christophmuellerorg/VoronUsers/printer_mods/README.md

# Mods

Printer mods for Voron 3D printers
Remember to update this README when uploading new mod!

## Legacy printers

Mods for legacy printers can be found [here](../legacy_printers/printer_mods).
If one of your mods applies to a current generation Voron printer, contact the admins in
Discord to have your mod moved to this folder.

## Table structure

Update the following table with the information about your mod:
- Your name
- A link to your sub-folder
- A short description of your mod
- The printer compatibility. Use `:heavy_check_mark:` for :heavy_check_mark:,`:x:` for :x: and `:grey_question:` for :grey_question:

like so:
`
| Creator | [Mod title](link) | Description | :x: | :x: | :x: |`

---

| Creator | Mod title | Description | V0 | V1.8 | V2.4 |
| --- | --- | --- | --- | --- | --- |
|aeresov|[TL filament sensor bracket](./aeresov/TL_filament_sensor_bracket)|A bracket for TL filament sensor to mount near stock spool holder. |:x:|:grey_question:|:heavy_check_mark:|
||[MeanWell UHP-xxx DIN mount](./aeresov/TL_filament_sensor_bracket)|A bracket for MeanWell UHP series PSU (200, 350 and 500) to mount it across 2 DIN rails.|:x:|:grey_question:|:heavy_check_mark:|
|arkeet|[Dial test indicator mount](./arkeet/dti-mount)|A toolhead mount for a dial test indicator, where the tip is located at the nozzle. |:x:|:heavy_check_mark:|:heavy_check_mark:|
|claytono|[Voron 2.4 Extrusion Jig](./claytono/2.4-extrusion-jig)|A jig help align extrusions to get a properly square frame |:x:|:x:|:heavy_check_mark:|
|Badnoob |[Precision AB Drive](./Badnoob/Precision_AB_Drive)|Changes the gearing for the AB drives to improve both resolution and torque, with a strenthened frame. |:grey_question:|:grey_question:|:heavy_check_mark:|
| |[Rail Alignment](./Badnoob/Rail_Alignment)|Tools and procedure to properly align the rails in 2.4 and Afterburner|:x:|:x:|:heavy_check_mark:|
|BlueBear|[Deck Panel Backpack](./BlueBear/Deck_Panel_Backpack)|A mounting alternative if you don't want to drill your deck panel | :heavy_check_mark: | :x: | :x: |
| d3nny | [Filtered Power Plug with RND_165-00057](./d3nny/mains_plug_panel_for_RND_165-00057) | Filtered Power Plug for RND 165-00057 and CAT6-Plug | :x: | :x: | :heavy_check_mark: |
|Dan88 |[V0 one-part Skirts](./Dan88/V0skirt) |One part Skirts for the V0 |:heavy_check_mark: |:x: |:x: |
|DorjeDorf | [Duet 3 6HC Din Bracket](./DorjeDorf/Duet_3_6HC_Din_Bracket) | V2.4 Duet 3 6HC Din Bracket | :x: | :x: | :heavy_check_mark: |
| |[Duet 3 3HC Din Bracket](./DorjeDorf/Duet_3_3HC_Din_Bracket) |  V2.4 Duet 3 3HC Din Bracket | :x: | :x: | :heavy_check_mark: |
|DrGhetto|[Ghetto Panels](./DrGhetto/GhettoPanels)|Printed panels for the Voron Zero|:heavy_check_mark:|:x:|:x:|
|eddie |[V1.8 12mm Z Mod](./eddie/V1.8_12mm_Z_Mod) |Add V1.8 option for 12mm Z rods |:x: |:heavy_check_mark: |:x: |
|edwardyeeks |[Decontaminator Purge Bucket & Nozzle Scrubber](./edwardyeeks/Decontaminator_Purge_Bucket_&_Nozzle_Scrubber) |Removeable purge bucket with nozzle scrubber |:x: |:heavy_check_mark: |:heavy_check_mark: |
| |[V2.4 Z Drive Motor Tensioner Mod](edwardyeeks/V2.4_z_drive_motor_tensioner_mod) |Braced motor tensioner for z drive |:x: |:x: |:heavy_check_mark: |
| Ellis |[15x15 Drag Chain Ends](./Ellis/15x15_Drag_Chain_End) | 15x15 drag chain end pieces | :grey_question: | :grey_question: |:heavy_check_mark: |
| |[Badge Retractor Mount](./Ellis/Badge_Retractor_Mount) | Extrusion mount for badge retractor to keep bowden tube out of the way. | :grey_question: | :grey_question: |:heavy_check_mark: |
| |[Short Z Joints](./Ellis/Short_Z_Joints) | Shorter Z joints for the v2.4 |:x: |:x: |:heavy_check_mark: |
| FreeformFez | [V1.8 Filtered Power Inlet](./FreeformFez/FilteredPower) | V1.6 Filtered Inlet and Rocker Switch for V1.8 | :x: | :heavy_check_mark: | :x: |
| GSL12 | [Pocketwatch Nema 17](./GSL12/pocketwatch_nema17)| Extruder like Pocketwatch, but with Nema17 instead of Nema14. Maybe for V0 fork with 2020 extrusions, Nema17 and MGN9 or other printers. | :grey_question: | :grey_question: | :grey_question: |
| hartk1213 | [Voron0_deck_panel_with_logo_and_VORON0](./hartk1213/Voron0_deck_panel_with_logo_and_VORON0) | Used @Kruppes blank deck panel to add the logo as well as the name VORON0 | :heavy_check_mark:| :x: | :x: |
| | [Voron0_display_dualcolor](./hartk1213/Voron0_display_dualcolor) | Added a dual color file for the Voron Display Front housing | :heavy_check_mark:| :x: | :x: |
| | [Voron0_C14Inlet](./hartk1213/Voron0_C14Inlet) | Added a new Power inlet that uses a Fused C14 plug and switch that covers the mains contacts  | :heavy_check_mark:| :x: | :x: |
| | [Voron0_Hinged_Top_Hat](./hartk1213/Voron0_Hinged_Top_Hat) | Created a new hinged top hat design for the V0 so it can fold away when you dont want a top hat on  | :heavy_check_mark:| :x: | :x: |
| hernsl | [Bottom Panel Mag Clip](./hernsl/bottom_panel_mag_clip) | v2.4 magnetic clips to retain bottom panel | :x: | :x: | :heavy_check_mark: |
|hijax_pl_ |[Corner panel clip](./hijax_pl/corner_panel_clip) |V2 panel corner frames using 3-way L brackets in the corners |:x: |:x: |:heavy_check_mark: |
| |[Din Rail mount](./hijax_pl/din_rail_mount) |Adapter to attach DIN Rail to 2020 extrusion. |:x: |:x: |:heavy_check_mark: |
| |[Controler Board adapters](./hijax_pl/ender_compatible_controller_mount) |DIN (rotated) and legacy adapters for boards like SKR mini E3. |:grey_question: |:x: |:heavy_check_mark: |
|Iakabos| [c920_Mount](./Iakabos/C920_mount)|Slim mount for logitech c920 webcam|:x:|:heavy_check_mark:|:heavy_check_mark:|
| | [V0 beltchains](./Iakabos/V0_beltchain)|Modified beltchain parts for V0 Z cables|:heavy_check_mark: |:x: |:x: |
|jasonc |[V2.4 Z-Idler Shoulder Bolt Mod](./jasonc/Z_Idler_Shoulder_Bolt) |Modification to the idler carriers to accept a 25mm shoulder bolt. Ideal for Gates idlers. |:x: |:x: |:heavy_check_mark: |
| kirby | [V0 Sherpa Mini Direct Drive Mod](./kirby/v0_sherpa_mini_direct_drive)| A direct drive mod for the V0 using the Annex Sherpa Mini extruder | :heavy_check_mark: | :x: | :x: |
|Kruppes |[V0 Printed Deck with inserts](./Kruppes/Deck_Panel_inserts_logo) |Electronics Deck Panel using brass heat inserts. Optional with accent color Voron Logo. |:heavy_check_mark: |:x: |:x: |
| |[Encosed Bottom](./Kruppes/Closed_Bottom) | Modified printed parts and panel to fully enclose V0. |:heavy_check_mark: |:x: |:x: |
|littleferris |[V0 c14 Skirt Inlet](./littleferris/V0_Skirt_Inlet) |V0 C14 Skirt inlet |:heavy_check_mark: |:x: |:x: |
|madros |[V0 OLED-skirt](./madros/V0_skirt_OLED) |V0 skirt with 0.96" OLED|:heavy_check_mark: |:x: |:x: |
|MarcPot |[UHP PSU Bracket Clip](./MarcPot/UHP_PSU_Bracket_Clip)|DIN rail mount for the Mean Well UHP series PSU. |:grey_question: |:grey_question: |:heavy_check_mark: |
| |[Hour Counter Skirt + Keystone Skirt](./MarcPot/Skirt_Mods)|Skirt mod for a mechanical hour counter and keystone inserts |:x: |:x: |:heavy_check_mark: |
|mjoaris |[10x11 Cable Chain Endcaps](./mjoaris/10x11_Cable_Chain_Endcaps) |Printable Endcaps for 10x11 Cable Chains |:x: |:heavy_check_mark: |:heavy_check_mark: |
| |[Mini12864 LCD Mount](./mjoaris/Mini12864_LCD_Mount_for_V2.4) |Swiveling case for the Fysetc Mini12864 LCD |:x: |:grey_question: |:heavy_check_mark: |
|Mosher|[Door hinges with M3 screws shafts](./mosher/m3_door_hinges) |Simple mod of print in place door hinges, which uses m3 screws as shafts. |:x:|:x:|:heavy_check_mark:|
|natewalck |[V1.8 Jigs](./natewalck/v1.8_Jigs) |Jigs for assembling V1.8 |:x: |:heavy_check_mark: |:x: |
|Nomsplease |[60mm Shaft Jig](./Nomsplease/60mm_Shaft_Jig) |Simple jig for cutting and grinding 60mm Z shafts |:x: |:x: |:heavy_check_mark: |
| |[Duet Wifi Mount](./Nomsplease/V0_Mods/duet_wifi_mount) | Duet wifi mount in pocketwatch location |:heavy_check_mark: |:x: |:x: |
| |[LED Mounts](./Nomsplease/V0_Mods/led_mounts) | Basic LED mounts for 10 and 12mm strips |:heavy_check_mark: |:x: |:x: |
| |[Remixed Panel Mounts](./Nomsplease/V0_Mods/panel_mounts) | Remixed rear bottom panel mounts with stop |:heavy_check_mark: |:x: |:x: |
| |[Pi Cam/ZeroW Mount](./Nomsplease/V0_Mods/pi_zero_camera_mount) | Mount for pi camera and ZeroW |:heavy_check_mark: |:x: |:x: |
| |[Pocket Watch Rear Reolcation Bracket](./Nomsplease/V0_Mods/pocket_watch_rear_relocation) | Pocket watch rear reolcation bracket |:heavy_check_mark: |:x: |:x: |
|randell |[Door Hinges](./randell/Door_Hinges) |Door hinges that use an M3 bolt for a pin and bolts thru the panel |:x: |:x: |:heavy_check_mark: |
||[Microswitch Pod for PCB](./randell/Microswitch_Endstop) |Modified endstop pod for use of endstop switches mounted on a PCB |:x: |:x: |:heavy_check_mark: |
| raymondh | [Large Spool Holders](./raymondh/LargeSpoolHolders) | Larger spool holders for KVP spools | :x: | :heavy_check_mark: | :heavy_check_mark: |
|Rhastlyn |[Wansview 1080p Camera Mount](./Rhastlyn/WansviewCameraMount) |A camera mount that replaces the OEM part to allow the camera to be mounted to a 2020 extrusion | :x: |:grey_question: |:heavy_check_mark: |
| |[60mm Fan Cover](./Rhastlyn/60mmFanCover)|A easy to install cover for spec 60mm fans originally designed for a 2.4 build| :x: |:grey_question: |:heavy_check_mark: |
| Slidr | [PanzerChain 2.4](./Slidr/PanzerChain2.4) | Energychain for V2.4 | :x: | :x: | :heavy_check_mark: |
| Spaghetti-Bolognese |[Simplified Z Drive Motor Mount](Spaghetti-Bolognese/Z_drive_motor_mount) | Z drive motor mount bracket mod to improve pulley to belt alignment | :x: | :x: | :heavy_check_mark: |
| |[LCD Case Mod](Spaghetti-Bolognese/LCD_case_mod) | Improvements to the V2.4 mini12864 LCD case inc E-stop button cover | :x: | :x: | :heavy_check_mark: |
|StvPtrsn |[Skirts for a 320mm Build](./StvPtrsn/320mm_Build) |Skirts for a 320mm build |:x: |:x: |:heavy_check_mark: |
| |[Keystone Jack for Filtered Mains Panel](./StvPtrsn/Keystone_Jack_Filtered_Mains_Panel) |Add a keystone jack to your filtered mains plug panel |:x: |:x: |:heavy_check_mark: |
| |[Side Fan Support, No Tape](./StvPtrsn/Side_Fan_Support_No_Tape) |Mount the 60mm side fans and inserts without tape |:x: |:x: |:heavy_check_mark: |
| tameike | [Din Rail SKR 90 deg](./tameike/DIN_Rail_SKR_1.3_90deg) | SKR V1.3 bracket turned 90 degrees | :x: | :grey_question: | :heavy_check_mark: |
| | [Din Rail 2020 Holder](./tameike/DIN_Rail_2020_holder) | Attaching DIN Rails to 2020 | :x: | :grey_question: | :heavy_check_mark: |
| | [TacoRaven Mounting Frame](./tameike/V0_TR_Mounting_Frame) | TR V0 mount | :heavy_check_mark: | :x: | :x: |
| | [Jetpack V0 base](./tameike/Jetpack_V0)| Attach Jetpack to V0 frame | :heavy_check_mark: |:x: |:x: |
| tayto-chip | [V2.4 Skirt Switch Mod](./tayto-chip/skirt_switch_mod) | Add a ON/OFF Switch to side or front skirts| :x: | :x: | :heavy_check_mark: |
| warriorofwire | [Slenderfan for Afterburner](./warriorofwire/slenderfan) | Lighter, quieter, smaller Afterburner | :x: | :x: | :heavy_check_mark: |
| Weaslus | [Electronics Bay and Enclosure Seperator](./Weaslus/Electronics-Bay-Seperator) | Better enclose chamber and keep heat from electronics | :heavy_check_mark: | :x: | :x: |
| xbst_ | [PCB LED Holder](./xbst_/LED_Holder)| Very simple mount for some (?) PCB LED Bars | :x: |:heavy_check_mark: |:heavy_check_mark: |
| | [DIN Mount Omron Relay](./xbst_/Omron_DIN_Mount)| A simple DIN rail mount for the BOM Relay | :x: | :heavy_check_mark: |:heavy_check_mark: |
| | [DIN Mount Pi 4x Relay Board](./xbst_/Relay_DIN_Mount)| A simple DIN rail mount for the 4 channel relay board for Raspberry Pi | :x: | :heavy_check_mark: |:heavy_check_mark: |
| | [DIN Mount Max31865](./xbst_/Max31865_DIN_Mount)| A simple DIN rail mount for the Adafruit (or SAME SIZE clone) MAX31865 PT100 Board. | :x: | :heavy_check_mark: |:heavy_check_mark: |
| | [Car Hood Style Bed Hinge](./xbst_/Bed_Hinge)| A way of reaching electronics from the top by having a "car hood" style hinge for the heatbed, and rotated electronics mounts. | :x: | :x: |:heavy_check_mark: |
| | [Flat V2.4 Skirts](./xbst_/Flat_Skirts) | Flat V2.4 Skirts so a panel without cutouts can be used | :x: | :x: |:heavy_check_mark: |
| | [V2.4 Fanless Middle Skirt](./xbst_/V2.4_Fanless_Middle_Skirt)| A Fanless alternative middle side skirt | :x: | :x: |:heavy_check_mark: |
| | [Duct Mount](./xbst_/Duct_Mount) | 100mm/4" ducting mount for ventilation. Also supports umbilical cord and has 3 orientations for bowden adapter. | :x: | :x: |:heavy_check_mark: |
| | [HOYMK SSR Mount](./xbst_/HOYMK_SSR_Mount) | Mount for Chinese HOYMK SSR | :heavy_check_mark: | :x: | :x: |
| | [ADXL345 V0 Mount](./xbst_/ADXL345_V0_Mount) | V0 Mount for a ADXL345 module | :heavy_check_mark: |:x: |:x: |
| | [Easy Access Rear Panels](./xbst_/Easy_Access_Rear_Panels_v0) | New rear panels designed to expose the extruder for easy filament swapping | :heavy_check_mark: | :x: |:x: |
| | [Hat LED Mount](./xbst_/Hat_LED_Mount) | Top Hat LED module mount | :heavy_check_mark: |:x: |:x: |
| | [ZipClip V0](./xbst_/ZipClip_v0) | Very simple ziptie mount for v0 1515 extrusions | :heavy_check_mark: |:x: |:x: |
| | [Screwed Front Door Hinge](./xbst_/V0_Screw_Front_Hinge_Mod)| Mod to screw the front door panel (instead of VHB) | :heavy_check_mark: | :x: | :x: |
| | [DuetZero](./xbst_/DuetZero) | Pi Zero mount over a Duet2 for space saving | :heavy_check_mark: |:heavy_check_mark: |:heavy_check_mark: |

---
