christophmuellerorg/VoronUsers/printer_mods/Slidr/PanzerChain2.4/OverviewLarge.JPG

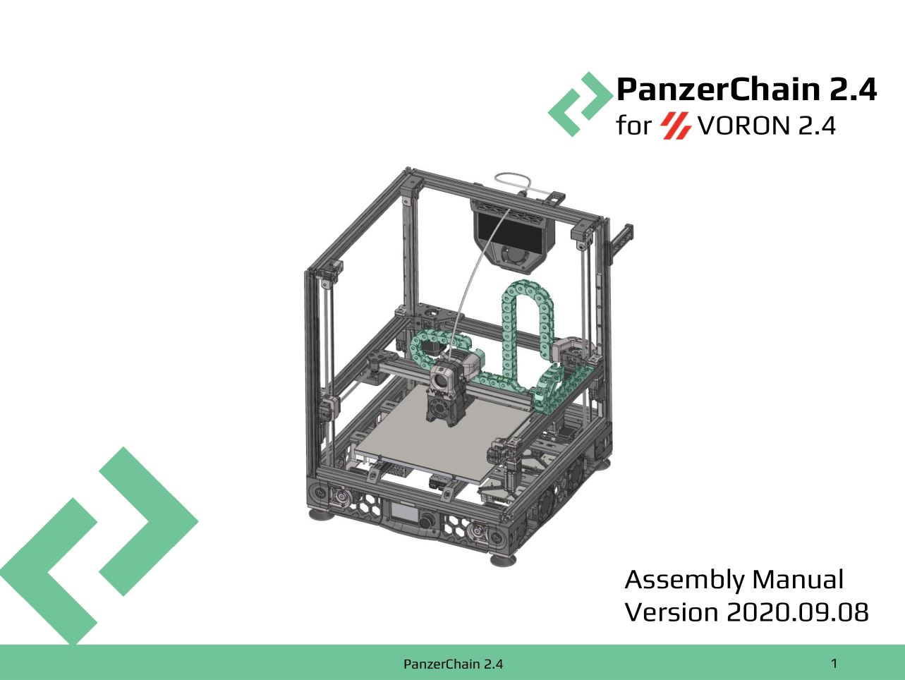
printer_mods/Slidr/PanzerChain2.4/OverviewLarge.JPG
