christophmuellerorg/VoronUsers/printer_mods/Weaslus/Electronics-Bay-Seperator/Seperator.png

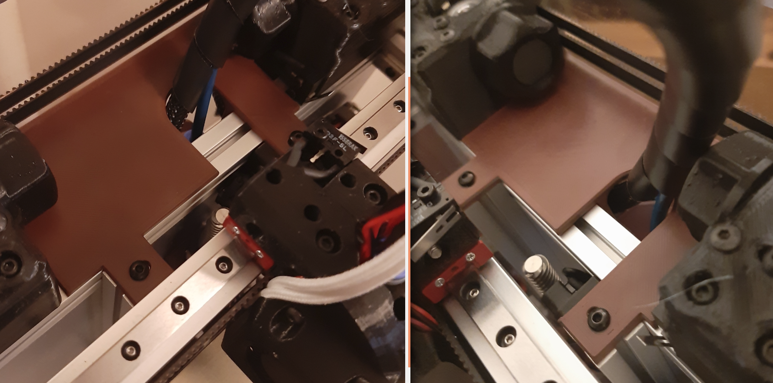
printer_mods/Weaslus/Electronics-Bay-Seperator/Seperator.png
