christophmuellerorg/VoronUsers/slicer_configurations/PrusaSlicer/hartk1213/V0/Bed_Shape/Images/screenshot.png

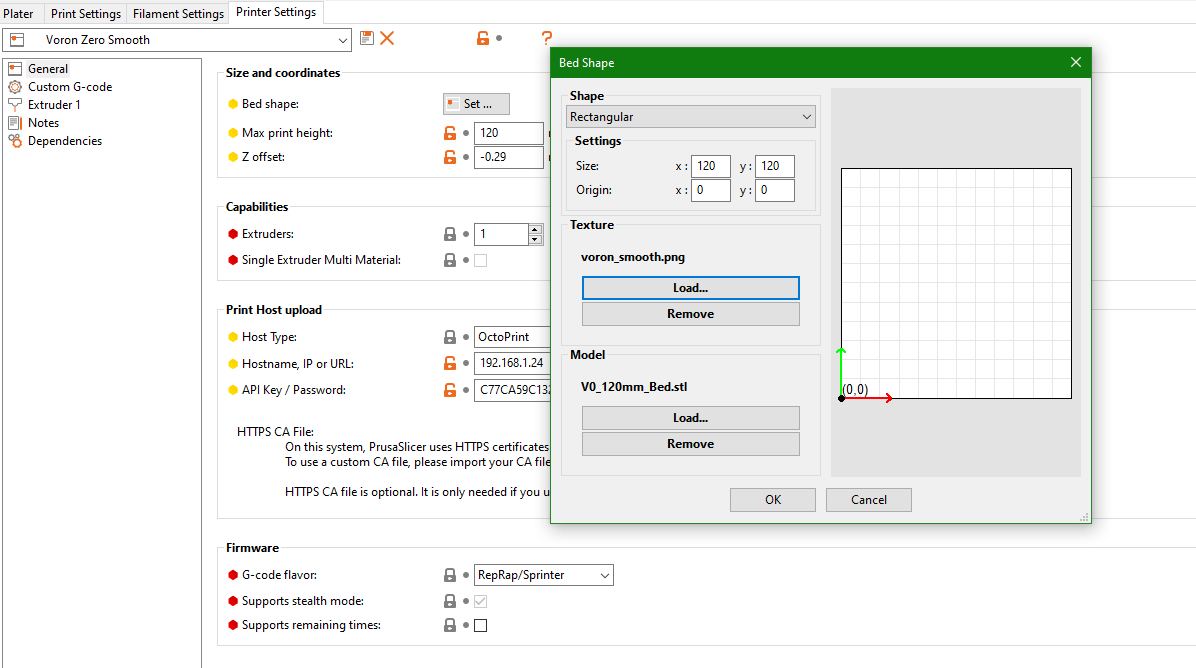
slicer_configurations/PrusaSlicer/hartk1213/V0/Bed_Shape/Images/screenshot.png
