christophmuellerorg/VoronUsers/slicer_configurations/PrusaSlicer/hartk1213/V0/Bed_Shape/Texture/voron_textured.png

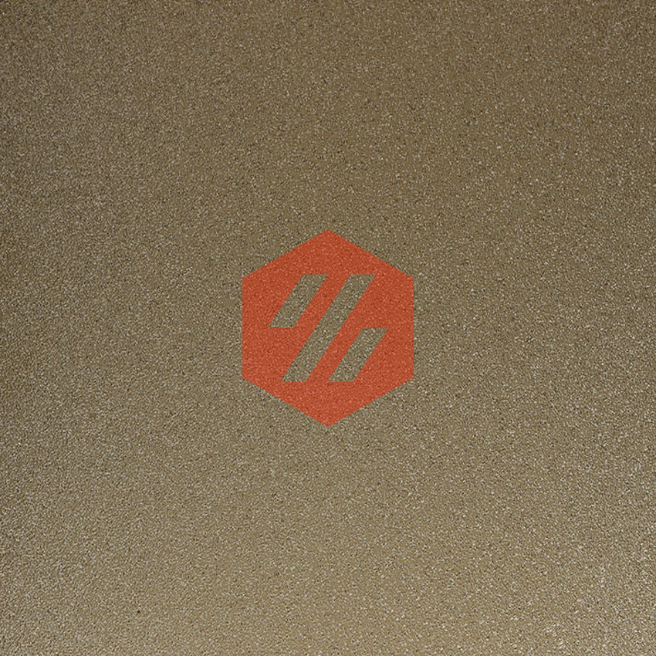
slicer_configurations/PrusaSlicer/hartk1213/V0/Bed_Shape/Texture/voron_textured.png
