christophmuellerorg/VoronUsers/slicer_configurations/Simplify3D/hijax_pl/beds/Voron2_beds.png

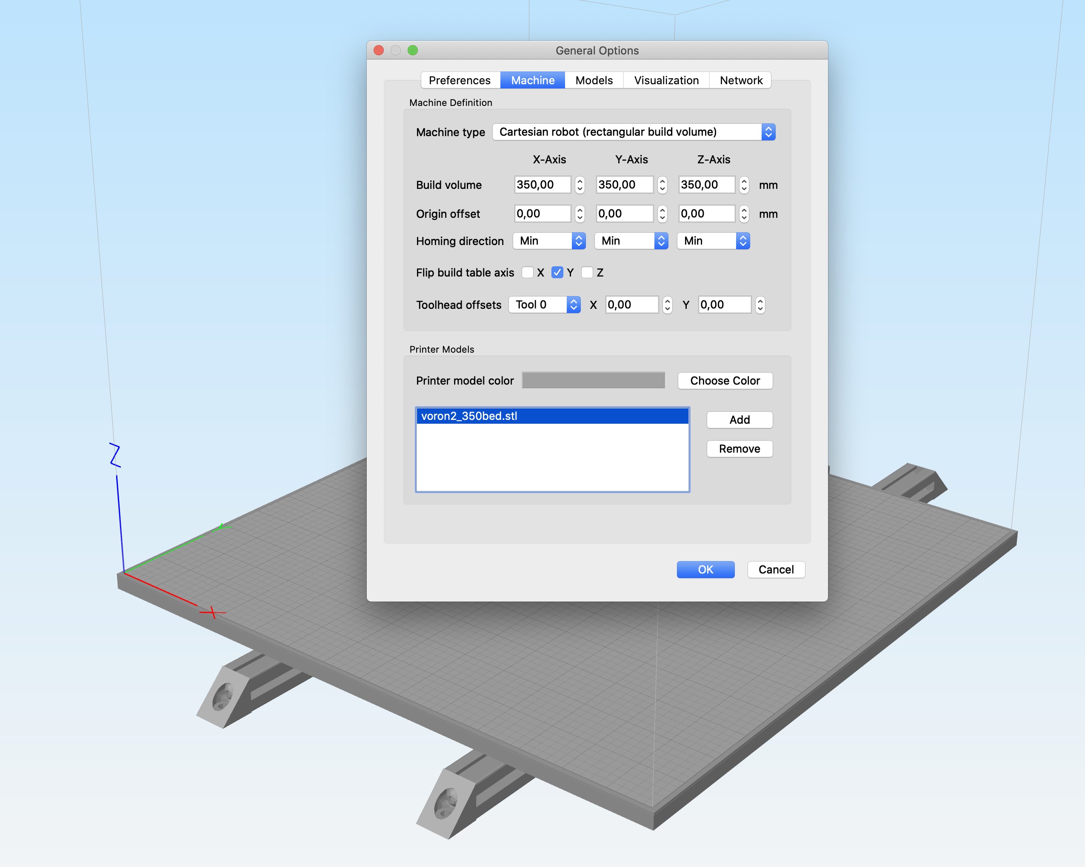
slicer_configurations/Simplify3D/hijax_pl/beds/Voron2_beds.png
