christophmuellerorg/VoronUsers/slicer_configurations/SuperSlicer/koonweee/beds/V1.8_SS_Bed.png

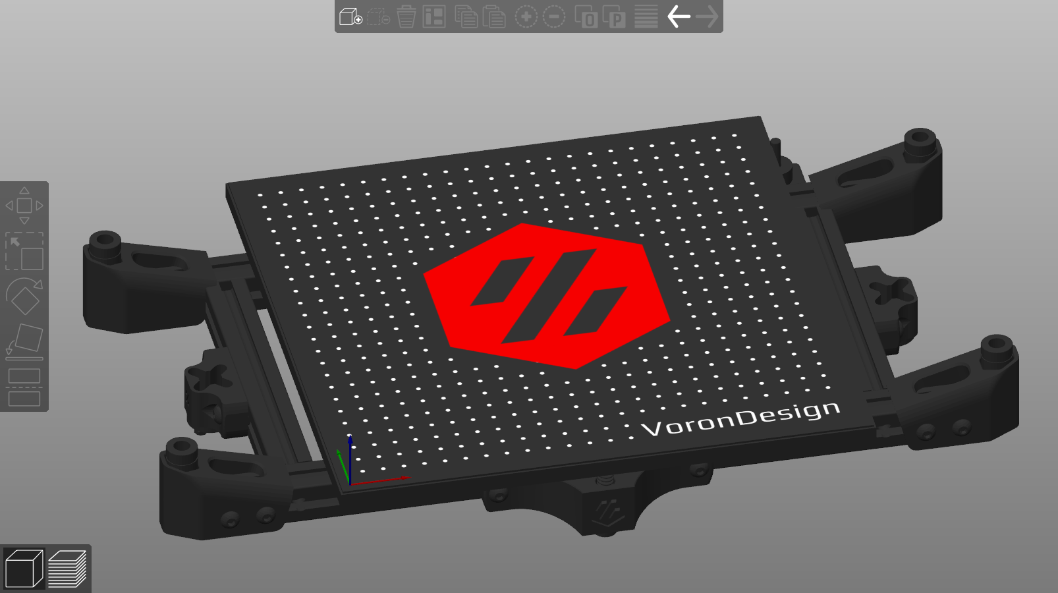
slicer_configurations/SuperSlicer/koonweee/beds/V1.8_SS_Bed.png
