christophmuellerorg/VoronUsers/printer_mods/hartk1213/Voron0_Hinged_Top_Hat/BOM/Voron0_Hinged_Top_Hat_BOM.xlsx

1515 Extrusions | Length | Qty
1515 x 200mm | 200 | 5 | 5
1515 X 170 | 170 | 2 | 2
1515 x 95 | 95 | 2 | 1
1515 x 80 | 80 | 2 | 1
Enclosure Panels
Location | Dimensions | Qty
Front | 212x76 | 1
Sides | 182x76 | 2
Top | 212x212 | 1
Rear | 212x59 | 1
BOM
Screws
Size | Qty
M3x8 | 62
M3x12 | 4
M3x16 | 2
M3x20 | 4
M3 Nuts | 58
