christophmuellerorg/VoronUsers/printer_mods/d3nny/mains_plug_panel_for_RND_165-00057/mains_plug_panel_filtered_for_RND_165-00057_V24.stl

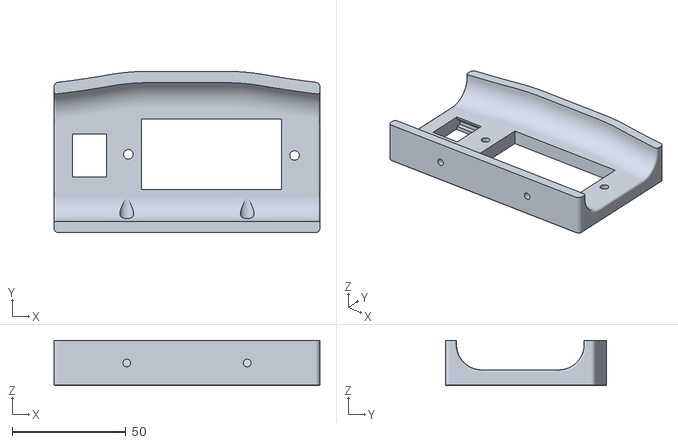
[picture p8: CAD file, 2020-11-01]
printer_mods/d3nny/mains_plug_panel_for_RND_165-00057/mains_plug_panel_filtered_for_RND_165-00057_V24.stl
117.0 x 71.0 x 20.0
