christophmuellerorg/VoronUsers/printer_mods/eddie/V1.8_12mm_Z_Mod/CAD/Z_Shaft_Assembly_12mm v8.step

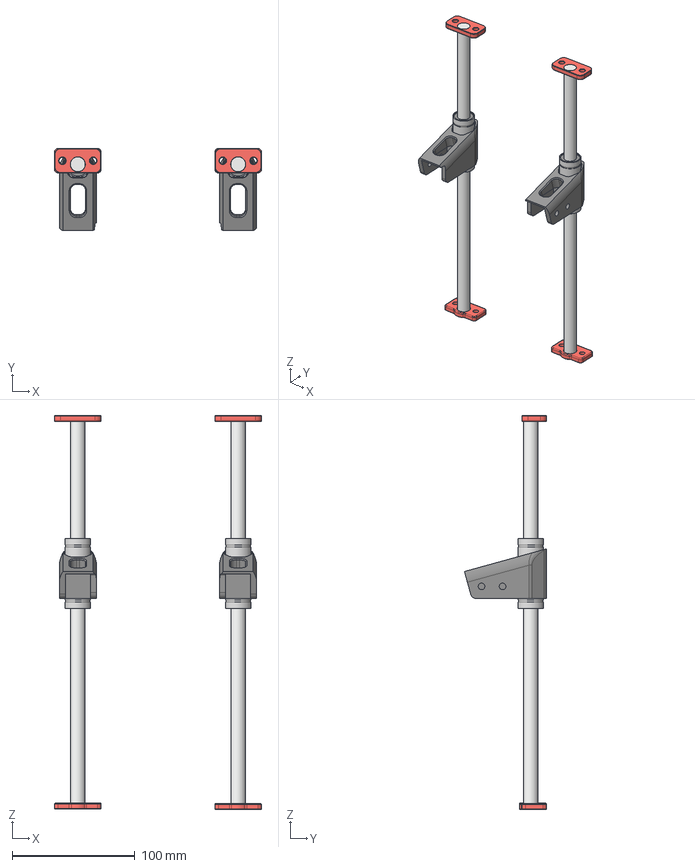
[picture p9: CAD file, 2020-11-01]
printer_mods/eddie/V1.8_12mm_Z_Mod/CAD/Z_Shaft_Assembly_12mm v8.step
168.4 x 66.8 x 320.4 mm
Z_Shaft_Retainer_12mm x 2
12mm 320mm Rod x 2
LM12LUU x 2
Z_Shaft_Retainer_12mm-Alt x 2
