christophmuellerorg/VoronUsers/printer_mods/Nomsplease/V0_Mods/led_mounts/10mm_strip_mount_full.step

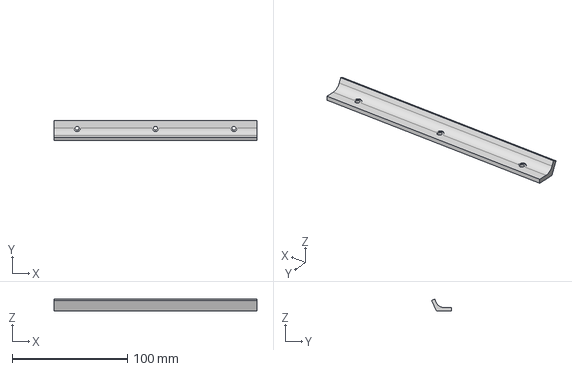
[picture p10: CAD file, 2020-11-01]
printer_mods/Nomsplease/V0_Mods/led_mounts/10mm_strip_mount_full.step
176.0 x 17.2 x 10.3 mm
