christophmuellerorg/VoronUsers/printer_mods/StvPtrsn/Keystone_Jack_Filtered_Mains_Panel/CAD/rear_skirt_filtered_mains_keystone.step

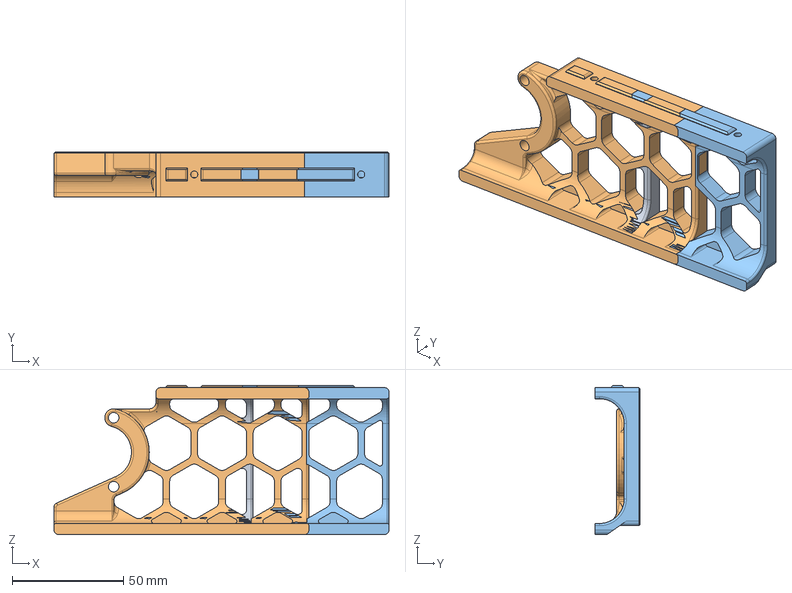
[picture p11: CAD file, 2020-11-01]
printer_mods/StvPtrsn/Keystone_Jack_Filtered_Mains_Panel/CAD/rear_skirt_filtered_mains_keystone.step
150.5 x 20.0 x 67.0 mm
