christophmuellerorg/VoronUsers/printer_mods/tameike/Jetpack_V0/Jetpack_main_body_1515.stl

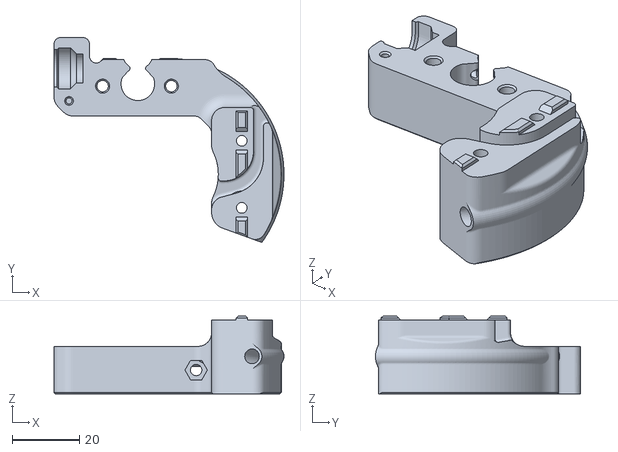
[picture p12: CAD file, 2020-11-01]
printer_mods/tameike/Jetpack_V0/Jetpack_main_body_1515.stl
68.6 x 61.1 x 23.2
