christophmuellerorg/VoronUsers/printer_mods/hartk1213/Voron0_C14Inlet/STLs/Voron0_C14Inlet_MainHousing.stl

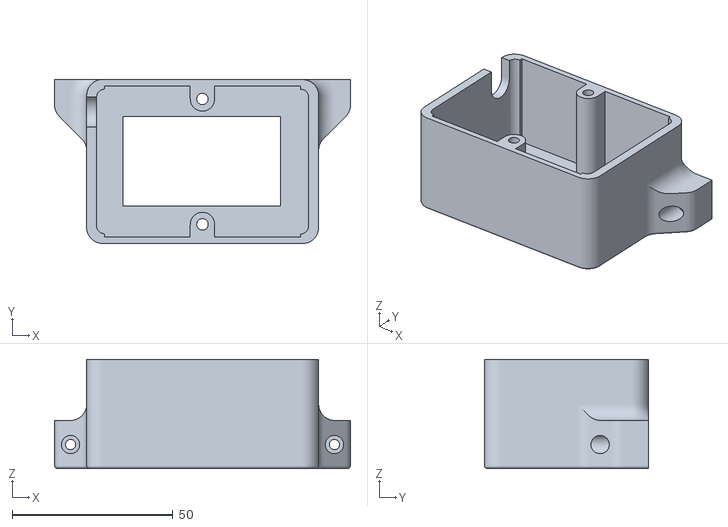
[picture p13: CAD file, 2020-11-01]
printer_mods/hartk1213/Voron0_C14Inlet/STLs/Voron0_C14Inlet_MainHousing.stl
92.0 x 51.1 x 34.0
