christophmuellerorg/VoronUsers/printer_mods/Nomsplease/V0_Mods/led_mounts/10mm_strip_mount_full_with_channel.step

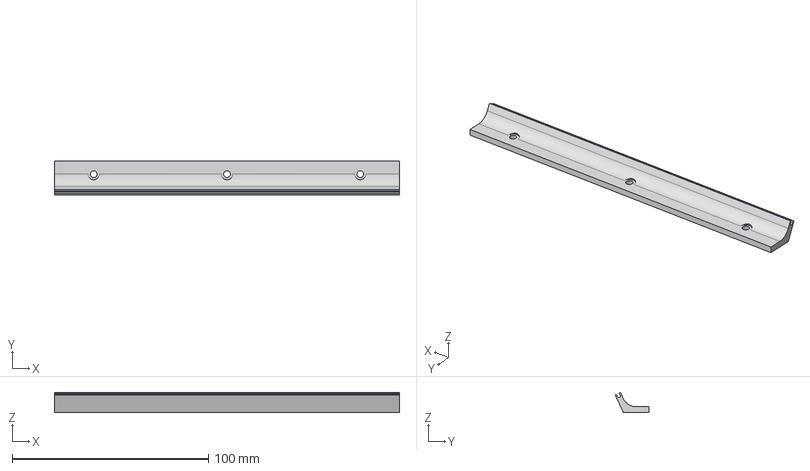
[picture p14: CAD file, 2020-11-01]
printer_mods/Nomsplease/V0_Mods/led_mounts/10mm_strip_mount_full_with_channel.step
176.0 x 17.2 x 10.3 mm
