christophmuellerorg/VoronUsers/printer_mods/StvPtrsn/Keystone_Jack_Filtered_Mains_Panel/CAD/plug_panel_filtered_mains_keystone.step

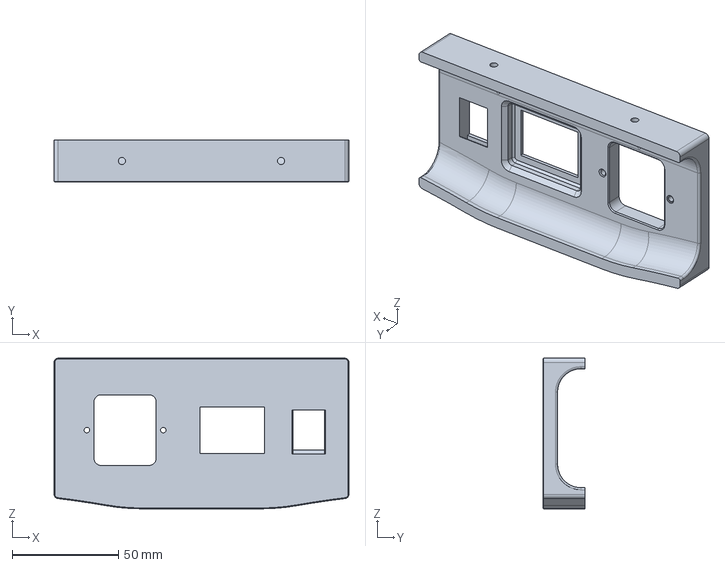
[picture p15: CAD file, 2020-11-01]
printer_mods/StvPtrsn/Keystone_Jack_Filtered_Mains_Panel/CAD/plug_panel_filtered_mains_keystone.step
139.0 x 20.0 x 71.0 mm
