christophmuellerorg/VoronUsers/printer_mods/aeresov/MeanWell_UHP_DIN_mount/STLs/UHP 350 series.stl

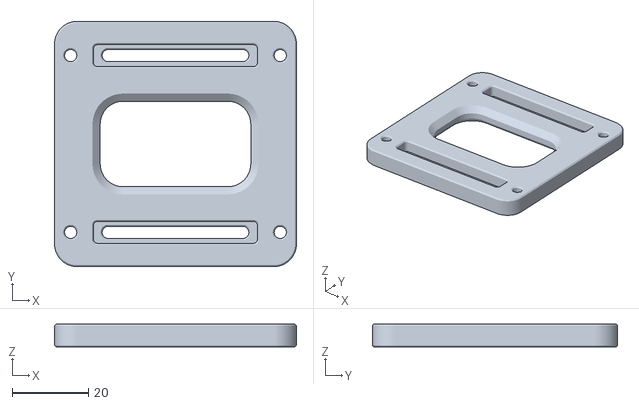
[picture p16: CAD file, 2020-11-01]
printer_mods/aeresov/MeanWell_UHP_DIN_mount/STLs/UHP 350 series.stl
63.5 x 64.4 x 6.00
