christophmuellerorg/VoronUsers/printer_mods/aeresov/TL_filament_sensor_bracket/STLs/TL filament sensor bracket.stl

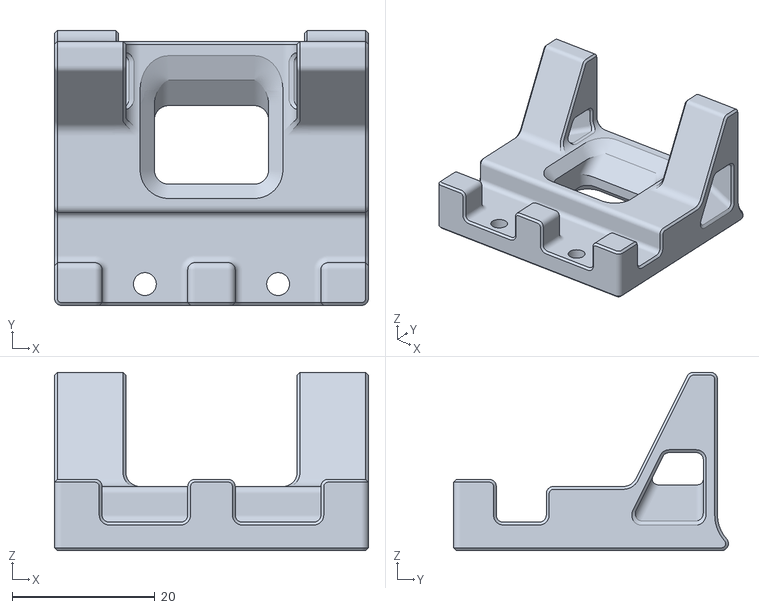
[picture p17: CAD file, 2020-11-01]
printer_mods/aeresov/TL_filament_sensor_bracket/STLs/TL filament sensor bracket.stl
44.0 x 38.5 x 25.0
