christophmuellerorg/VoronUsers/printer_mods/arkeet/dti-mount/dti-mount.step

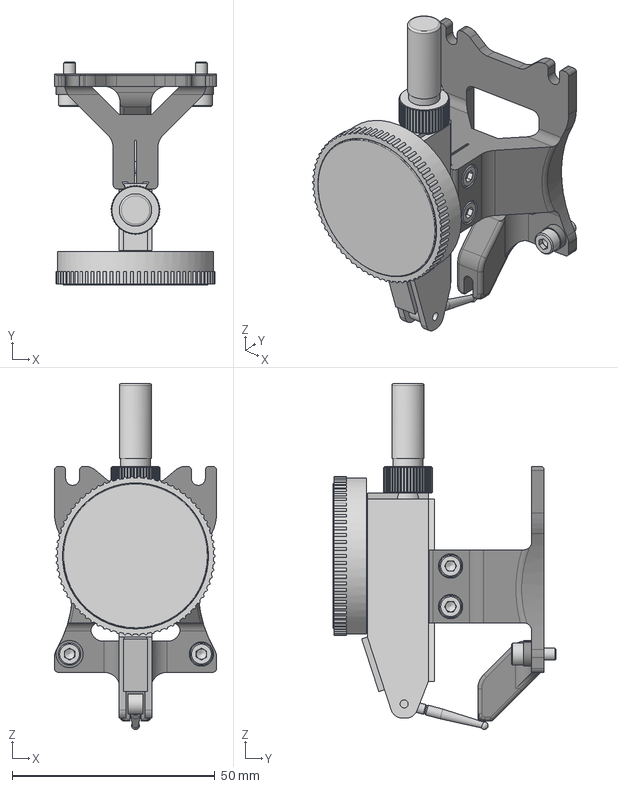
[picture p18: CAD file, 2020-11-01]
printer_mods/arkeet/dti-mount/dti-mount.step
40.0 x 55.0 x 85.3 mm
M3x8 SHCS x 4
M3 Hex Nut x 2
