christophmuellerorg/VoronUsers/printer_mods/Badnoob/Rail_Alignment/Dial_indicator_AB_beta.stl

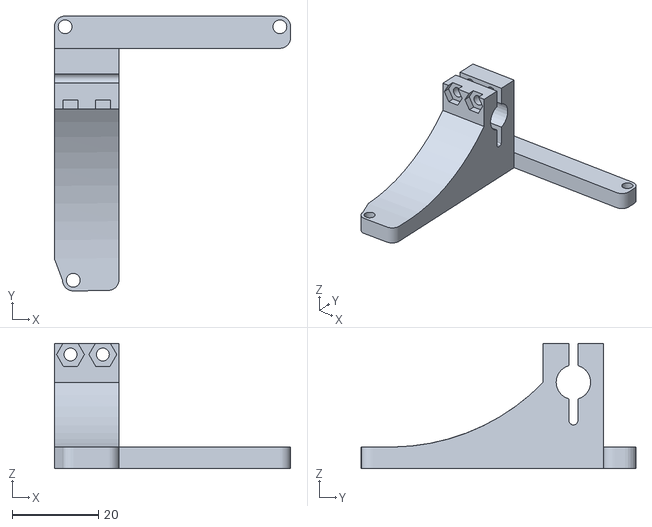
[picture p19: CAD file, 2020-11-01]
printer_mods/Badnoob/Rail_Alignment/Dial_indicator_AB_beta.stl
54.8 x 63.7 x 29.0
