christophmuellerorg/VoronUsers/printer_mods/BlueBear/Deck_Panel_Backpack/Deck_Panel_Backpack.step

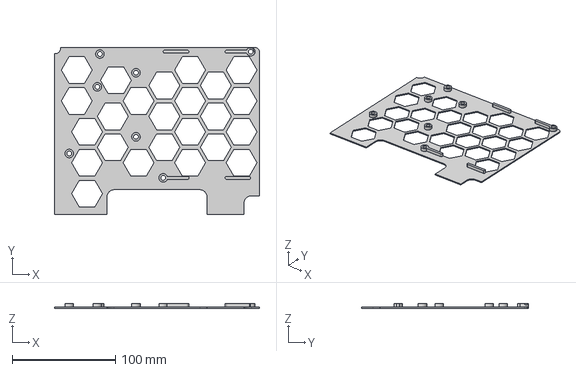
[picture p20: CAD file, 2020-11-01]
printer_mods/BlueBear/Deck_Panel_Backpack/Deck_Panel_Backpack.step
199.0 x 162.0 x 4.80 mm
