christophmuellerorg/VoronUsers/printer_mods/christophmueller/Voron0-Flippy-Spool-Holder/flippy_3mm_panel.stl

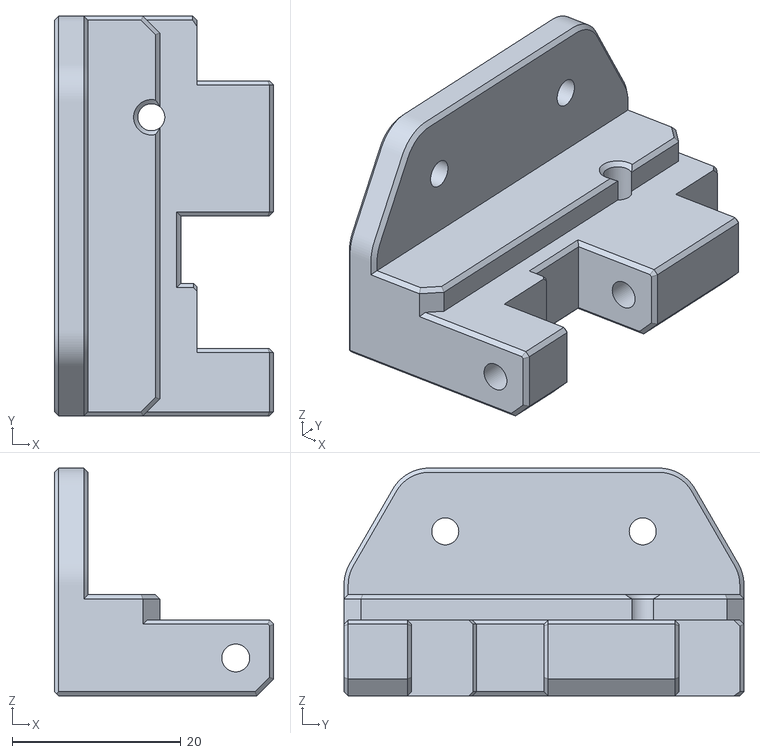
[picture p21: CAD file, 2020-11-19]
printer_mods/christophmueller/Voron0-Flippy-Spool-Holder/flippy_3mm_panel.stl
26.0 x 47.4 x 27.0
