christophmuellerorg/VoronUsers/printer_mods/christophmueller/Voron0-Integrated-Mini_12864/extended_feet.stl

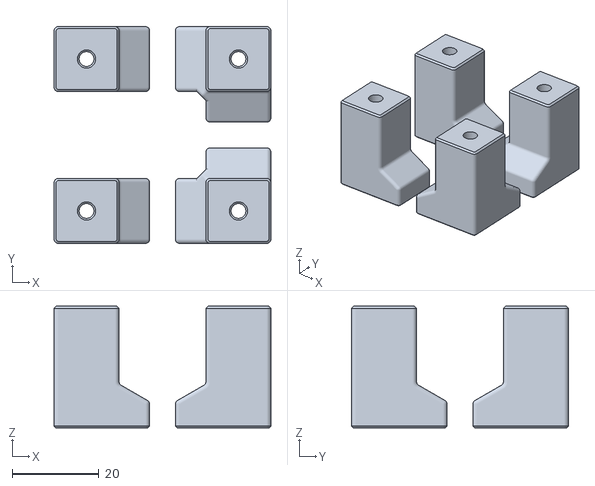
[picture p22: CAD file, 2020-11-19]
printer_mods/christophmueller/Voron0-Integrated-Mini_12864/extended_feet.stl
50.0 x 50.0 x 28.0
