christophmuellerorg/VoronUsers/printer_mods/claytono/2.4-extrusion-jig/jig.step

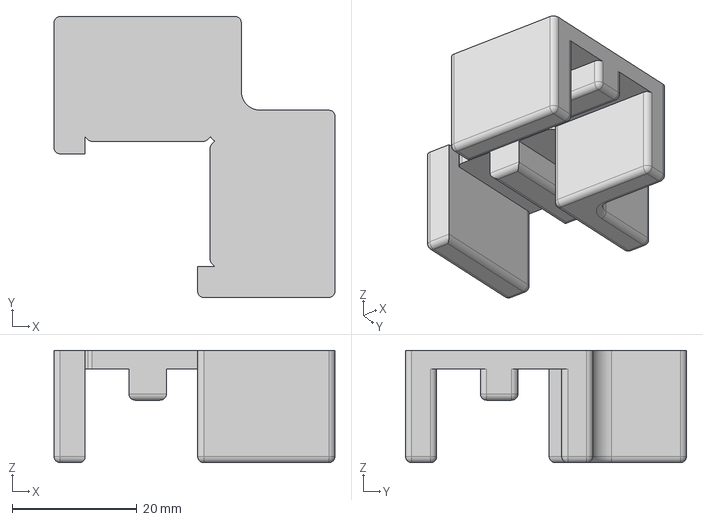
[picture p24: CAD file, 2020-11-01]
printer_mods/claytono/2.4-extrusion-jig/jig.step
45.0 x 45.0 x 18.0 mm
