christophmuellerorg/VoronUsers/printer_mods/Dan88/V0skirt/V0_skirts_onepart.stl

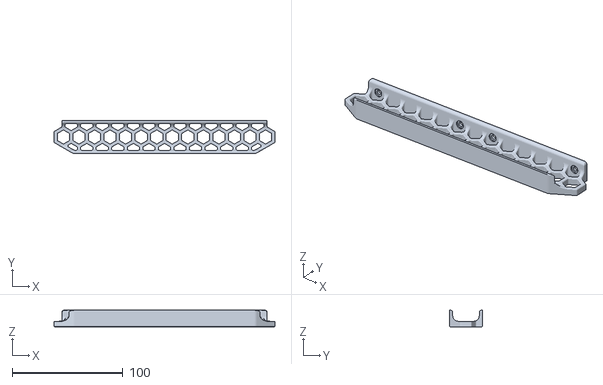
[picture p25: CAD file, 2020-11-01]
printer_mods/Dan88/V0skirt/V0_skirts_onepart.stl
200.0 x 30.0 x 15.0
