christophmuellerorg/VoronUsers/printer_mods/DorjeDorf/Duet_3_3HC_Din_Bracket/Duet_3_3HC_Bracket.stl

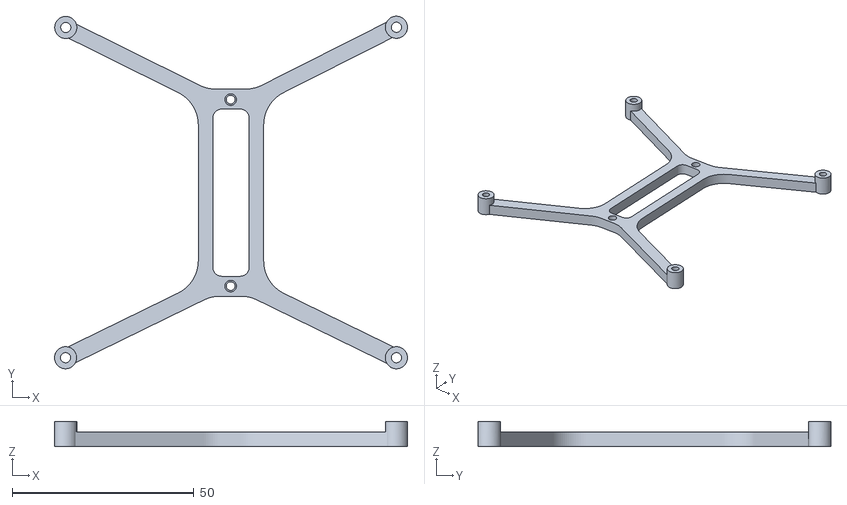
[picture p26: CAD file, 2020-11-01]
printer_mods/DorjeDorf/Duet_3_3HC_Din_Bracket/Duet_3_3HC_Bracket.stl
97.1 x 97.0 x 7.00
