christophmuellerorg/VoronUsers/printer_mods/DorjeDorf/Duet_3_6HC_Din_Bracket/Duet_3_6HC_Bracket.stl

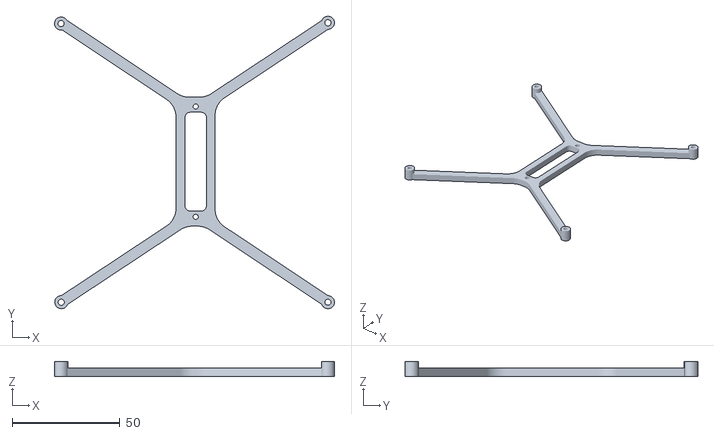
[picture p27: CAD file, 2020-11-01]
printer_mods/DorjeDorf/Duet_3_6HC_Din_Bracket/Duet_3_6HC_Bracket.stl
130.2 x 136.1 x 7.00
