christophmuellerorg/VoronUsers/printer_mods/DrGhetto/GhettoPanels/panel_hinge_bottom.stl

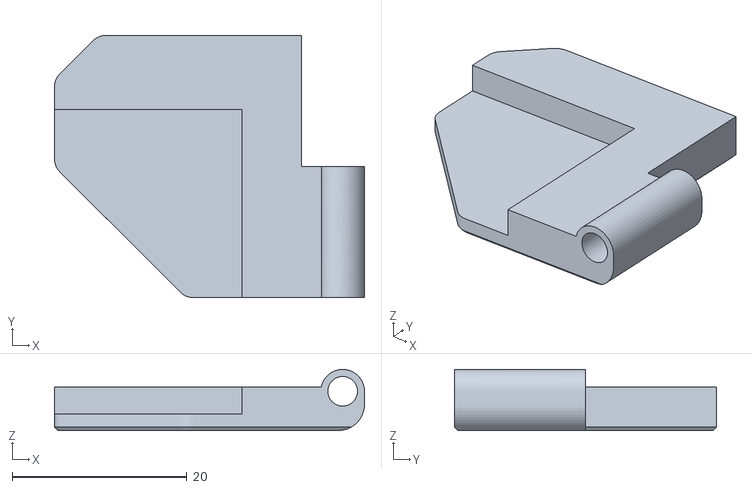
[picture p28: CAD file, 2020-11-01]
printer_mods/DrGhetto/GhettoPanels/panel_hinge_bottom.stl
35.5 x 30.0 x 7.00
