christophmuellerorg/VoronUsers/printer_mods/eddie/V1.8_12mm_Z_Mod/STLs/z_bearing_block_b_12mm_x2.stl

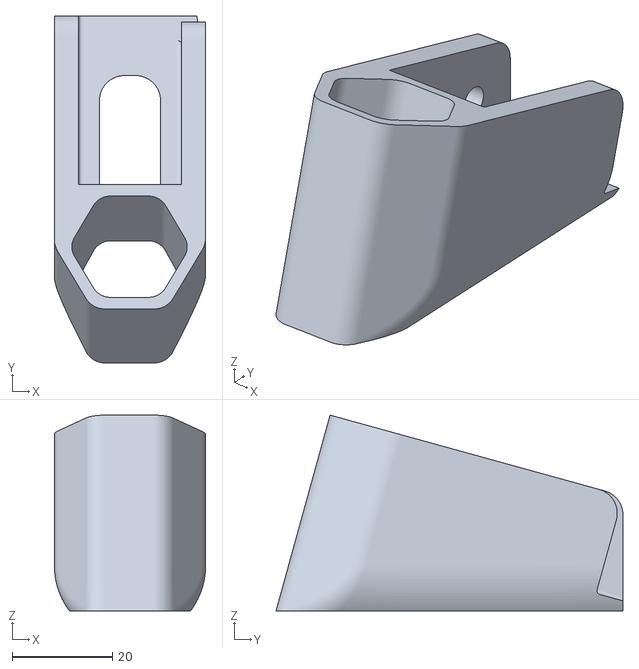
[picture p29: CAD file, 2020-11-01]
printer_mods/eddie/V1.8_12mm_Z_Mod/STLs/z_bearing_block_b_12mm_x2.stl
30.2 x 69.3 x 39.1
