christophmuellerorg/VoronUsers/printer_mods/edwardyeeks/Decontaminator_Purge_Bucket_&_Nozzle_Scrubber/CAD/extension_bracket_v1.8_rev4.step

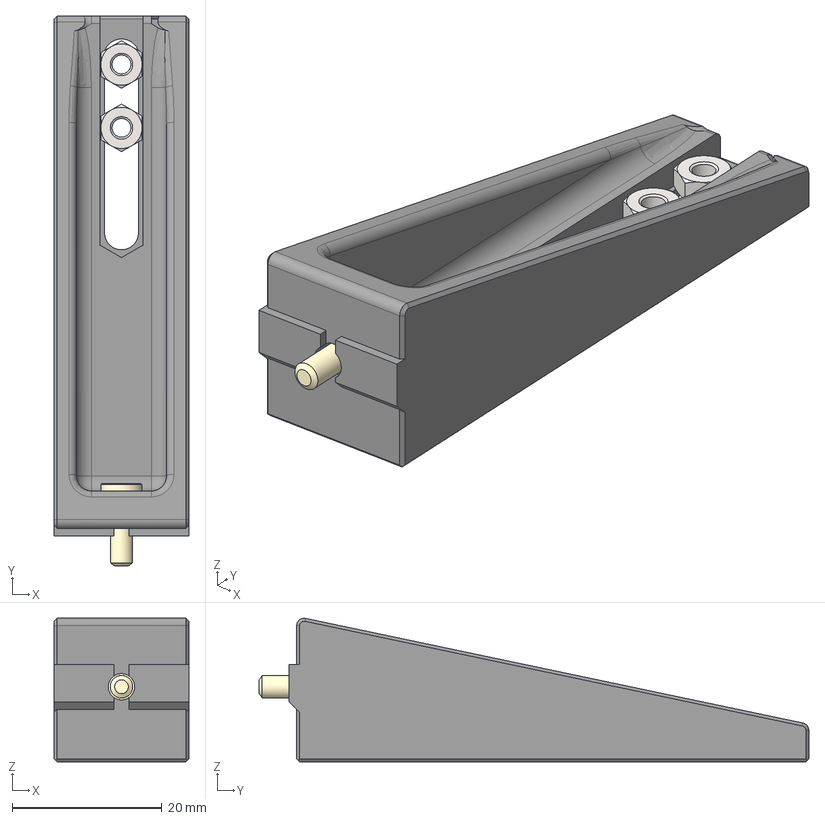
[picture p30: CAD file, 2020-11-01]
printer_mods/edwardyeeks/Decontaminator_Purge_Bucket_&_Nozzle_Scrubber/CAD/extension_bracket_v1.8_rev4.step
18.0 x 73.3 x 19.1 mm
hex nut style 1_am_B18.2.4.1M - Hex nut, Style 1, M3 x 0.5 --D-N x 2
extension_bracket
M3x8 SHCS (1)
