christophmuellerorg/VoronUsers/printer_mods/edwardyeeks/Decontaminator_Purge_Bucket_&_Nozzle_Scrubber/STLs/individual_sheetstop_v1.8_v2.4_rev4.stl

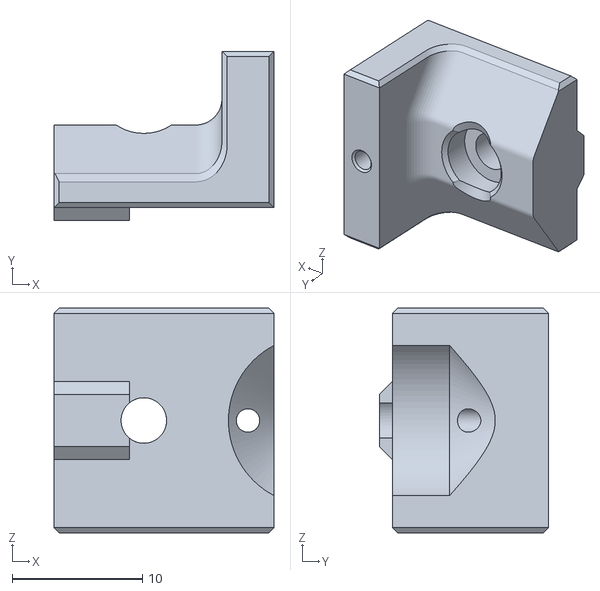
[picture p31: CAD file, 2020-11-01]
printer_mods/edwardyeeks/Decontaminator_Purge_Bucket_&_Nozzle_Scrubber/STLs/individual_sheetstop_v1.8_v2.4_rev4.stl
16.9 x 13.0 x 17.3
