christophmuellerorg/VoronUsers/printer_mods/edwardyeeks/V2.4_z_drive_motor_tensioner_mod/STLs/Skirts/250/250_front_rear_skirt_b_x2mod.stl

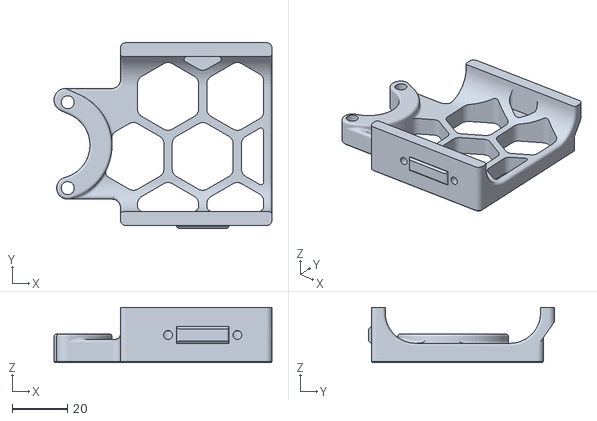
[picture p32: CAD file, 2020-11-01]
printer_mods/edwardyeeks/V2.4_z_drive_motor_tensioner_mod/STLs/Skirts/250/250_front_rear_skirt_b_x2mod.stl
78.7 x 67.0 x 20.0
