christophmuellerorg/VoronUsers/printer_mods/edwardyeeks/V2.4_z_drive_motor_tensioner_mod/STLs/Skirts/350/350_front_rear_skirt_a_x2_mod.stl

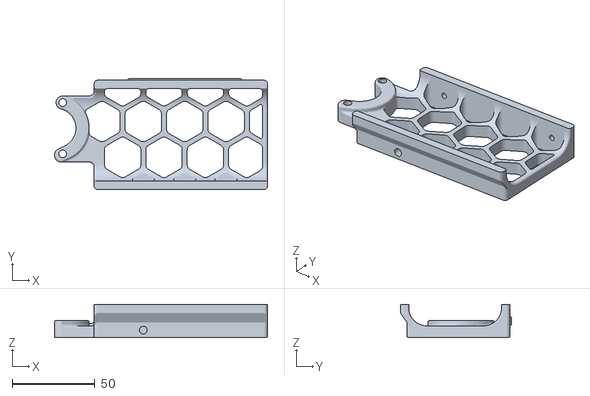
[picture p34: CAD file, 2020-11-01]
printer_mods/edwardyeeks/V2.4_z_drive_motor_tensioner_mod/STLs/Skirts/350/350_front_rear_skirt_a_x2_mod.stl
128.7 x 67.0 x 20.0
