christophmuellerorg/VoronUsers/printer_mods/edwardyeeks/V2.4_z_drive_motor_tensioner_mod/STLs/z_motor_mount_a_mod_x2.stl

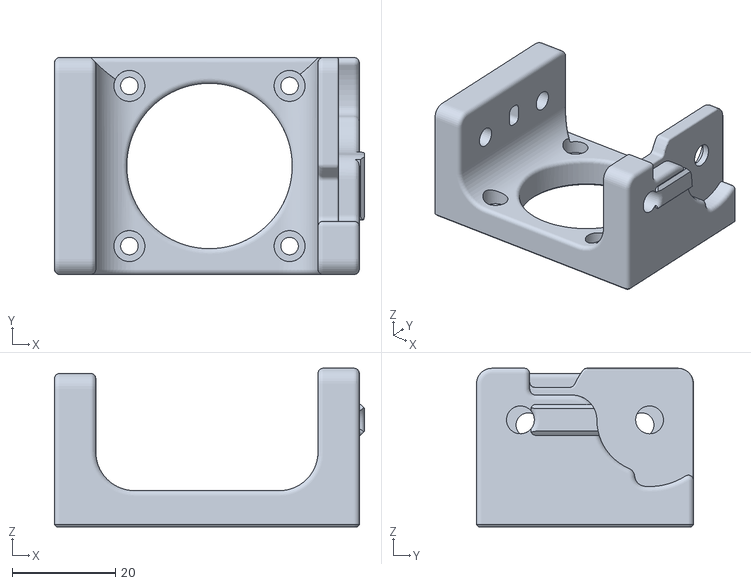
[picture p35: CAD file, 2020-11-01]
printer_mods/edwardyeeks/V2.4_z_drive_motor_tensioner_mod/STLs/z_motor_mount_a_mod_x2.stl
60.0 x 42.0 x 30.7
