christophmuellerorg/VoronUsers/printer_mods/Ellis/15x15_Drag_Chain_End/STL/15x15_Drag_Chain_End.stl

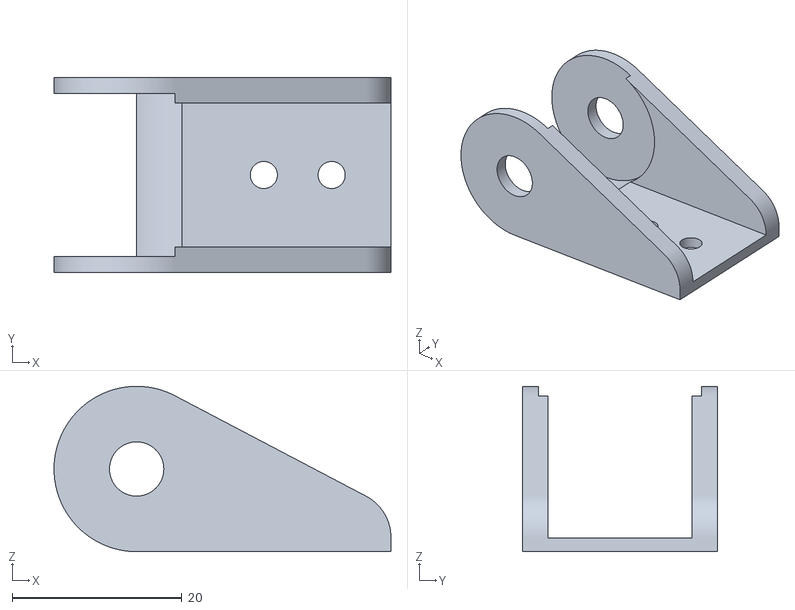
[picture p36: CAD file, 2020-11-01]
printer_mods/Ellis/15x15_Drag_Chain_End/STL/15x15_Drag_Chain_End.stl
39.7 x 23.0 x 19.5
