christophmuellerorg/VoronUsers/printer_mods/Ellis/Badge_Retractor_Mount/STL/RetractorMount.stl

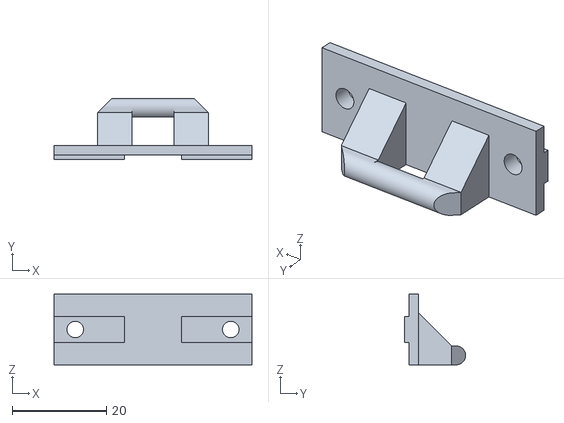
[picture p37: CAD file, 2020-11-01]
printer_mods/Ellis/Badge_Retractor_Mount/STL/RetractorMount.stl
42.0 x 13.0 x 15.0
