christophmuellerorg/VoronUsers/printer_mods/Ellis/Short_Z_Joints/STL/Z Bearing Block Bottom.stl

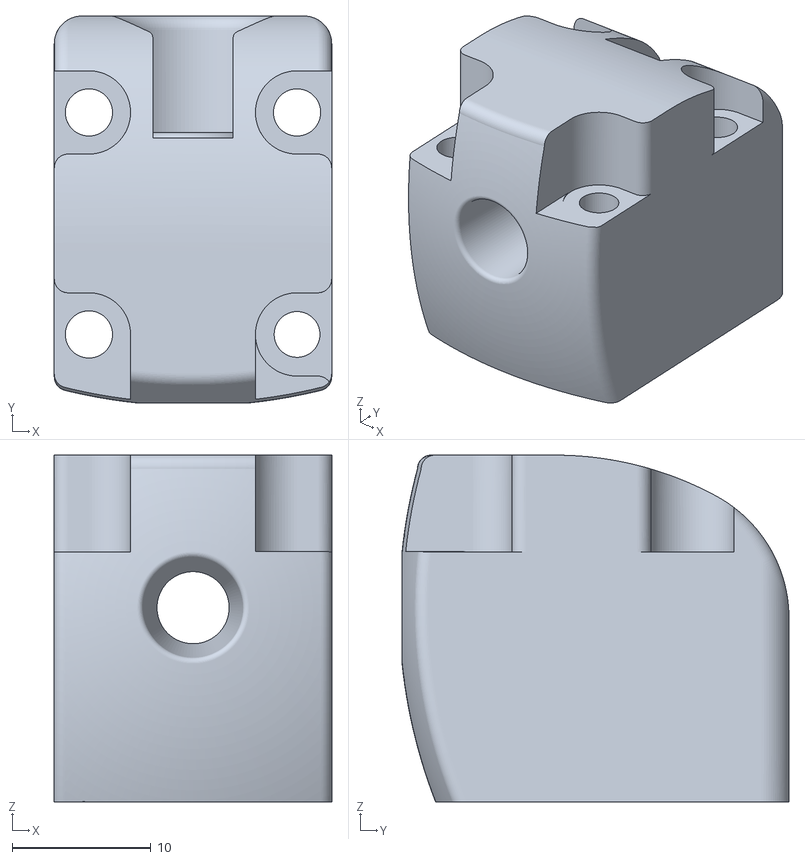
[picture p38: CAD file, 2020-11-01]
printer_mods/Ellis/Short_Z_Joints/STL/Z Bearing Block Bottom.stl
20.0 x 27.9 x 25.0
