christophmuellerorg/VoronUsers/printer_mods/FreeformFez/FilteredPower/skirt_250_filtered_power.stl

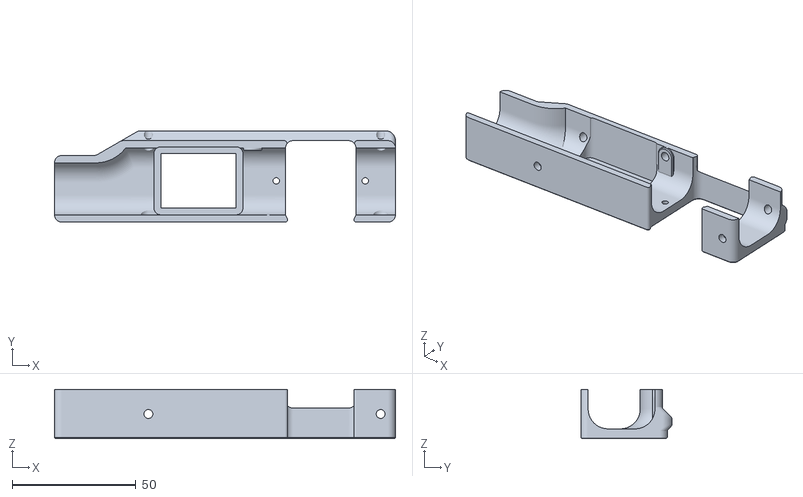
[picture p39: CAD file, 2020-11-01]
printer_mods/FreeformFez/FilteredPower/skirt_250_filtered_power.stl
138.0 x 37.0 x 20.0
