christophmuellerorg/VoronUsers/printer_mods/GSL12/pocketwatch_nema17/STL/VORON_Pocketwatch_Nema17_parts_mounting_bracket.stl

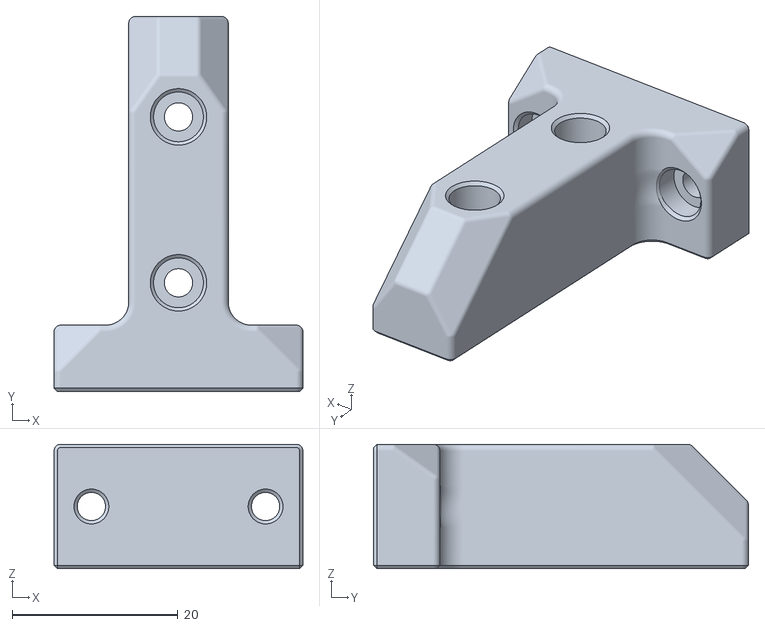
[picture p40: CAD file, 2020-11-01]
printer_mods/GSL12/pocketwatch_nema17/STL/VORON_Pocketwatch_Nema17_parts_mounting_bracket.stl
30.0 x 45.2 x 15.0
