christophmuellerorg/VoronUsers/printer_mods/hartk1213/Voron0_C14Inlet/STLs/Voron0_C14Inlet_RearCover.stl

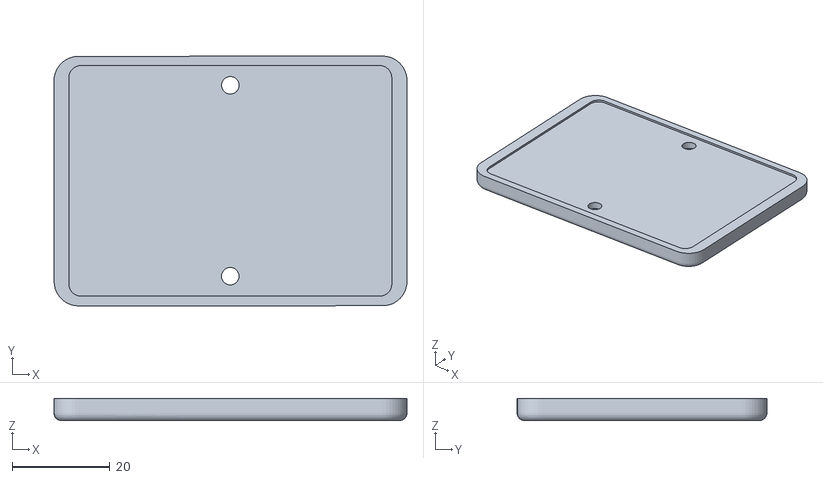
[picture p41: CAD file, 2020-11-01]
printer_mods/hartk1213/Voron0_C14Inlet/STLs/Voron0_C14Inlet_RearCover.stl
72.1 x 51.0 x 4.50
