christophmuellerorg/VoronUsers/printer_mods/hartk1213/Voron0_deck_panel_with_logo_and_VORON0/STLs/Voron0_deck_panel_with_logo_and_VORON0.stl

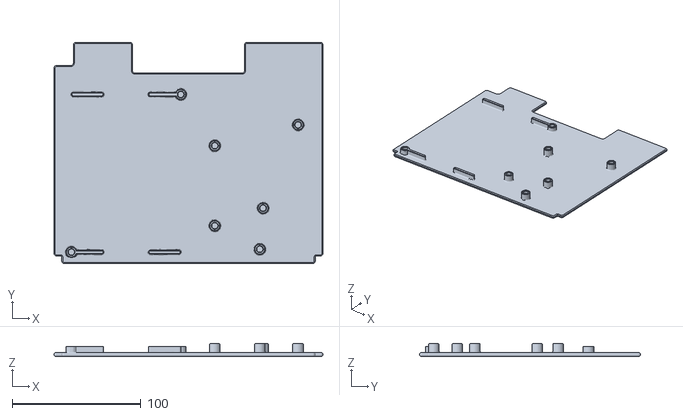
[picture p42: CAD file, 2020-11-01]
printer_mods/hartk1213/Voron0_deck_panel_with_logo_and_VORON0/STLs/Voron0_deck_panel_with_logo_and_VORON0.stl
209.0 x 172.0 x 9.80
