christophmuellerorg/VoronUsers/printer_mods/hartk1213/Voron0_display_dualcolor/STLs/[a]_logo.stl

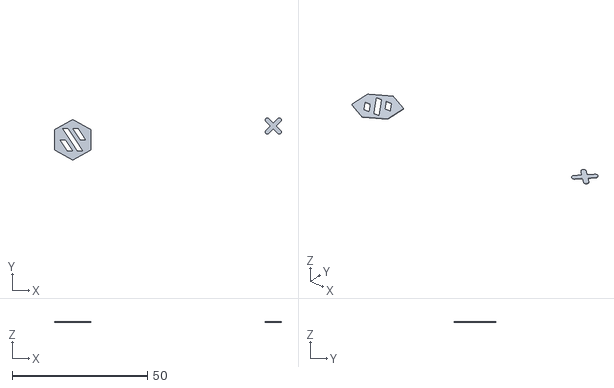
[picture p43: CAD file, 2020-11-01]
printer_mods/hartk1213/Voron0_display_dualcolor/STLs/[a]_logo.stl
83.8 x 15.6 x 0.398
