christophmuellerorg/VoronUsers/printer_mods/hartk1213/Voron0_Hinged_Top_Hat/CAD/v0_Hinged_TopHat.step

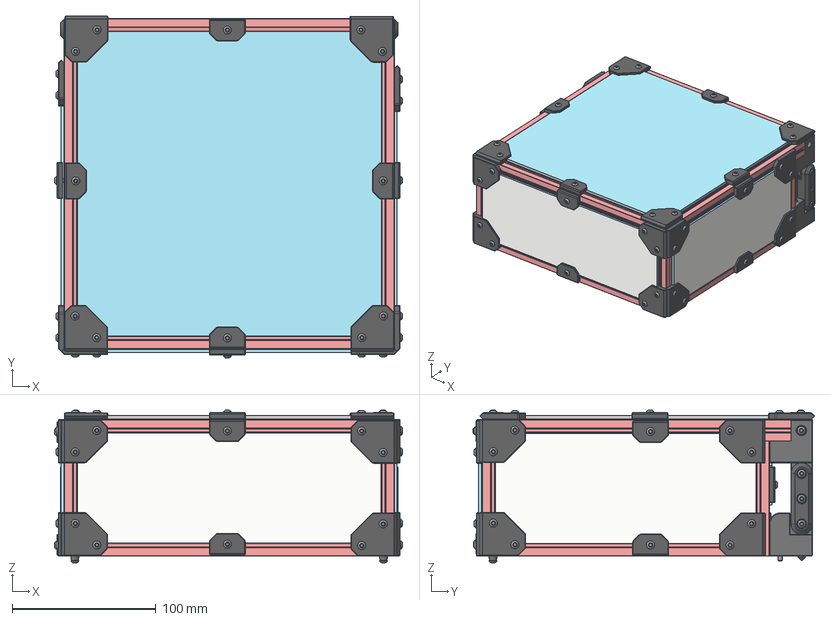
[picture p44: CAD file, 2020-11-01]
printer_mods/hartk1213/Voron0_Hinged_Top_Hat/CAD/v0_Hinged_TopHat.step
242.4 x 237.9 x 106.3 mm
1515_200mm x 6
1515_80mm x 2
1515_170mm x 2
1515_92mm x 2
Alignment Pin x 2
Bottom Hinge x 2
Middle_Hinge x 2
Top Hinge
Top Hinge (Mirror)
FrontPanel
SidePanel x 2
TopPanel
RearInnerPanel
Panel_Clip_Corner_Right x 10
Panel_Clip_Corner_Left x 10
Panel_Clip_Middle x 12
M3x20 BHCS_1 x 4
M3x16 BHCS_1 x 2
M3x12 BHCS_1 x 4
M3x8 BHCS_1 x 49
M3x8 BHCS v2
