christophmuellerorg/VoronUsers/printer_mods/hartk1213/Voron0_Hinged_Top_Hat/DXF/v0_Tophat_panels.dxf

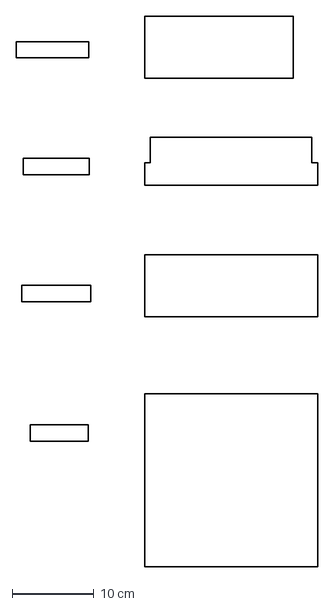
[picture p45: CAD file, 2020-11-01]
printer_mods/hartk1213/Voron0_Hinged_Top_Hat/DXF/v0_Tophat_panels.dxf
36.9 x 67.4 cm
