christophmuellerorg/VoronUsers/printer_mods/hartk1213/Voron0_Hinged_Top_Hat/STL/[a]_Hinge_Stop_x2.stl

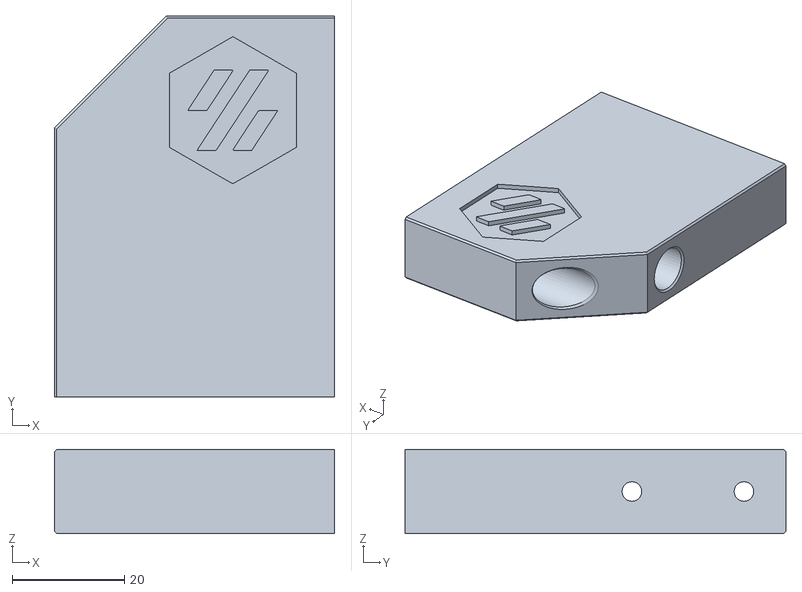
[picture p46: CAD file, 2020-11-01]
printer_mods/hartk1213/Voron0_Hinged_Top_Hat/STL/[a]_Hinge_Stop_x2.stl
50.0 x 68.0 x 15.0
