christophmuellerorg/VoronUsers/printer_mods/hernsl/bottom_panel_mag_clip/bottom_panel_magclip_skirt_x6.stl

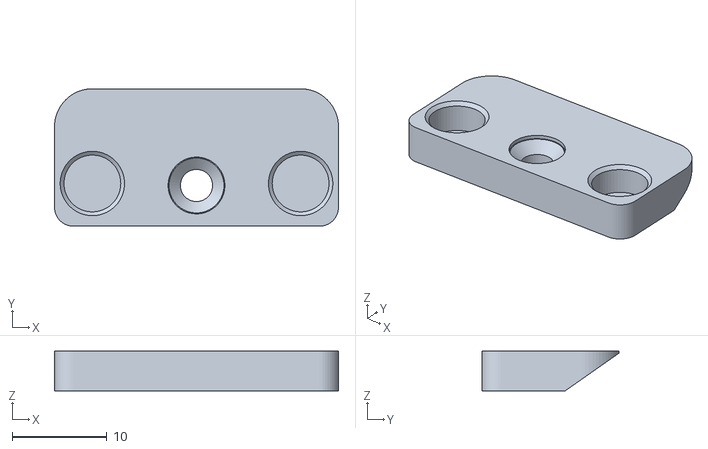
[picture p47: CAD file, 2020-11-01]
printer_mods/hernsl/bottom_panel_mag_clip/bottom_panel_magclip_skirt_x6.stl
30.0 x 14.5 x 4.20
