christophmuellerorg/VoronUsers/printer_mods/hijax_pl/corner_panel_clip/corner_panel_clip_3mm.stl

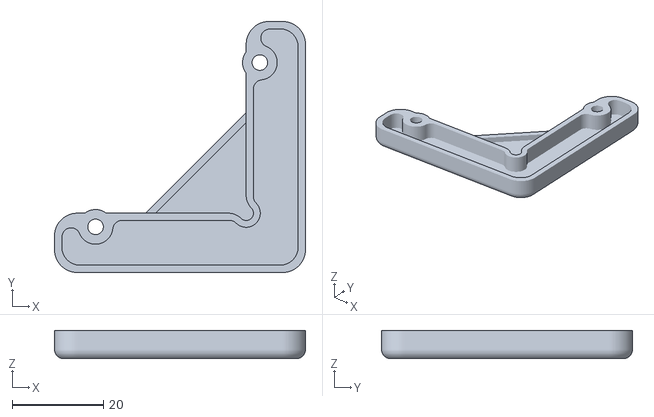
[picture p48: CAD file, 2020-11-01]
printer_mods/hijax_pl/corner_panel_clip/corner_panel_clip_3mm.stl
55.0 x 55.0 x 6.20
