christophmuellerorg/VoronUsers/printer_mods/hijax_pl/din_rail_mount/din_rail_mount_angle_panel_6mm.stl

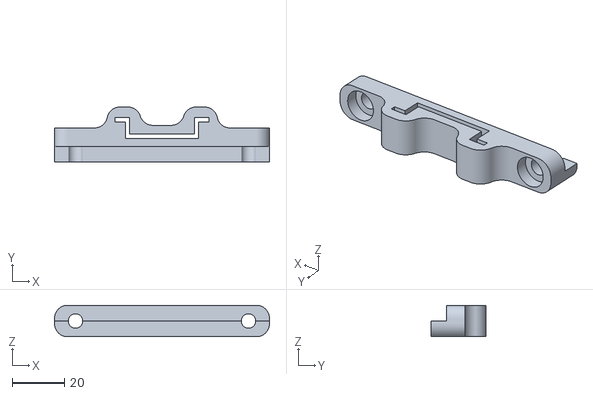
[picture p49: CAD file, 2020-11-01]
printer_mods/hijax_pl/din_rail_mount/din_rail_mount_angle_panel_6mm.stl
82.0 x 21.0 x 12.0
