christophmuellerorg/VoronUsers/printer_mods/hijax_pl/ender_compatible_controller_mount/ender_compatible_din_rotated.stl

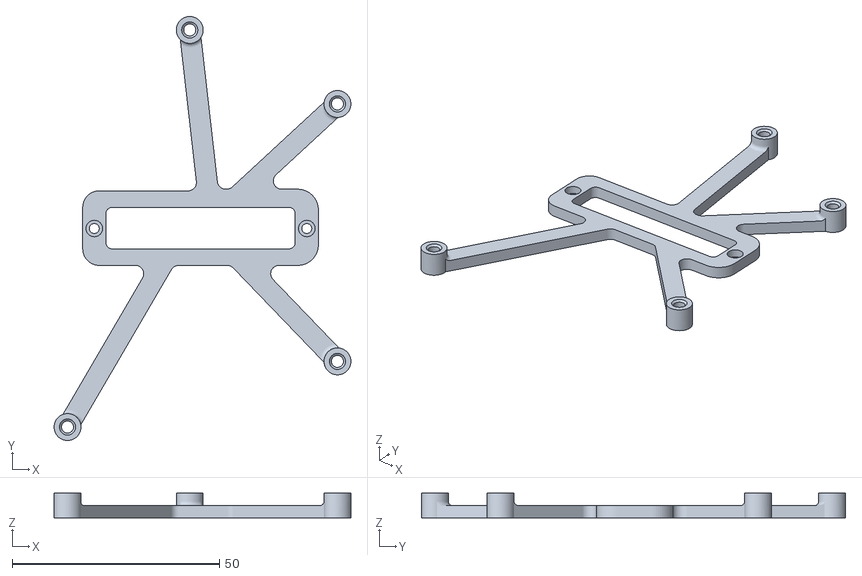
[picture p50: CAD file, 2020-11-01]
printer_mods/hijax_pl/ender_compatible_controller_mount/ender_compatible_din_rotated.stl
71.7 x 102.4 x 6.00
