christophmuellerorg/VoronUsers/printer_mods/Iakabos/C920_mount/C920_Mount_Slim.stl

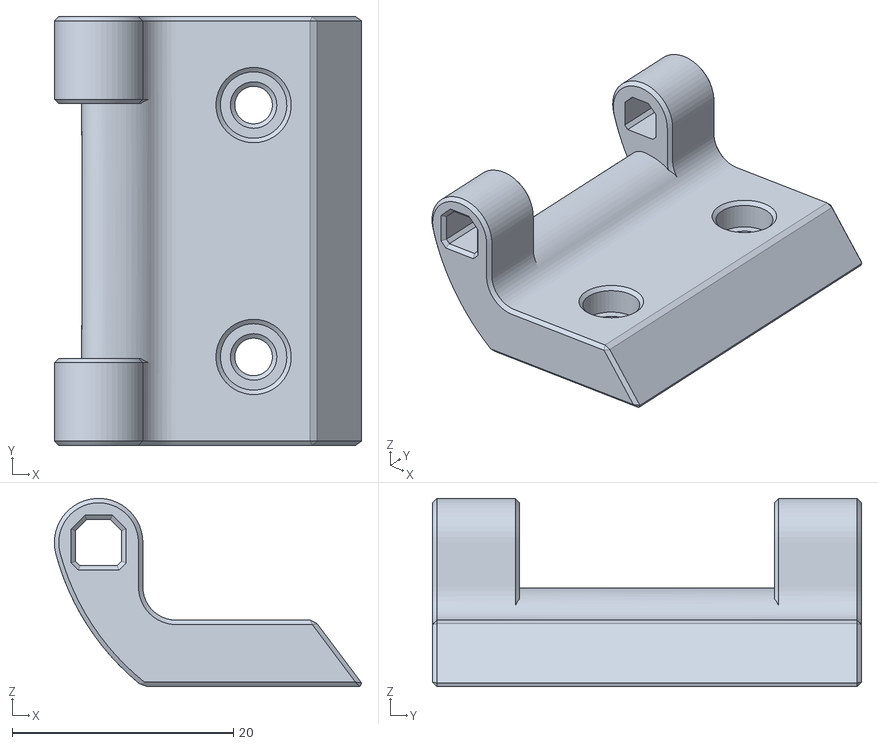
[picture p51: CAD file, 2020-11-01]
printer_mods/Iakabos/C920_mount/C920_Mount_Slim.stl
27.8 x 38.8 x 17.0
