christophmuellerorg/VoronUsers/printer_mods/Iakabos/V0_beltchain/Mod_Beltchain0_Anchor_Closed.stl

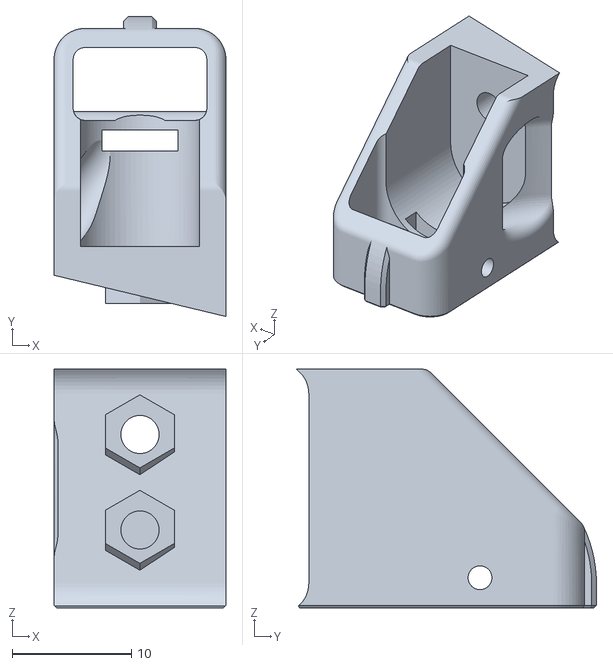
[picture p52: CAD file, 2020-11-01]
printer_mods/Iakabos/V0_beltchain/Mod_Beltchain0_Anchor_Closed.stl
14.4 x 25.1 x 20.0
