christophmuellerorg/VoronUsers/printer_mods/kirby/v0_sherpa_mini_direct_drive/CAD/v0_direct_drive.step

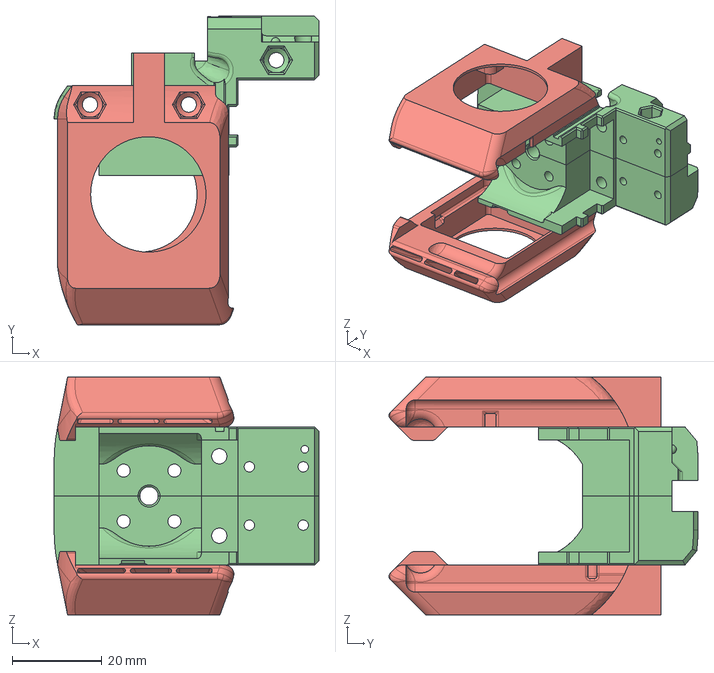
[picture p53: CAD file, 2020-11-01]
printer_mods/kirby/v0_sherpa_mini_direct_drive/CAD/v0_direct_drive.step
59.0 x 68.8 x 53.0 mm
