christophmuellerorg/VoronUsers/printer_mods/Kruppes/Closed_Bottom/Common_STLs/Skirt.stl

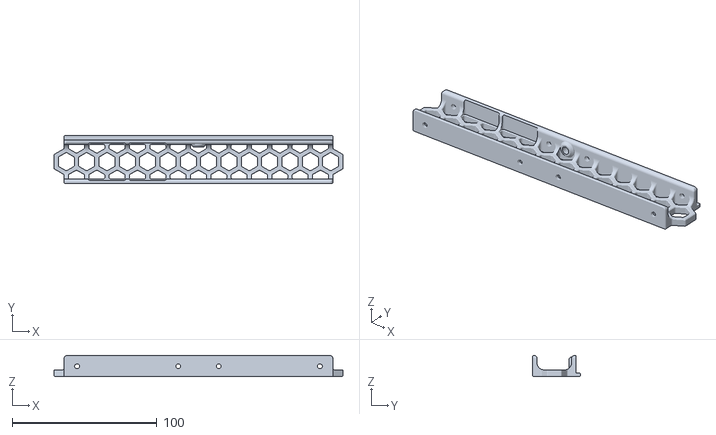
[picture p55: CAD file, 2020-11-01]
printer_mods/Kruppes/Closed_Bottom/Common_STLs/Skirt.stl
200.0 x 33.0 x 14.6
