christophmuellerorg/VoronUsers/printer_mods/Kruppes/Closed_Bottom/Fancy_Panel/[a]_Foot_Back_x2.stl

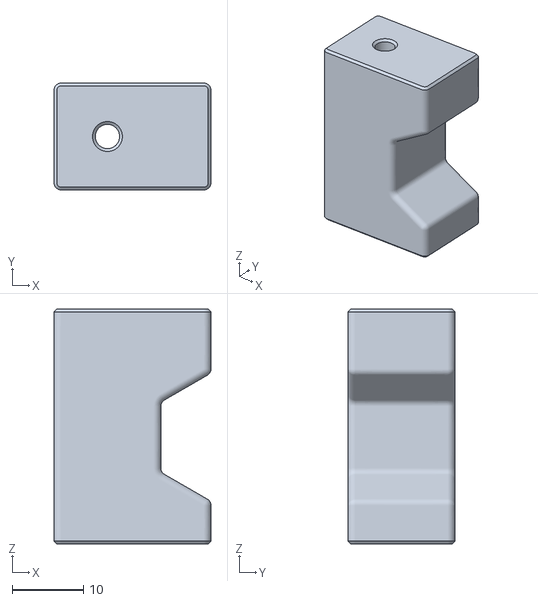
[picture p56: CAD file, 2020-11-01]
printer_mods/Kruppes/Closed_Bottom/Fancy_Panel/[a]_Foot_Back_x2.stl
22.0 x 15.0 x 33.0
