christophmuellerorg/VoronUsers/printer_mods/Kruppes/Closed_Bottom/Simple_Panel/Bottompanel_simple.dxf

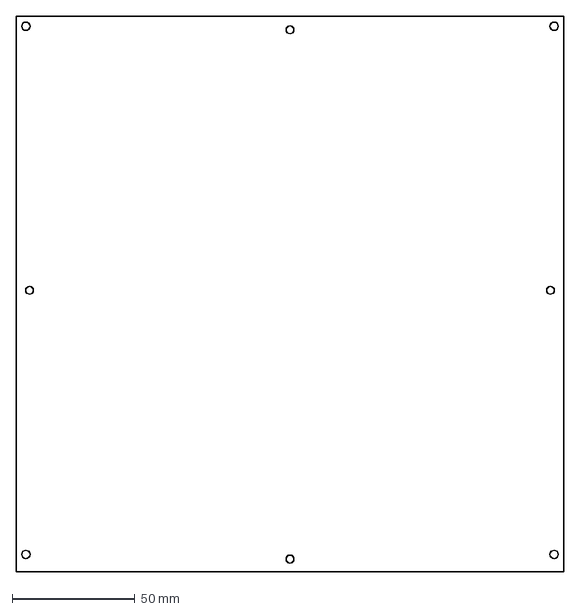
[picture p57: CAD file, 2020-11-01]
printer_mods/Kruppes/Closed_Bottom/Simple_Panel/Bottompanel_simple.dxf
223.0 x 226.0 mm
