christophmuellerorg/VoronUsers/printer_mods/littleferris/V0_Skirt_Inlet/step/v0_foot_skirt_right.step

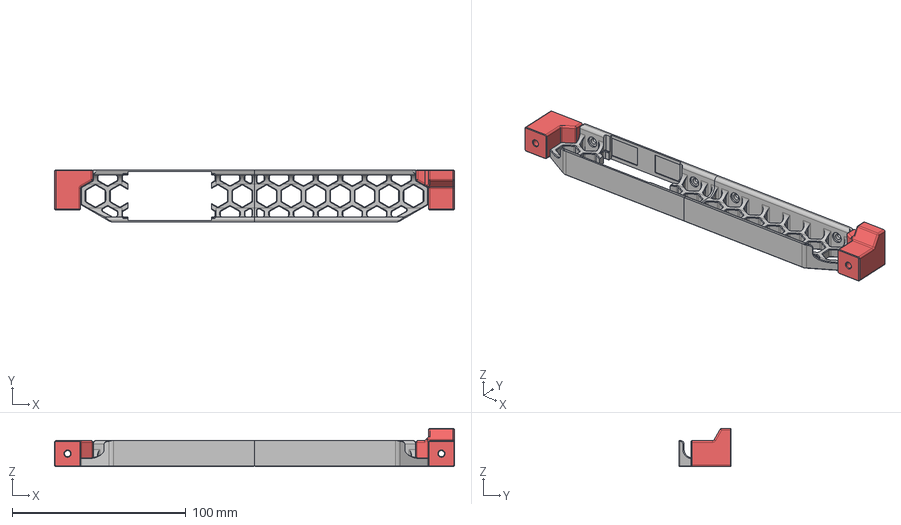
[picture p59: CAD file, 2020-11-01]
printer_mods/littleferris/V0_Skirt_Inlet/step/v0_foot_skirt_right.step
230.0 x 30.0 x 22.0 mm
