christophmuellerorg/VoronUsers/printer_mods/MarcPot/Skirt_Mods/250/hour_counter_skirt_b_250.stl

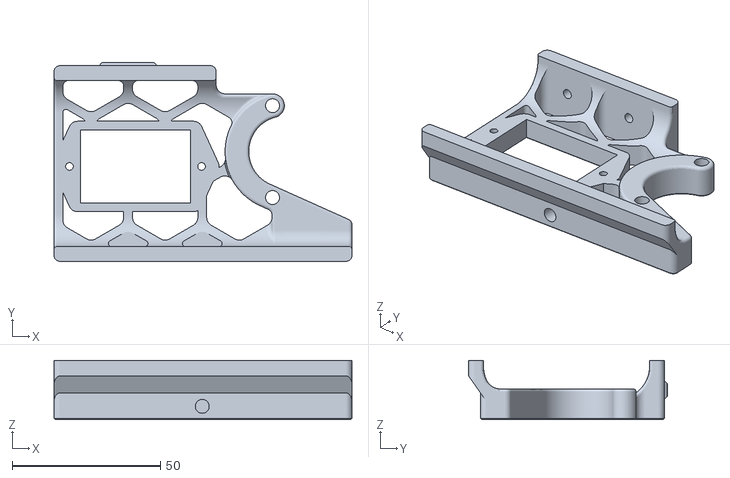
[picture p60: CAD file, 2020-11-01]
printer_mods/MarcPot/Skirt_Mods/250/hour_counter_skirt_b_250.stl
100.5 x 67.0 x 20.0
