christophmuellerorg/VoronUsers/printer_mods/MarcPot/Skirt_Mods/300/hour_counter_skirt_a_300.stl

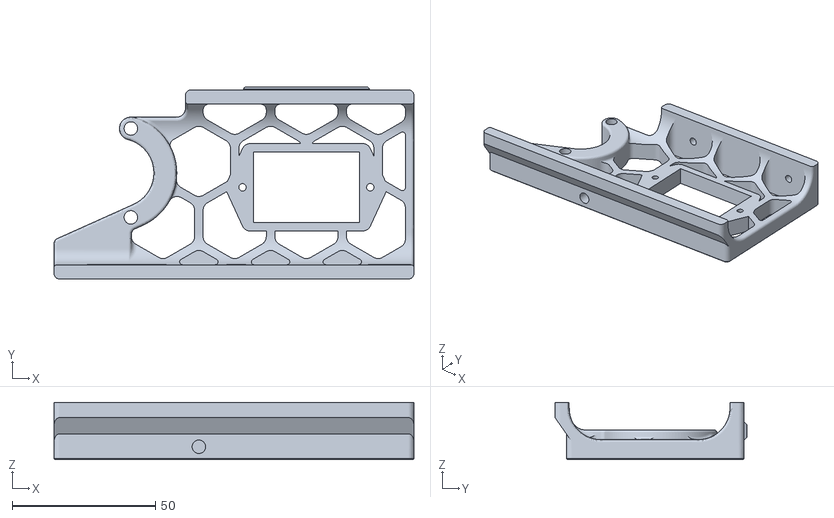
[picture p61: CAD file, 2020-11-01]
printer_mods/MarcPot/Skirt_Mods/300/hour_counter_skirt_a_300.stl
125.5 x 67.0 x 20.0
