christophmuellerorg/VoronUsers/printer_mods/MarcPot/UHP_PSU_Bracket_Clip/uhp_200_psu_bracket_hexnut.stl

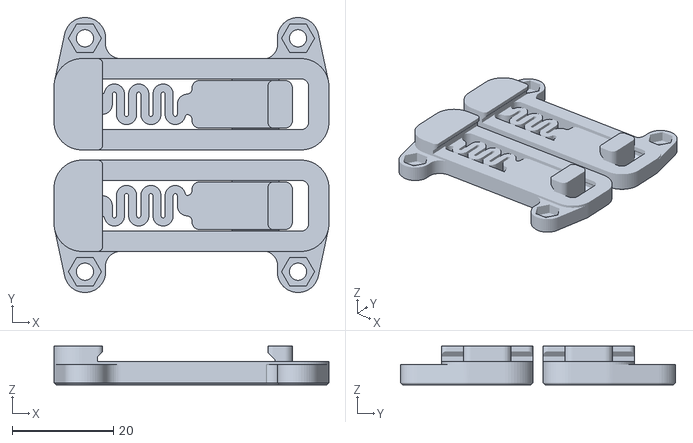
[picture p63: CAD file, 2020-11-01]
printer_mods/MarcPot/UHP_PSU_Bracket_Clip/uhp_200_psu_bracket_hexnut.stl
54.2 x 54.2 x 7.60
