christophmuellerorg/VoronUsers/printer_mods/mjoaris/10x11_Cable_Chain_Endcaps/CAD/10x11-chain-endcap2_support.STEP

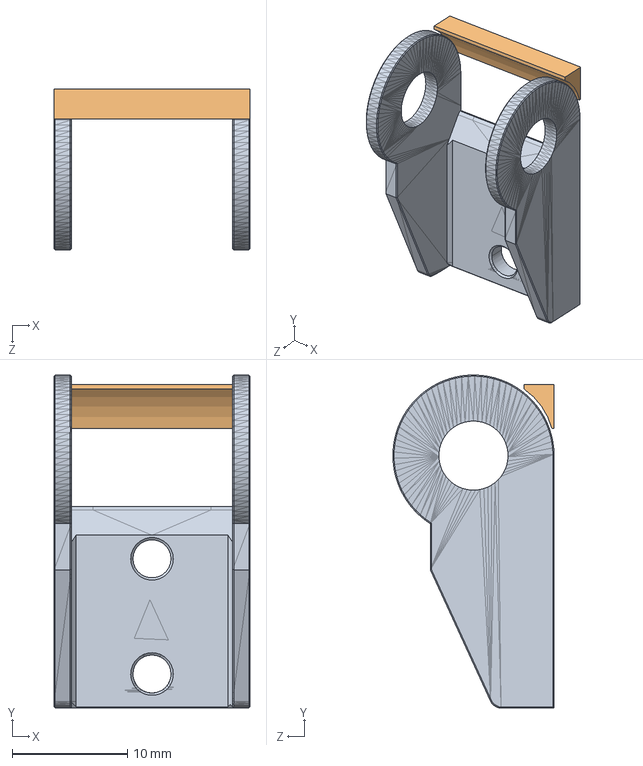
[picture p64: CAD file, 2020-11-01]
printer_mods/mjoaris/10x11_Cable_Chain_Endcaps/CAD/10x11-chain-endcap2_support.STEP
17.0 x 28.9 x 14.0 mm
