christophmuellerorg/VoronUsers/printer_mods/mjoaris/Mini12864_LCD_Mount_for_V2.4/rear_cover.STL

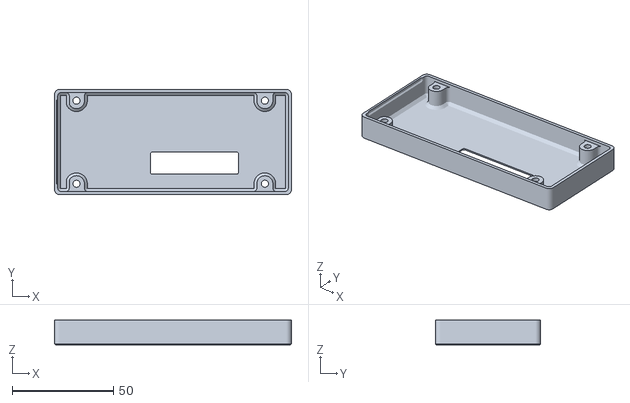
[picture p65: CAD file, 2020-11-01]
printer_mods/mjoaris/Mini12864_LCD_Mount_for_V2.4/rear_cover.STL
117.0 x 52.0 x 12.1
