christophmuellerorg/VoronUsers/printer_mods/mosher/m3_door_hinges/Door Mount right x2.stl

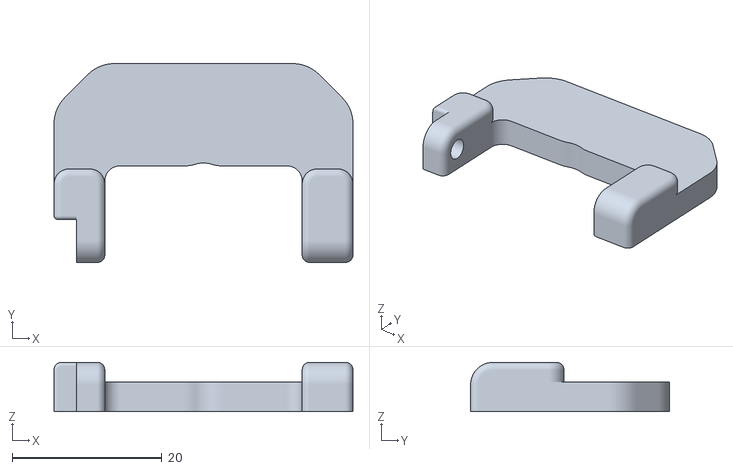
[picture p66: CAD file, 2020-11-01]
printer_mods/mosher/m3_door_hinges/Door Mount right x2.stl
40.0 x 26.6 x 6.60
