christophmuellerorg/VoronUsers/printer_mods/natewalck/v1.8_Jigs/lower_extrusion_alignment.stl

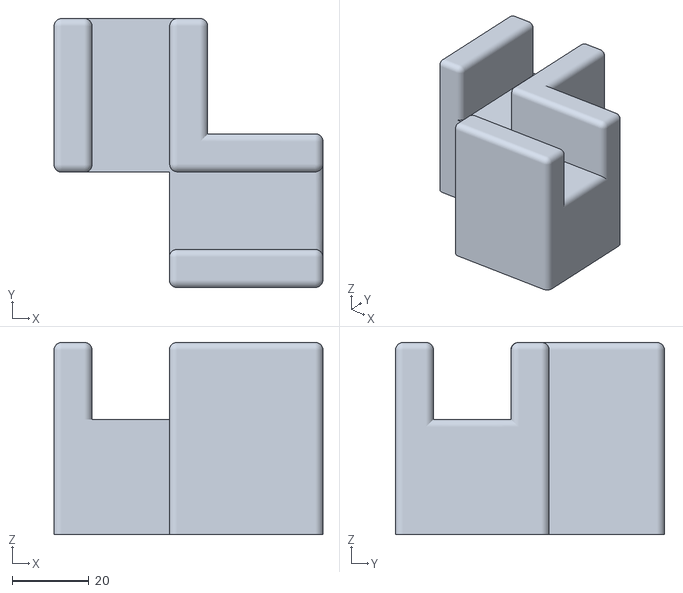
[picture p67: CAD file, 2020-11-01]
printer_mods/natewalck/v1.8_Jigs/lower_extrusion_alignment.stl
70.0 x 70.0 x 50.0
