christophmuellerorg/VoronUsers/printer_mods/Nomsplease/60mm_Shaft_Jig/60mm_Shaft_Jig.stl

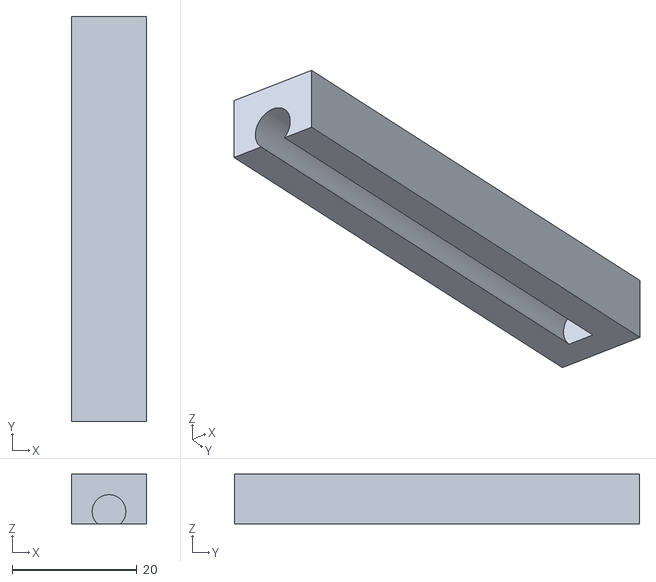
[picture p68: CAD file, 2020-11-01]
printer_mods/Nomsplease/60mm_Shaft_Jig/60mm_Shaft_Jig.stl
12.0 x 65.0 x 8.00
