christophmuellerorg/VoronUsers/printer_mods/Nomsplease/V0_Mods/duet_wifi_mount/duet_wifi_mount.step

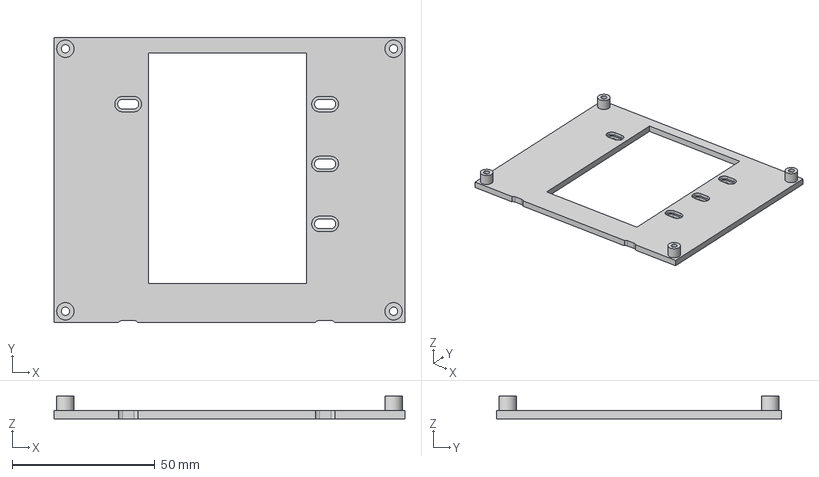
[picture p69: CAD file, 2020-11-01]
printer_mods/Nomsplease/V0_Mods/duet_wifi_mount/duet_wifi_mount.step
123.0 x 100.0 x 8.00 mm
