christophmuellerorg/VoronUsers/printer_mods/Nomsplease/V0_Mods/panel_mounts/rear_bottom_left_bracket_with_stop.step

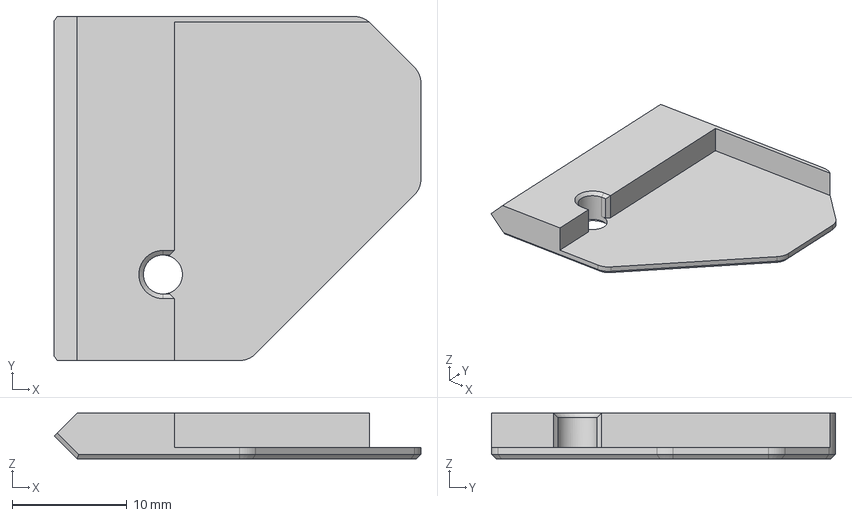
[picture p70: CAD file, 2020-11-01]
printer_mods/Nomsplease/V0_Mods/panel_mounts/rear_bottom_left_bracket_with_stop.step
32.0 x 30.0 x 4.00 mm
