christophmuellerorg/VoronUsers/printer_mods/Nomsplease/V0_Mods/pi_zero_camera_mount/pi_zero_mount.step

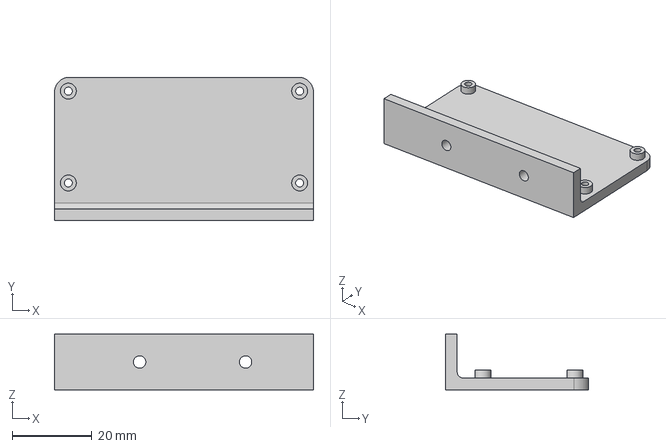
[picture p71: CAD file, 2020-11-01]
printer_mods/Nomsplease/V0_Mods/pi_zero_camera_mount/pi_zero_mount.step
65.0 x 36.0 x 14.0 mm
