christophmuellerorg/VoronUsers/printer_mods/Nomsplease/V0_Mods/pocket_watch_rear_relocation/pocket_watch_rear_mount.step

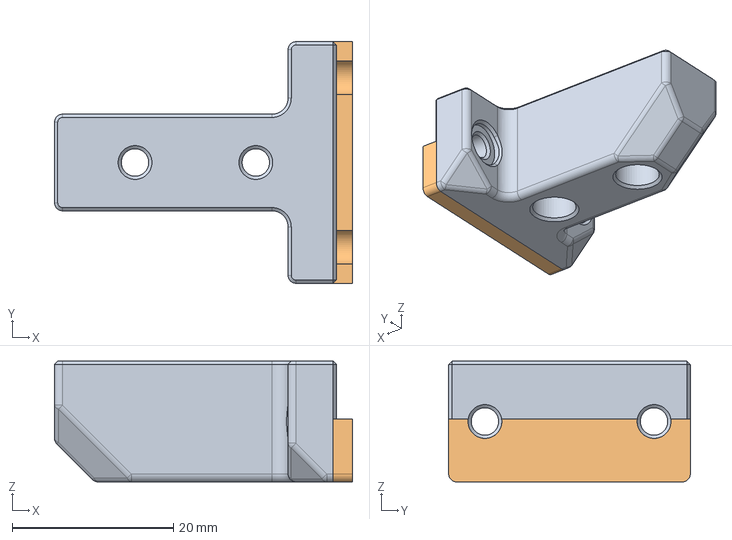
[picture p72: CAD file, 2020-11-01]
printer_mods/Nomsplease/V0_Mods/pocket_watch_rear_relocation/pocket_watch_rear_mount.step
37.0 x 30.0 x 15.0 mm
