christophmuellerorg/VoronUsers/printer_mods/randell/Door_Hinges/hinge_pivot_x4.stl

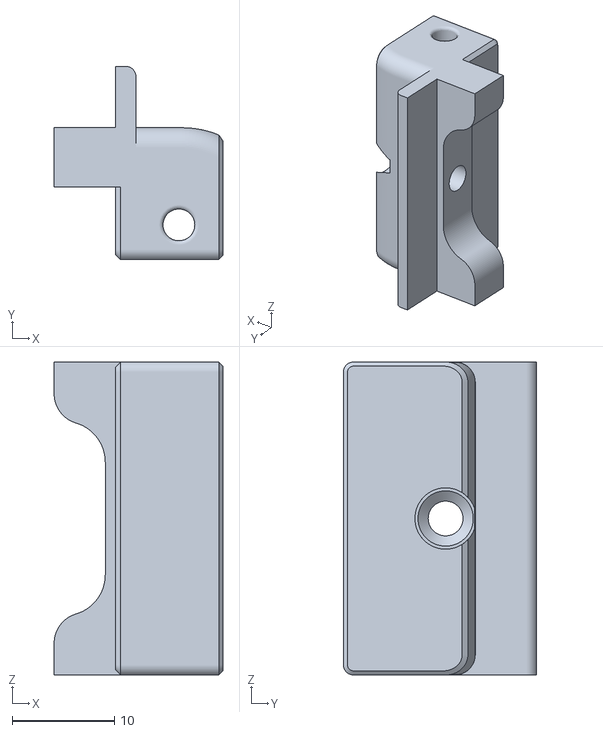
[picture p73: CAD file, 2020-11-01]
printer_mods/randell/Door_Hinges/hinge_pivot_x4.stl
16.5 x 18.9 x 30.6
