christophmuellerorg/VoronUsers/printer_mods/randell/Microswitch_Endstop/Microswitch_Edge_Pod.step

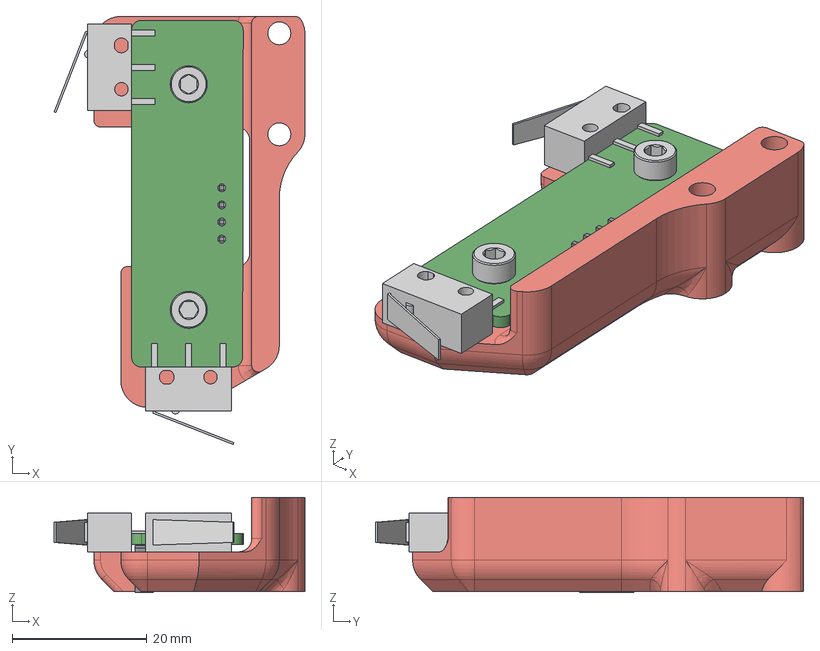
[picture p74: CAD file, 2020-11-01]
printer_mods/randell/Microswitch_Endstop/Microswitch_Edge_Pod.step
37.3 x 63.6 x 14.2 mm
M3x8 SHCS (1) (1) (1) x 2
