christophmuellerorg/VoronUsers/printer_mods/raymondh/LargeSpoolHolders/KVP5lb_holder.step

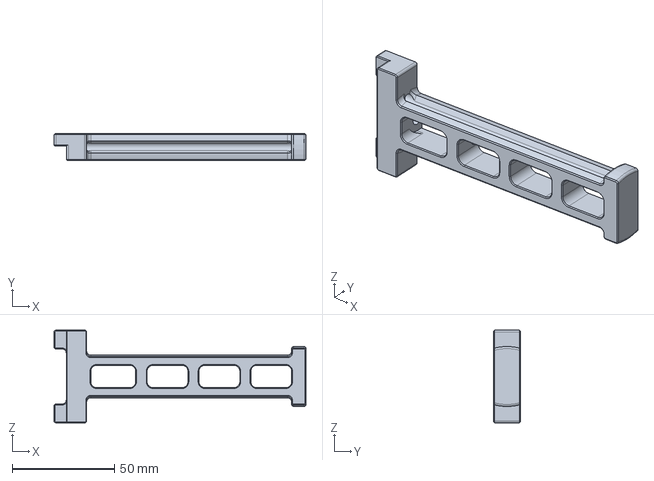
[picture p75: CAD file, 2020-11-01]
printer_mods/raymondh/LargeSpoolHolders/KVP5lb_holder.step
123.4 x 13.0 x 45.4 mm
