christophmuellerorg/VoronUsers/printer_mods/Rhastlyn/60mmFanCover/STL/60mm_fan_grill_rev1.stl

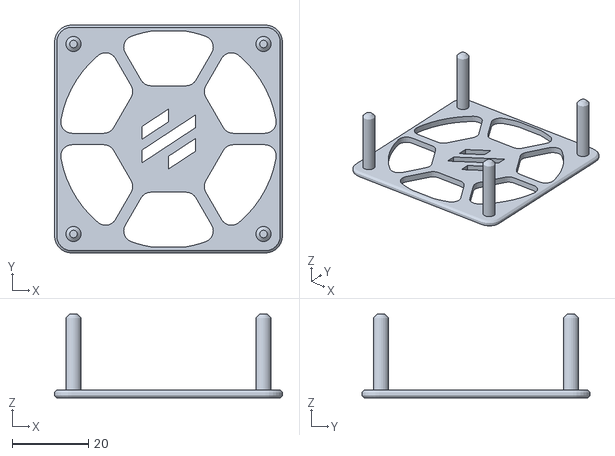
[picture p76: CAD file, 2020-11-01]
printer_mods/Rhastlyn/60mmFanCover/STL/60mm_fan_grill_rev1.stl
60.0 x 60.0 x 22.0
