christophmuellerorg/VoronUsers/printer_mods/Rhastlyn/WansviewCameraMount/STL/WansviewCameraMount.stl

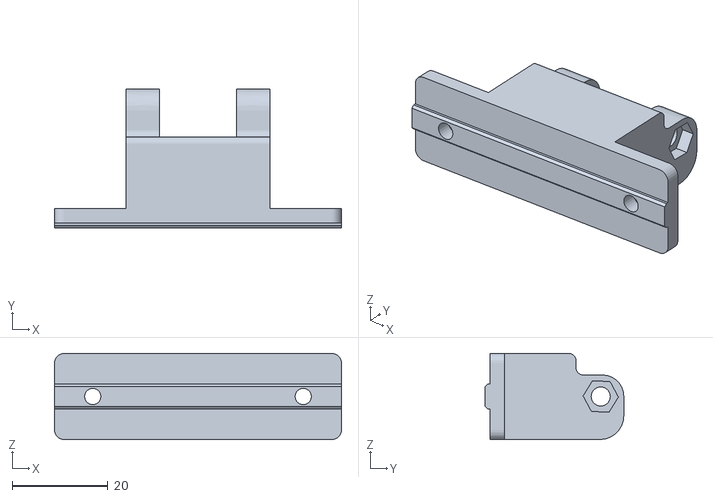
[picture p77: CAD file, 2020-11-01]
printer_mods/Rhastlyn/WansviewCameraMount/STL/WansviewCameraMount.stl
60.0 x 29.0 x 18.0
