christophmuellerorg/VoronUsers/printer_mods/Slidr/PanzerChain2.4/stl/xy_link.stl

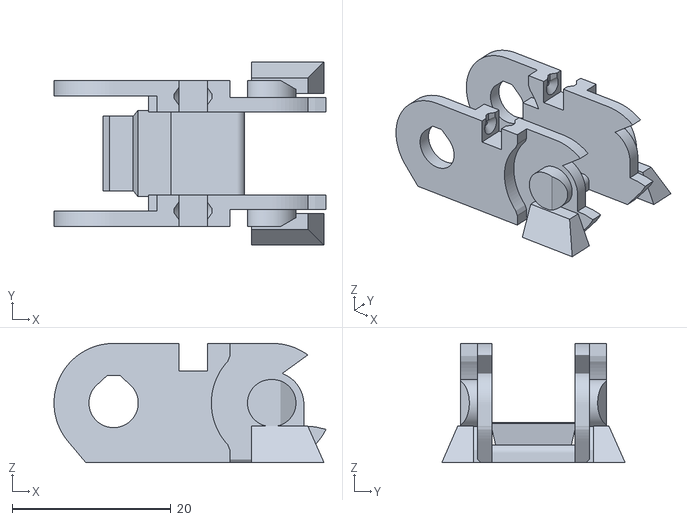
[picture p78: CAD file, 2020-11-01]
printer_mods/Slidr/PanzerChain2.4/stl/xy_link.stl
34.2 x 23.1 x 15.0
