christophmuellerorg/VoronUsers/printer_mods/Spaghetti-Bolognese/LCD_case_mod/Mini12864_Case_Front.stl

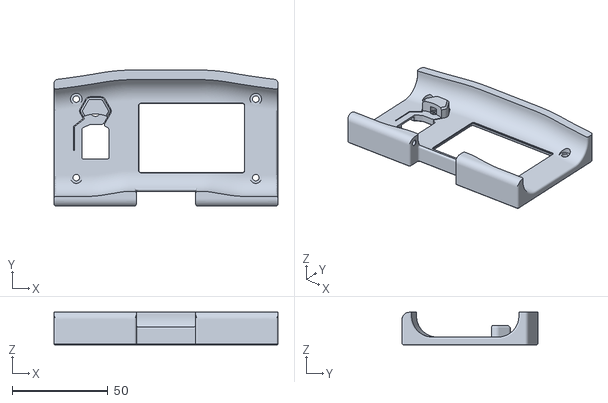
[picture p79: CAD file, 2020-11-01]
printer_mods/Spaghetti-Bolognese/LCD_case_mod/Mini12864_Case_Front.stl
117.0 x 71.0 x 17.0
