christophmuellerorg/VoronUsers/printer_mods/Spaghetti-Bolognese/Z_drive_motor_mount/Z_Motor_Mount_B.stl

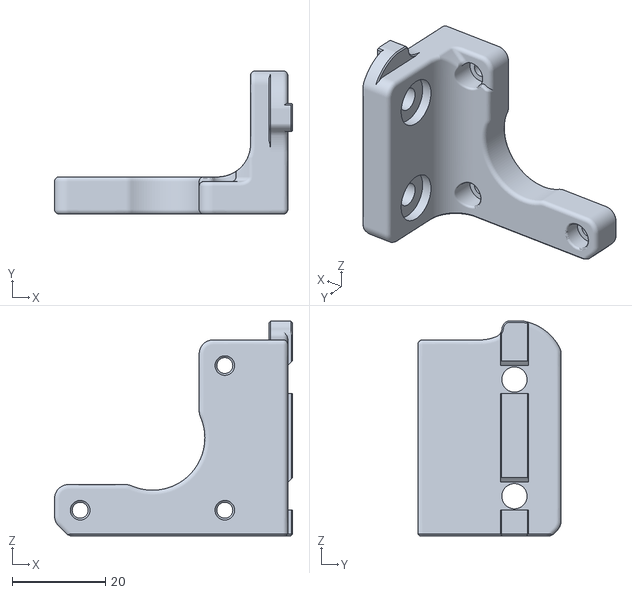
[picture p80: CAD file, 2020-11-01]
printer_mods/Spaghetti-Bolognese/Z_drive_motor_mount/Z_Motor_Mount_B.stl
51.0 x 30.7 x 46.0
