christophmuellerorg/VoronUsers/printer_mods/StvPtrsn/320mm_Build/CAD/side_skirt_ab_320_x2.step

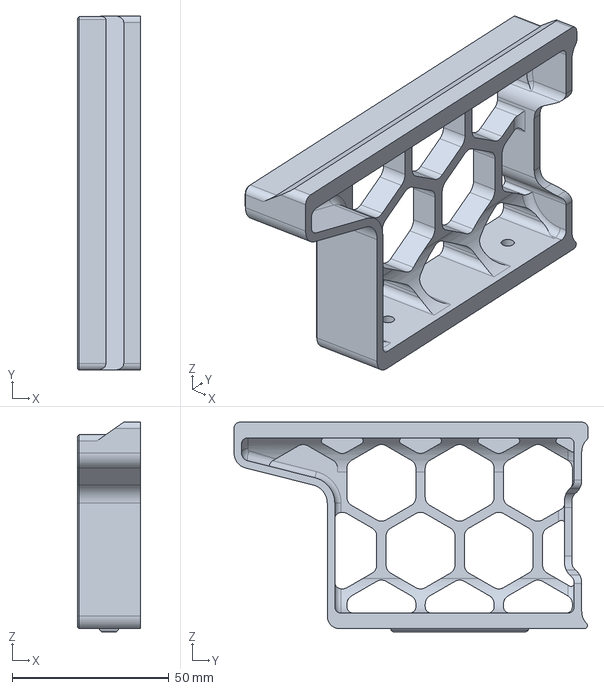
[picture p81: CAD file, 2020-11-01]
printer_mods/StvPtrsn/320mm_Build/CAD/side_skirt_ab_320_x2.step
20.0 x 113.1 x 67.0 mm
