christophmuellerorg/VoronUsers/printer_mods/StvPtrsn/Keystone_Jack_Filtered_Mains_Panel/STL/rear_skirt_fmks_b_320.stl

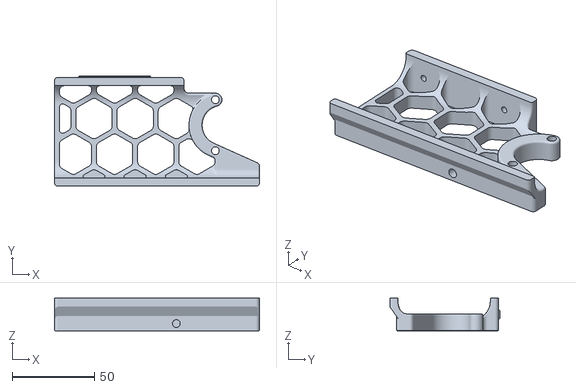
[picture p82: CAD file, 2020-11-01]
printer_mods/StvPtrsn/Keystone_Jack_Filtered_Mains_Panel/STL/rear_skirt_fmks_b_320.stl
124.5 x 67.0 x 20.0
