christophmuellerorg/VoronUsers/printer_mods/StvPtrsn/Side_Fan_Support_No_Tape/CAD/[a]_60mm_fan_grill_a.step

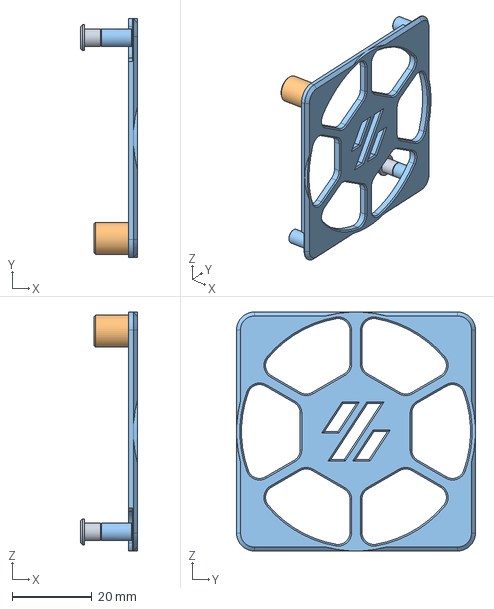
[picture p83: CAD file, 2020-11-01]
printer_mods/StvPtrsn/Side_Fan_Support_No_Tape/CAD/[a]_60mm_fan_grill_a.step
14.2 x 60.0 x 60.0 mm
