christophmuellerorg/VoronUsers/printer_mods/StvPtrsn/Side_Fan_Support_No_Tape/STL/fan_grill_retainer_x6.stl

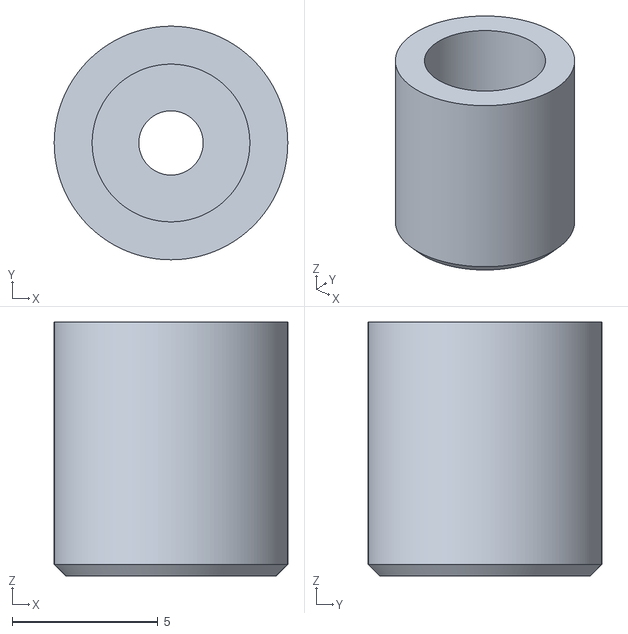
[picture p84: CAD file, 2020-11-01]
printer_mods/StvPtrsn/Side_Fan_Support_No_Tape/STL/fan_grill_retainer_x6.stl
8.00 x 8.00 x 8.70
