christophmuellerorg/VoronUsers/printer_mods/tameike/DIN_Rail_2020_holder/DIN rail 2020 holder.stl

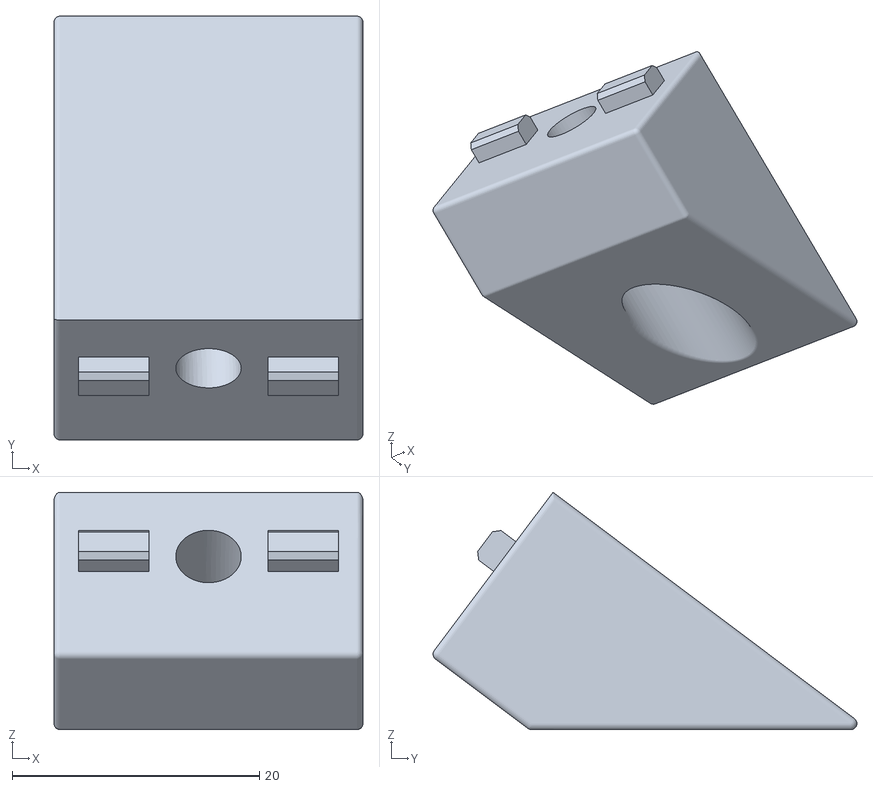
[picture p85: CAD file, 2020-11-01]
printer_mods/tameike/DIN_Rail_2020_holder/DIN rail 2020 holder.stl
25.0 x 34.3 x 19.2
