christophmuellerorg/VoronUsers/printer_mods/tameike/DIN_Rail_SKR_1.3_90deg/SKR 1.3 Bracket 90deg.stl

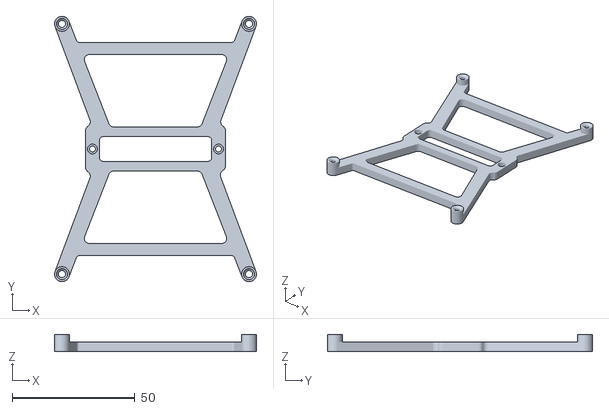
[picture p86: CAD file, 2020-11-01]
printer_mods/tameike/DIN_Rail_SKR_1.3_90deg/SKR 1.3 Bracket 90deg.stl
82.2 x 107.9 x 7.00
