christophmuellerorg/VoronUsers/printer_mods/tameike/V0_TR_Mounting_Frame/V0_TacoRaven_Mounting_Frame.stl

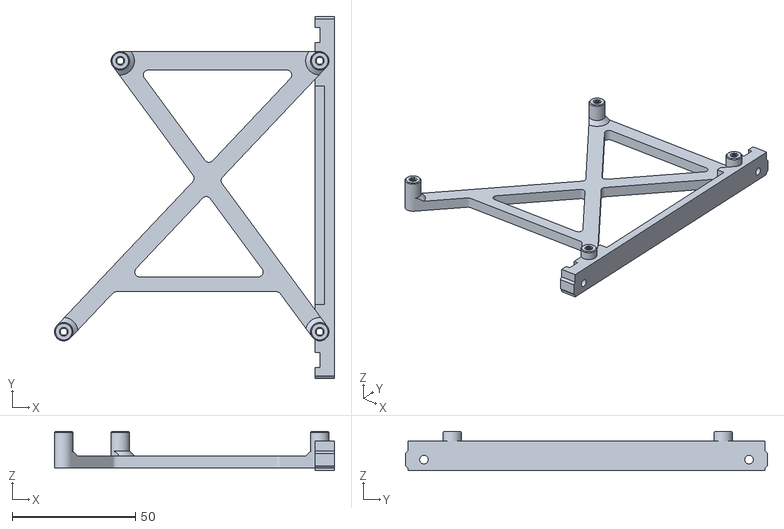
[picture p87: CAD file, 2020-11-01]
printer_mods/tameike/V0_TR_Mounting_Frame/V0_TacoRaven_Mounting_Frame.stl
113.7 x 147.0 x 16.0
