christophmuellerorg/VoronUsers/printer_mods/tayto-chip/skirt_switch_mod/350/side_skirt_b_350.stl

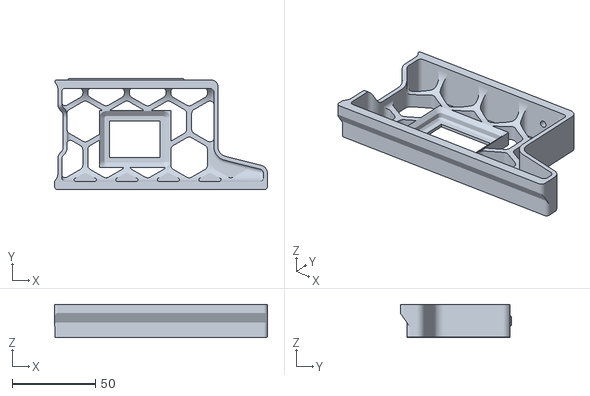
[picture p88: CAD file, 2020-11-19]
printer_mods/tayto-chip/skirt_switch_mod/350/side_skirt_b_350.stl
128.1 x 67.0 x 20.0
