christophmuellerorg/VoronUsers/printer_mods/warriorofwire/slenderfan/blower_case.stl

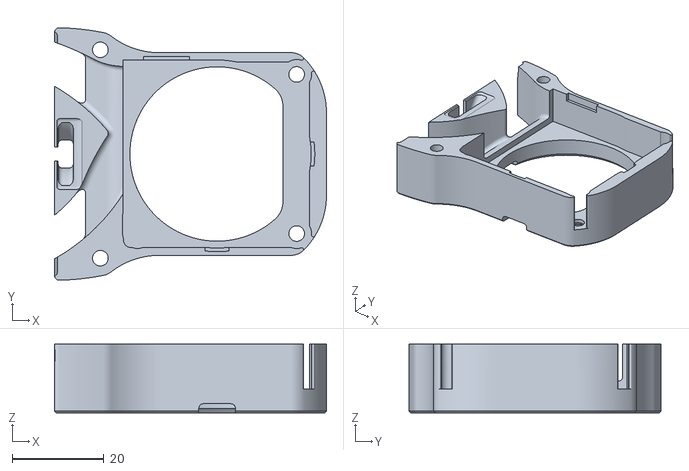
[picture p89: CAD file, 2020-11-01]
printer_mods/warriorofwire/slenderfan/blower_case.stl
59.3 x 55.0 x 15.0
