christophmuellerorg/VoronUsers/printer_mods/Weaslus/Electronics-Bay-Seperator/Electronics_Bay_and_Chamber_Seperator.stl

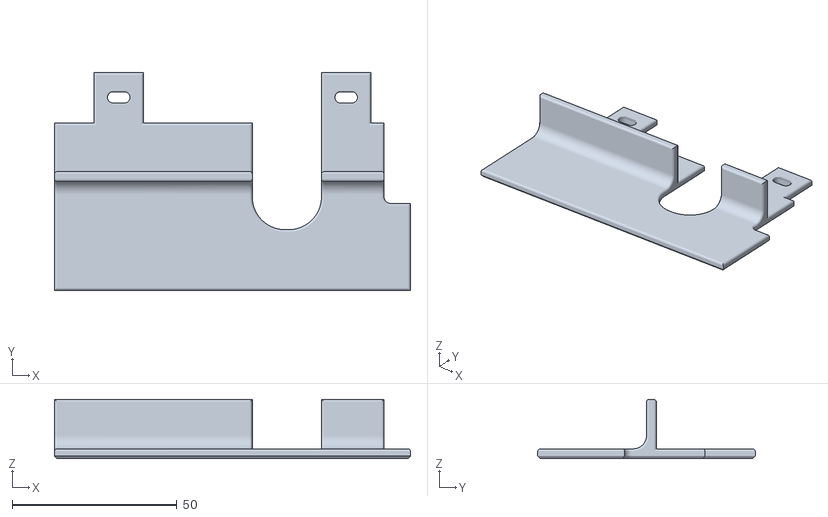
[picture p90: CAD file, 2020-11-01]
printer_mods/Weaslus/Electronics-Bay-Seperator/Electronics_Bay_and_Chamber_Seperator.stl
108.0 x 66.0 x 18.0
