christophmuellerorg/VoronUsers/printer_mods/xbst_/ADXL345_V0_Mount/B.stl

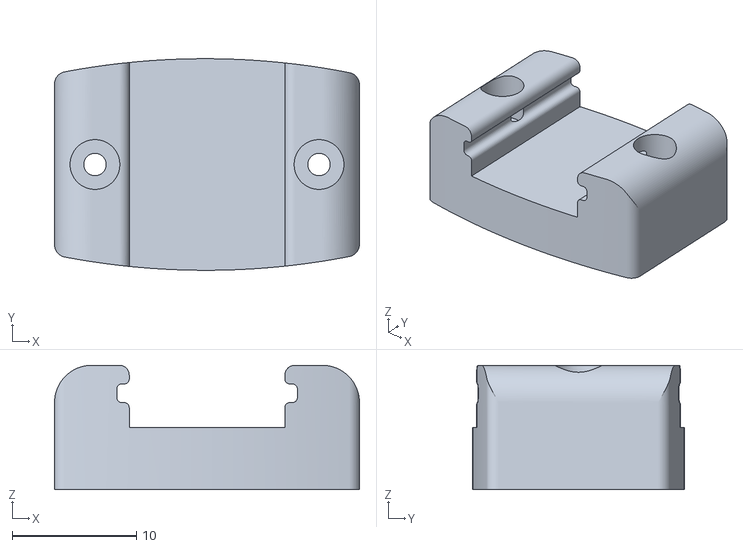
[picture p91: CAD file, 2020-11-01]
printer_mods/xbst_/ADXL345_V0_Mount/B.stl
24.5 x 17.0 x 10.0
