christophmuellerorg/VoronUsers/printer_mods/xbst_/Bed_Hinge/CAD/350_Deck_Panel.dxf

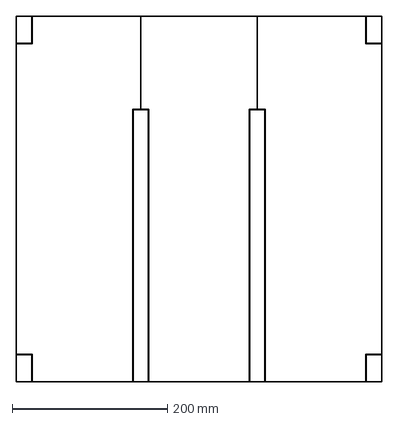
[picture p92: CAD file, 2020-11-01]
printer_mods/xbst_/Bed_Hinge/CAD/350_Deck_Panel.dxf
470.4 x 470.4 mm
