christophmuellerorg/VoronUsers/printer_mods/xbst_/Bed_Hinge/STLs/Front.stl

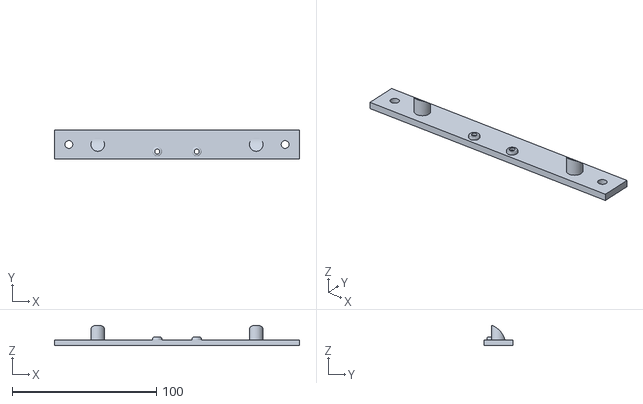
[picture p93: CAD file, 2020-11-01]
printer_mods/xbst_/Bed_Hinge/STLs/Front.stl
170.0 x 20.0 x 14.1
