christophmuellerorg/VoronUsers/printer_mods/xbst_/Duct_Mount/Body2.stl

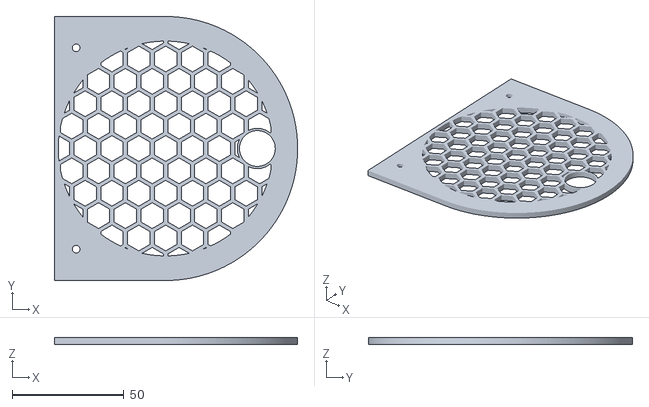
[picture p94: CAD file, 2020-11-01]
printer_mods/xbst_/Duct_Mount/Body2.stl
108.8 x 118.0 x 3.00
