christophmuellerorg/VoronUsers/printer_mods/xbst_/DuetZero/DuetZero.stl

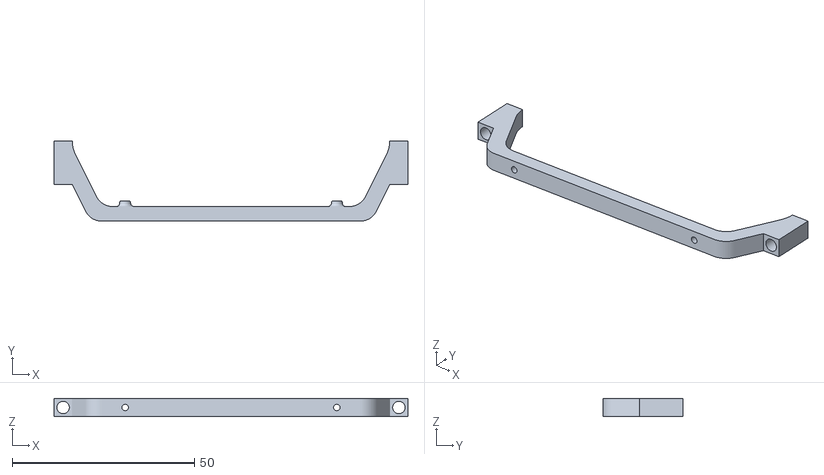
[picture p95: CAD file, 2020-11-01]
printer_mods/xbst_/DuetZero/DuetZero.stl
97.0 x 22.0 x 5.00
