christophmuellerorg/VoronUsers/printer_mods/xbst_/Easy_Access_Rear_Panels_v0/Top.stl

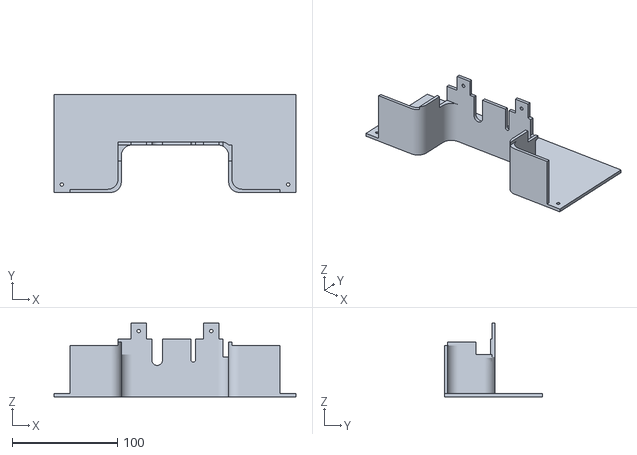
[picture p96: CAD file, 2020-11-01]
printer_mods/xbst_/Easy_Access_Rear_Panels_v0/Top.stl
230.0 x 93.0 x 70.0
