christophmuellerorg/VoronUsers/printer_mods/xbst_/Flat_Skirts/Filtered_In.stl

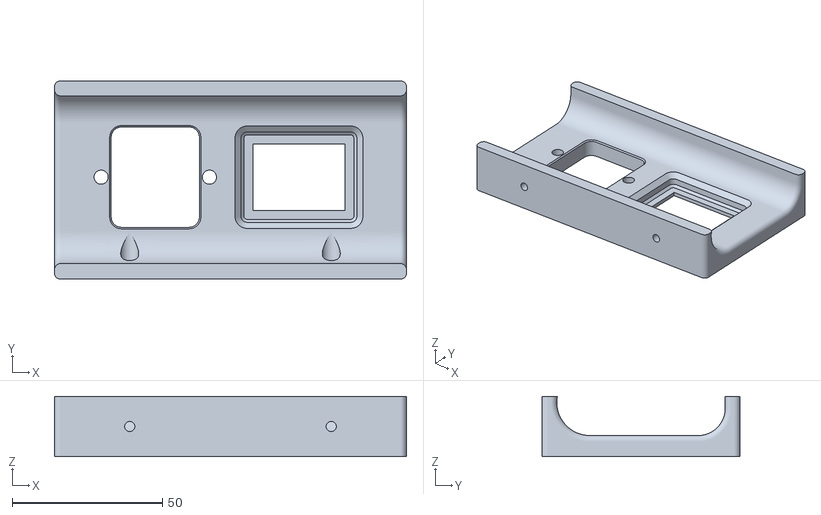
[picture p97: CAD file, 2020-11-01]
printer_mods/xbst_/Flat_Skirts/Filtered_In.stl
117.0 x 65.9 x 20.0
