christophmuellerorg/VoronUsers/printer_mods/xbst_/Hat_LED_Mount/Hat_LED.stl

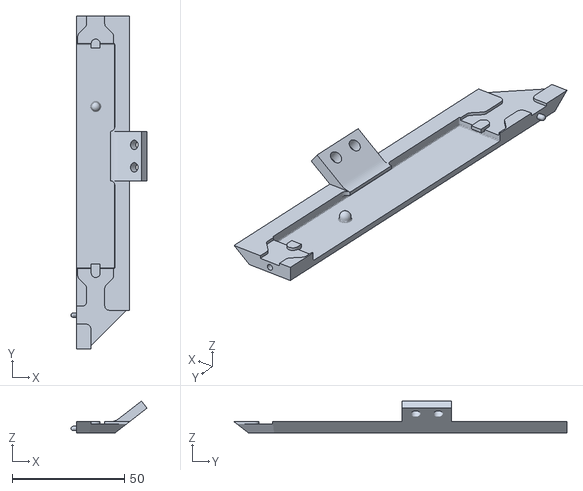
[picture p98: CAD file, 2020-11-01]
printer_mods/xbst_/Hat_LED_Mount/Hat_LED.stl
33.8 x 148.0 x 14.2
