christophmuellerorg/VoronUsers/printer_mods/xbst_/HOYMK_SSR_Mount/Alternative_A.stl

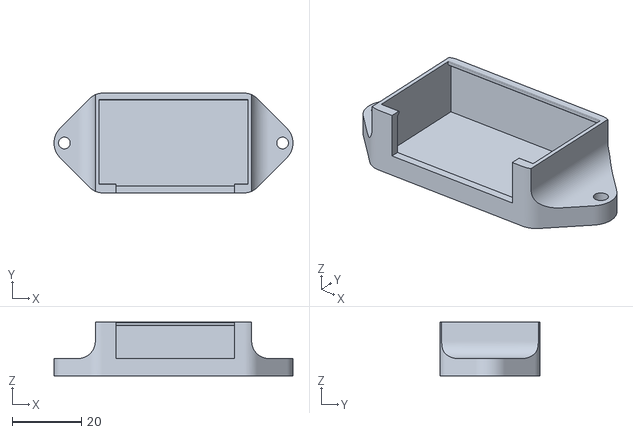
[picture p99: CAD file, 2020-11-01]
printer_mods/xbst_/HOYMK_SSR_Mount/Alternative_A.stl
69.2 x 28.9 x 15.5
