christophmuellerorg/VoronUsers/printer_mods/xbst_/Omron_DIN_Mount/Relay.stl

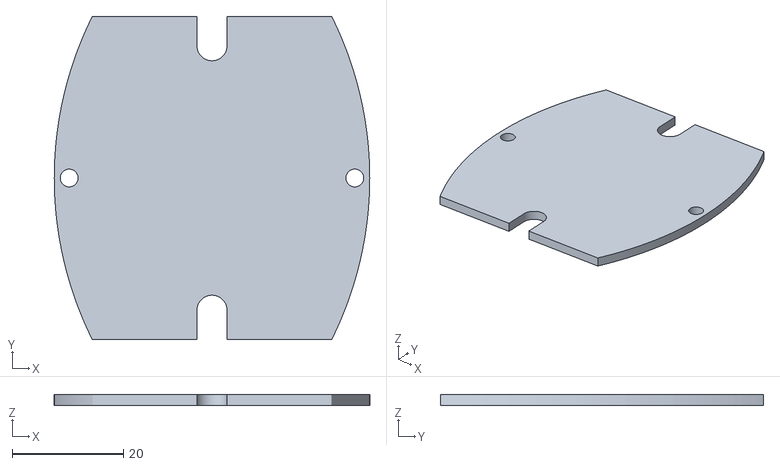
[picture p100: CAD file, 2020-11-01]
printer_mods/xbst_/Omron_DIN_Mount/Relay.stl
56.7 x 58.0 x 2.00
