christophmuellerorg/VoronUsers/printer_mods/xbst_/Relay_DIN_Mount/Relay.stl

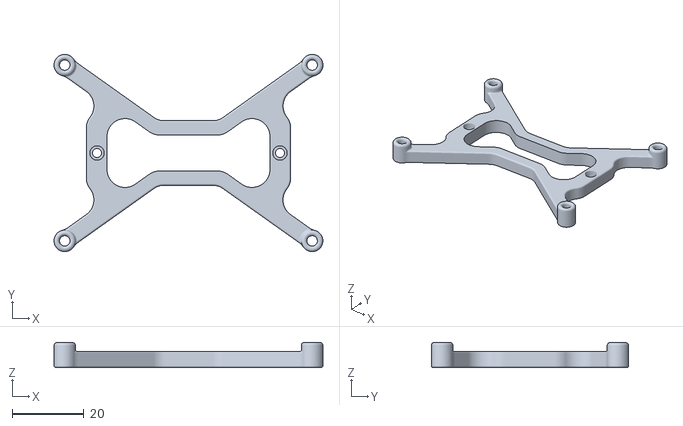
[picture p101: CAD file, 2020-11-01]
printer_mods/xbst_/Relay_DIN_Mount/Relay.stl
75.0 x 55.0 x 7.00
