christophmuellerorg/VoronUsers/printer_mods/xbst_/V2.4_Fanless_Middle_Skirt/MS.stl

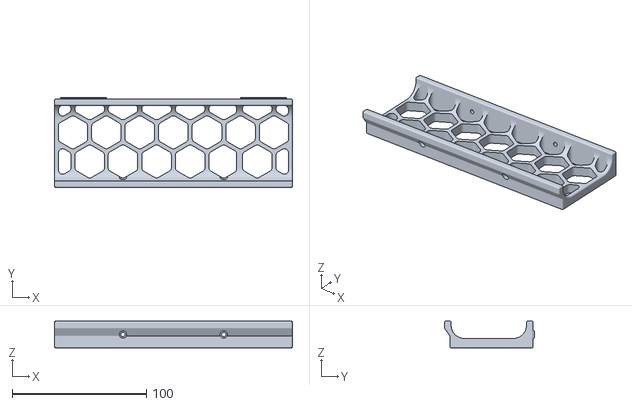
[picture p102: CAD file, 2020-11-01]
printer_mods/xbst_/V2.4_Fanless_Middle_Skirt/MS.stl
177.0 x 67.0 x 20.0
