christophmuellerorg/VoronUsers/printer_mods/xbst_/V2.4_Skirt_Buttons/300/300.stl

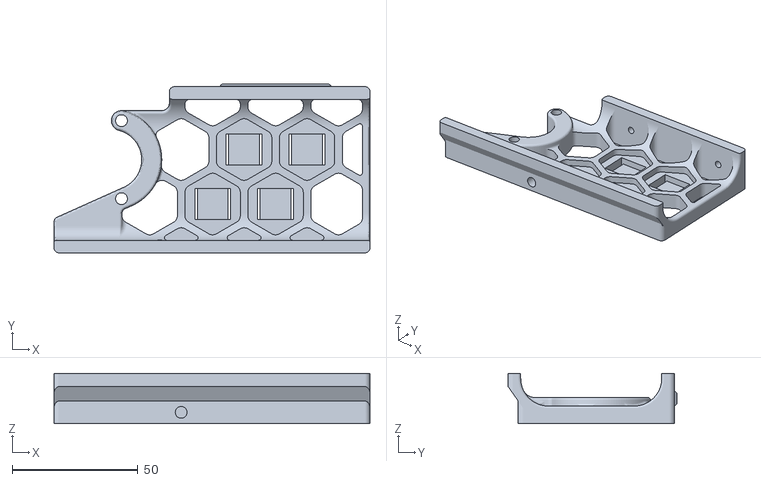
[picture p103: CAD file, 2020-11-01]
printer_mods/xbst_/V2.4_Skirt_Buttons/300/300.stl
125.5 x 67.0 x 20.0
