christophmuellerorg/VoronUsers/printer_mods/xbst_/V2.4_Skirt_Buttons/350/350.stl

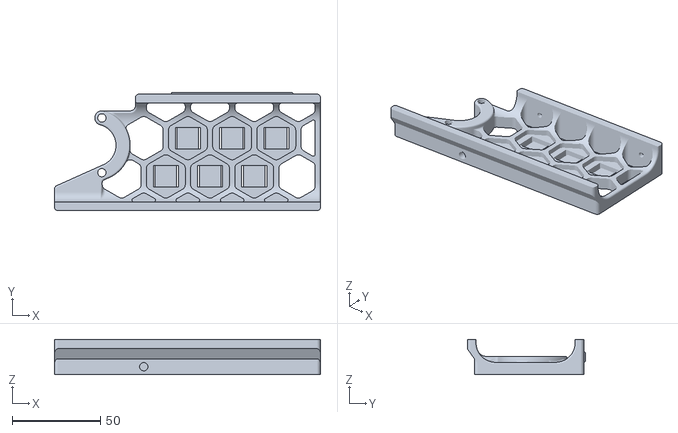
[picture p104: CAD file, 2020-11-01]
printer_mods/xbst_/V2.4_Skirt_Buttons/350/350.stl
150.5 x 67.0 x 20.0
