christophmuellerorg/VoronUsers/printer_mods/xbst_/V2.4_Skirt_Buttons/Buttons/Power.stl

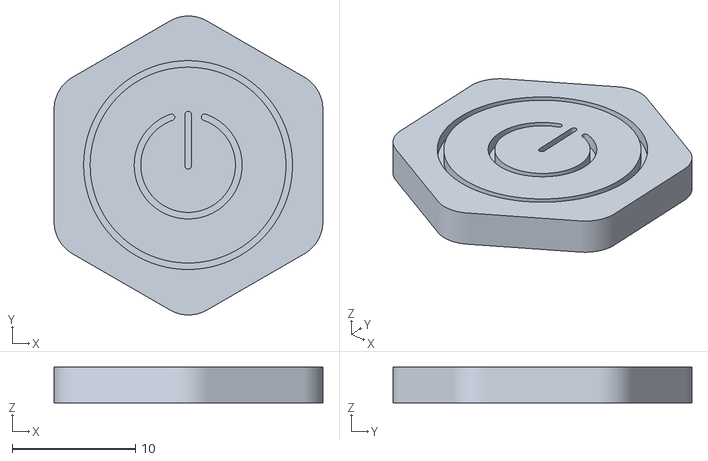
[picture p105: CAD file, 2020-11-01]
printer_mods/xbst_/V2.4_Skirt_Buttons/Buttons/Power.stl
21.8 x 24.2 x 2.90
