christophmuellerorg/VoronUsers/printer_mods/xbst_/ZipClip_v0/ZipClip.stl

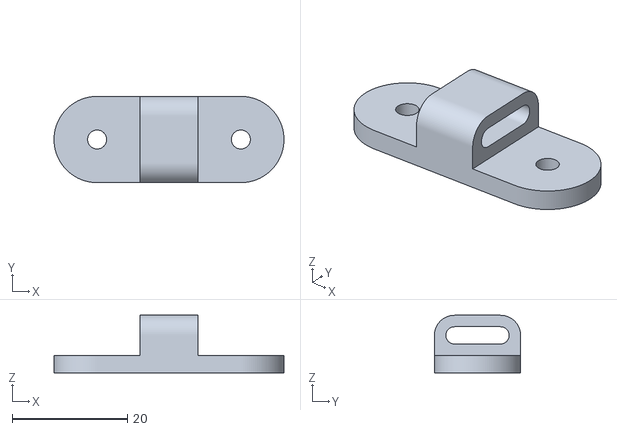
[picture p106: CAD file, 2020-11-01]
printer_mods/xbst_/ZipClip_v0/ZipClip.stl
40.0 x 15.0 x 10.0
