christophmuellerorg/VoronUsers/slicer_configurations/Simplify3D/hijax_pl/beds/voron2_250bed.stl

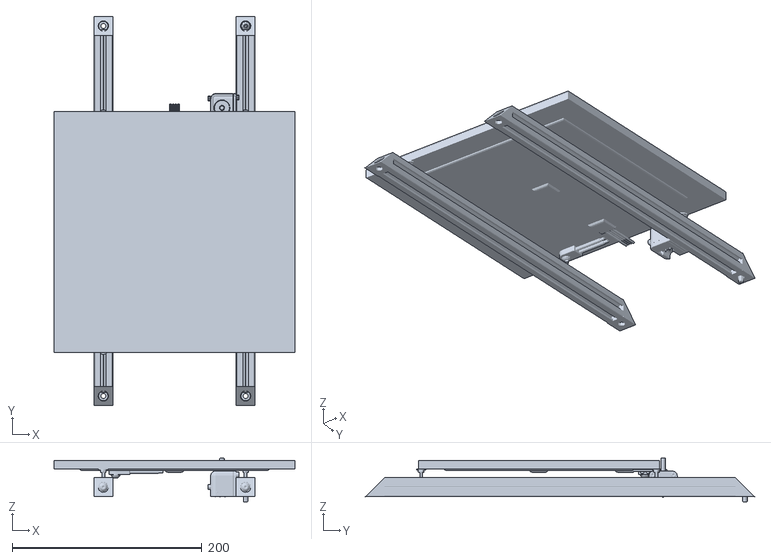
[picture p107: CAD file, 2020-11-01]
slicer_configurations/Simplify3D/hijax_pl/beds/voron2_250bed.stl
254.0 x 410.0 x 46.0
