christophmuellerorg/VoronUsers/printer_mods/aeresov/MeanWell_UHP_DIN_mount/STLs/UHP 500 series.stl

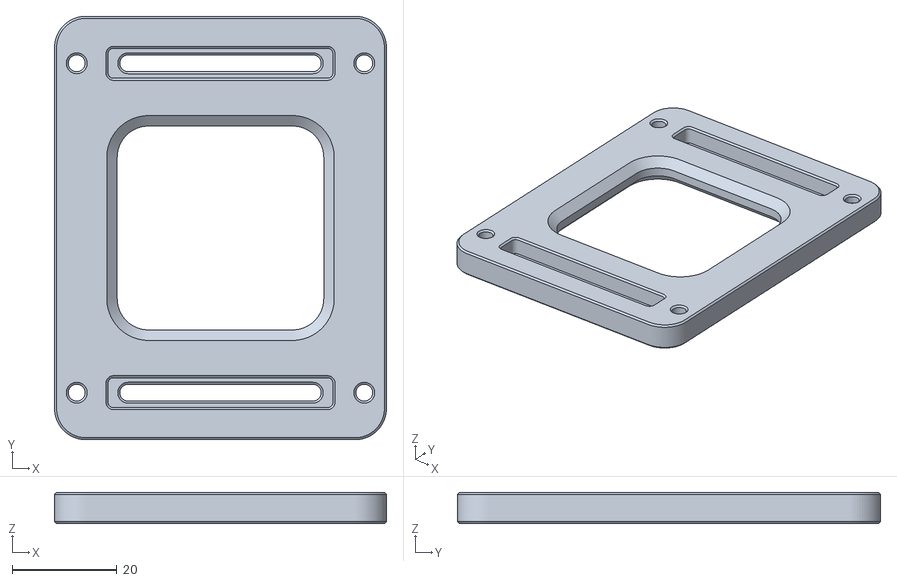
[picture p108: CAD file, 2020-11-01]
printer_mods/aeresov/MeanWell_UHP_DIN_mount/STLs/UHP 500 series.stl
63.5 x 81.0 x 6.00
