christophmuellerorg/VoronUsers/printer_mods/christophmueller/Voron0-Flippy-Spool-Holder/flippy_no_panel.stl

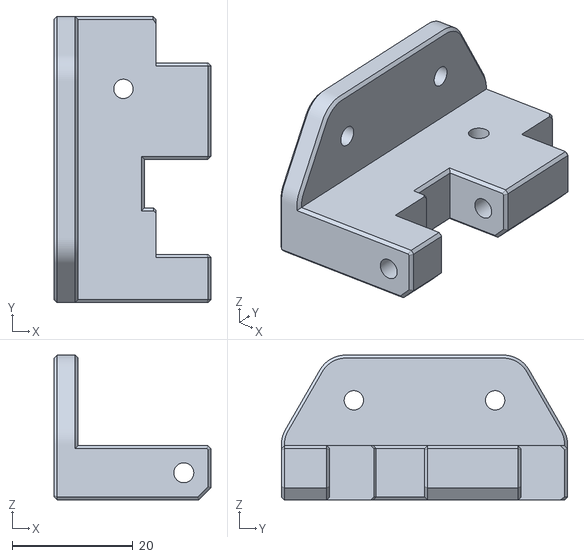
[picture p109: CAD file, 2020-11-19]
printer_mods/christophmueller/Voron0-Flippy-Spool-Holder/flippy_no_panel.stl
26.0 x 47.4 x 24.0
