christophmuellerorg/VoronUsers/printer_mods/christophmueller/Voron0-Integrated-Mini_12864/cover.stl

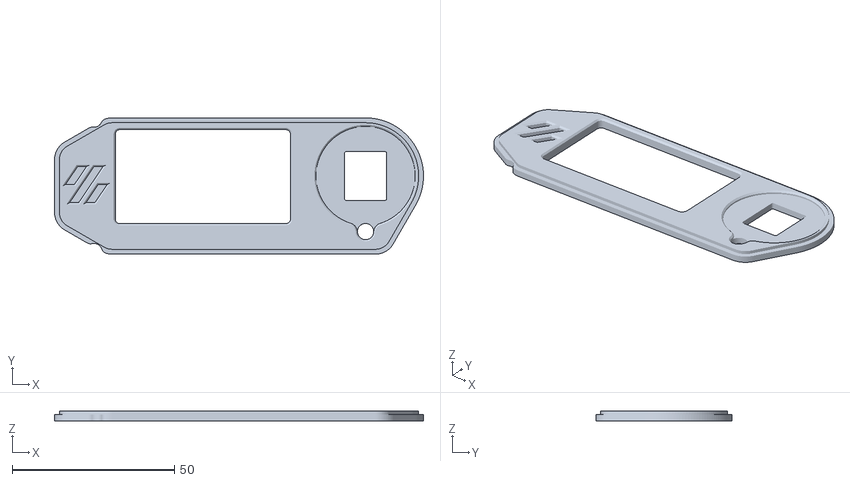
[picture p110: CAD file, 2020-11-19]
printer_mods/christophmueller/Voron0-Integrated-Mini_12864/cover.stl
113.7 x 42.0 x 3.00
