christophmuellerorg/VoronUsers/printer_mods/christophmueller/Voron0-Y-Splitter/split_top.stl

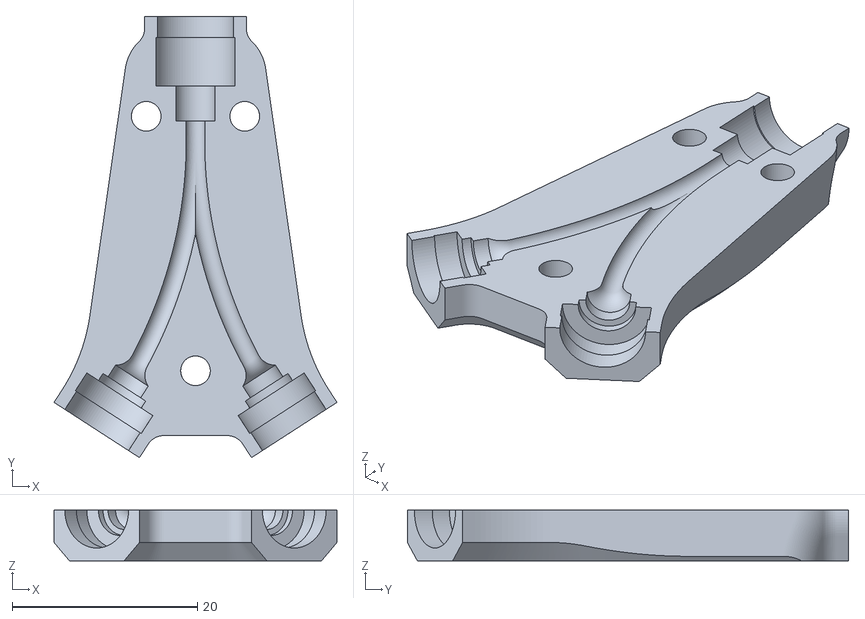
[picture p111: CAD file, 2020-11-19]
printer_mods/christophmueller/Voron0-Y-Splitter/split_top.stl
30.6 x 47.7 x 5.50
