christophmuellerorg/VoronUsers/printer_mods/DrGhetto/GhettoPanels/hatch_rear.stl

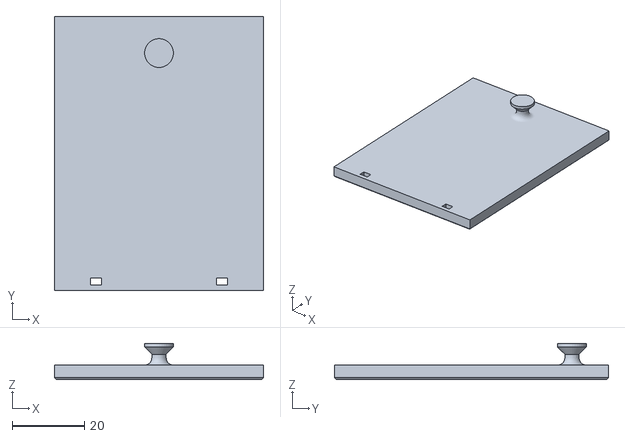
[picture p112: CAD file, 2020-11-01]
printer_mods/DrGhetto/GhettoPanels/hatch_rear.stl
58.0 x 76.0 x 10.0
