christophmuellerorg/VoronUsers/printer_mods/edwardyeeks/Decontaminator_Purge_Bucket_&_Nozzle_Scrubber/CAD/brush_holder_sheetstop_v1.8_v2.1-2-4_rev4.step

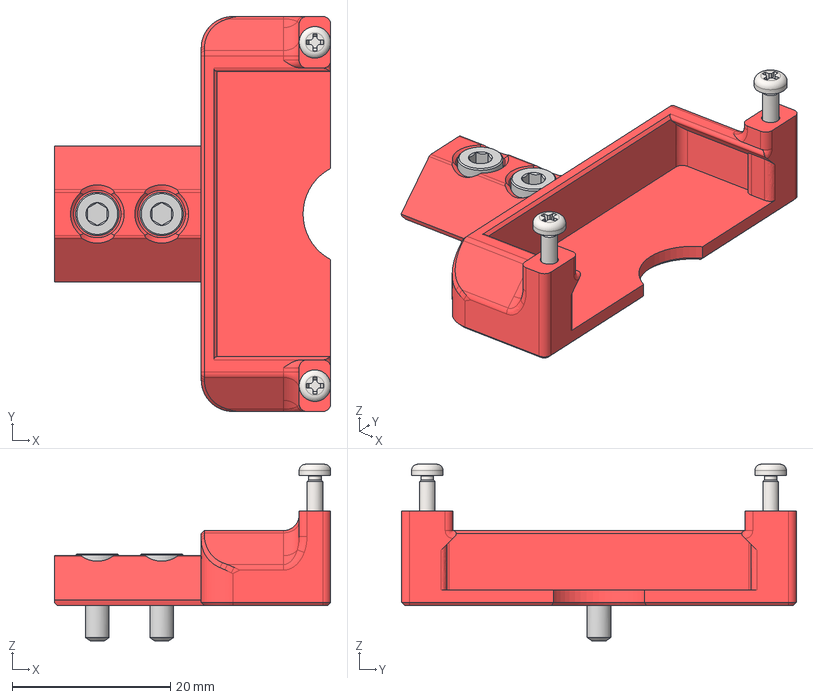
[picture p113: CAD file, 2020-11-01]
printer_mods/edwardyeeks/Decontaminator_Purge_Bucket_&_Nozzle_Scrubber/CAD/brush_holder_sheetstop_v1.8_v2.1-2-4_rev4.step
35.0 x 50.0 x 22.4 mm
M2X10 Self Tapping Screw x 2
M3x8 SHCS (1) x 2
M2X10 Self Tapping Screw (1)
M2X10 Self Tapping Screw (2)
Brush Holder Sheet Stop
