christophmuellerorg/VoronUsers/printer_mods/edwardyeeks/Decontaminator_Purge_Bucket_&_Nozzle_Scrubber/STLs/purge_bucket_300mm_rev4.stl

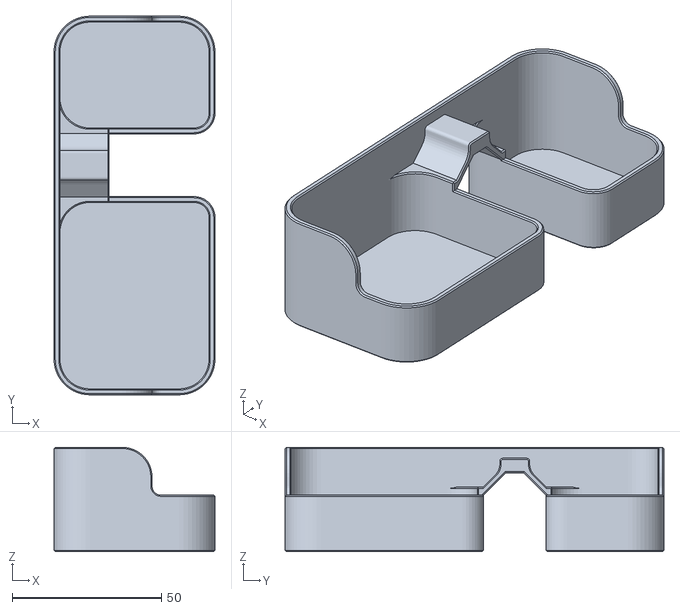
[picture p114: CAD file, 2020-11-01]
printer_mods/edwardyeeks/Decontaminator_Purge_Bucket_&_Nozzle_Scrubber/STLs/purge_bucket_300mm_rev4.stl
54.0 x 127.0 x 35.0
