christophmuellerorg/VoronUsers/printer_mods/Ellis/Badge_Retractor_Mount/STL/RetractorMount25deg.stl

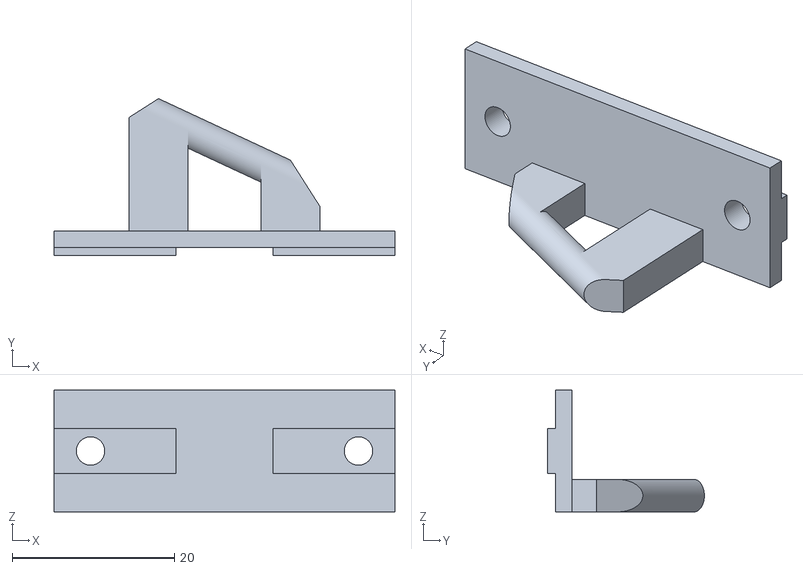
[picture p115: CAD file, 2020-11-01]
printer_mods/Ellis/Badge_Retractor_Mount/STL/RetractorMount25deg.stl
42.0 x 19.3 x 15.0
