christophmuellerorg/VoronUsers/printer_mods/Ellis/Short_Z_Joints/STL/Z Belt Clamp Lower.stl

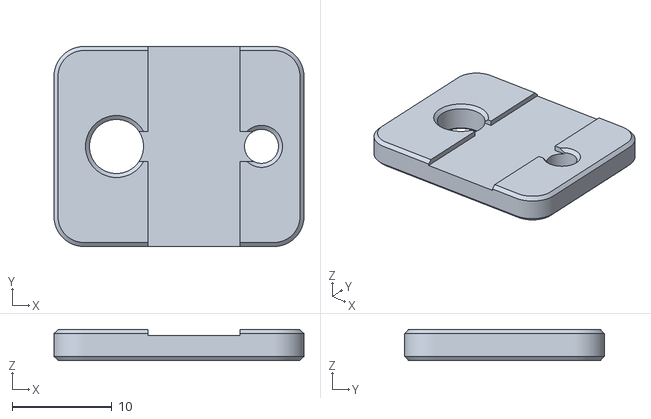
[picture p116: CAD file, 2020-11-01]
printer_mods/Ellis/Short_Z_Joints/STL/Z Belt Clamp Lower.stl
25.0 x 20.0 x 3.10
