christophmuellerorg/VoronUsers/printer_mods/FreeformFez/FilteredPower/skirt_300_filtered_power.stl

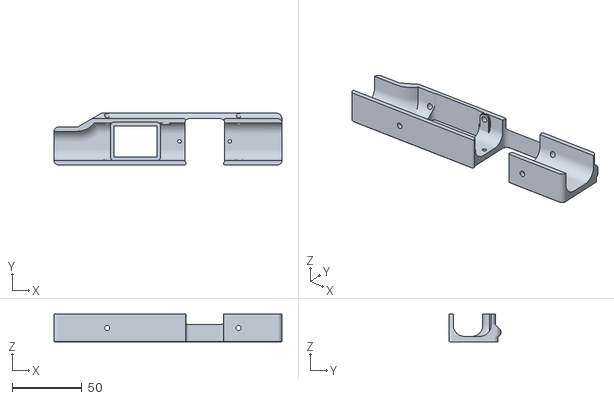
[picture p117: CAD file, 2020-11-01]
printer_mods/FreeformFez/FilteredPower/skirt_300_filtered_power.stl
163.0 x 37.0 x 20.0
