christophmuellerorg/VoronUsers/printer_mods/GSL12/pocketwatch_nema17/STL/VORON_Pocketwatch_Nema17_parts_Motor_Plate.stl

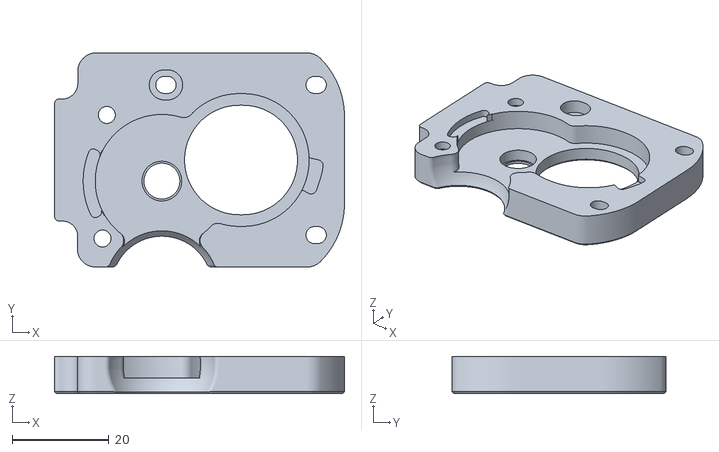
[picture p118: CAD file, 2020-11-01]
printer_mods/GSL12/pocketwatch_nema17/STL/VORON_Pocketwatch_Nema17_parts_Motor_Plate.stl
59.9 x 44.2 x 7.70
