christophmuellerorg/VoronUsers/printer_mods/hartk1213/Voron0_deck_panel_with_logo_and_VORON0/STLs/[b]_Voron0_deck_panel_0.stl

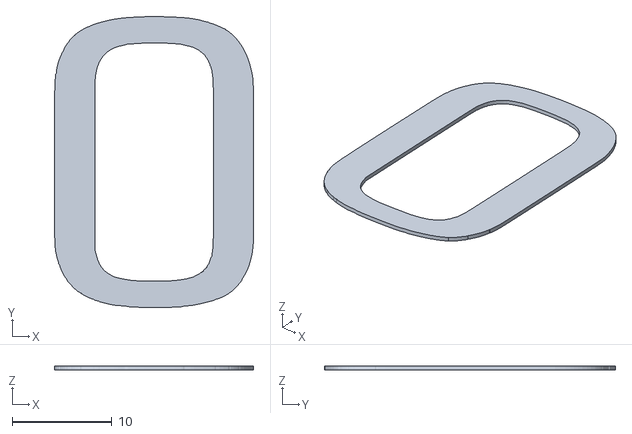
[picture p119: CAD file, 2020-11-01]
printer_mods/hartk1213/Voron0_deck_panel_with_logo_and_VORON0/STLs/[b]_Voron0_deck_panel_0.stl
20.0 x 29.1 x 0.398
