christophmuellerorg/VoronUsers/printer_mods/hartk1213/Voron0_display_dualcolor/STLs/Housing_Front_with_logo.stl

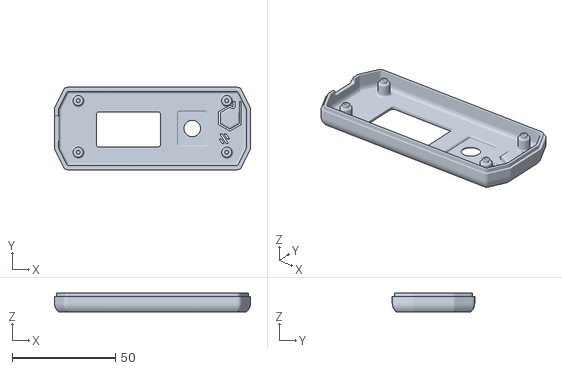
[picture p120: CAD file, 2020-11-01]
printer_mods/hartk1213/Voron0_display_dualcolor/STLs/Housing_Front_with_logo.stl
95.0 x 40.0 x 9.10
