christophmuellerorg/VoronUsers/printer_mods/hartk1213/Voron0_Hinged_Top_Hat/STL/TopHat_Alignment_Pin_x2.stl

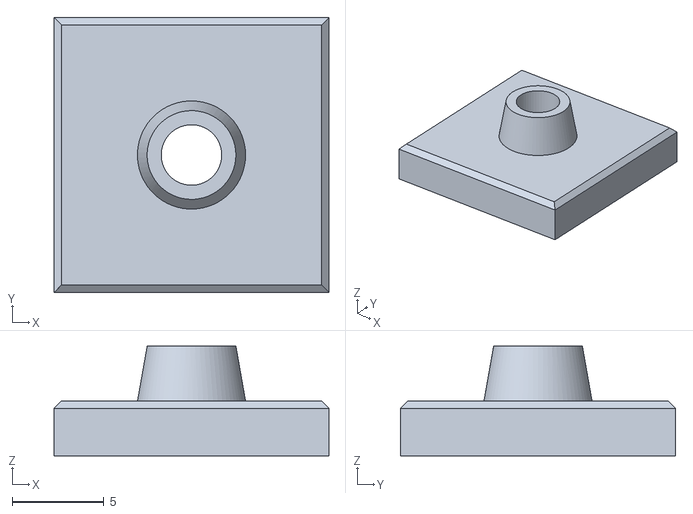
[picture p121: CAD file, 2020-11-01]
printer_mods/hartk1213/Voron0_Hinged_Top_Hat/STL/TopHat_Alignment_Pin_x2.stl
15.0 x 15.0 x 6.00
