christophmuellerorg/VoronUsers/printer_mods/hernsl/bottom_panel_mag_clip/bottom_panel_maghold_panel_x6.stl

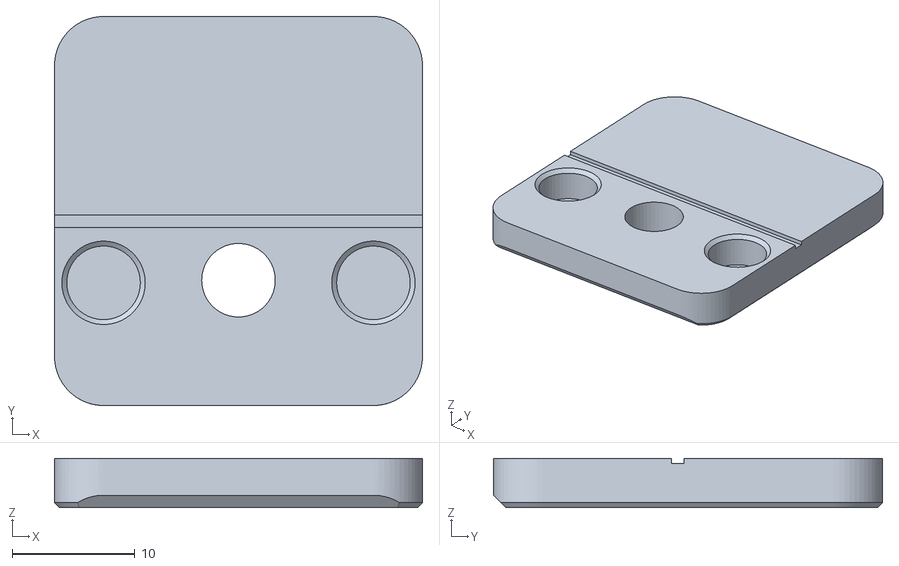
[picture p122: CAD file, 2020-11-01]
printer_mods/hernsl/bottom_panel_mag_clip/bottom_panel_maghold_panel_x6.stl
30.0 x 31.7 x 4.00
