christophmuellerorg/VoronUsers/printer_mods/hijax_pl/corner_panel_clip/corner_panel_clip_6mm.stl

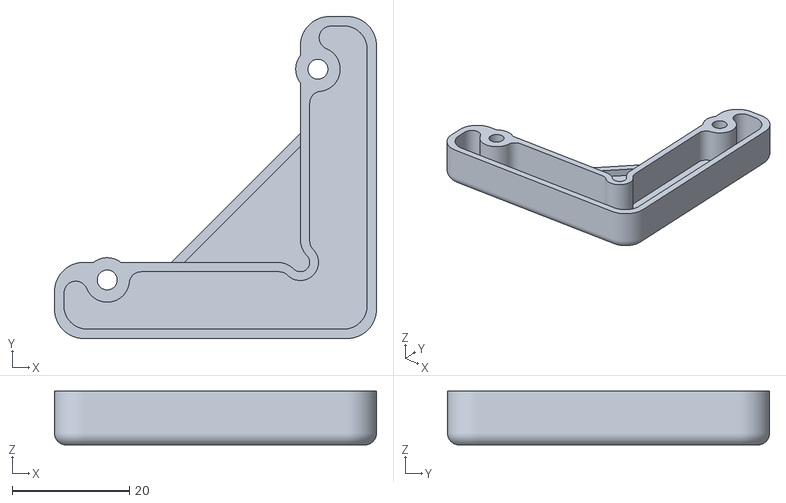
[picture p123: CAD file, 2020-11-01]
printer_mods/hijax_pl/corner_panel_clip/corner_panel_clip_6mm.stl
55.0 x 55.0 x 9.20
