christophmuellerorg/VoronUsers/printer_mods/Iakabos/V0_beltchain/Stock_Beltchain0_Bottom.stl

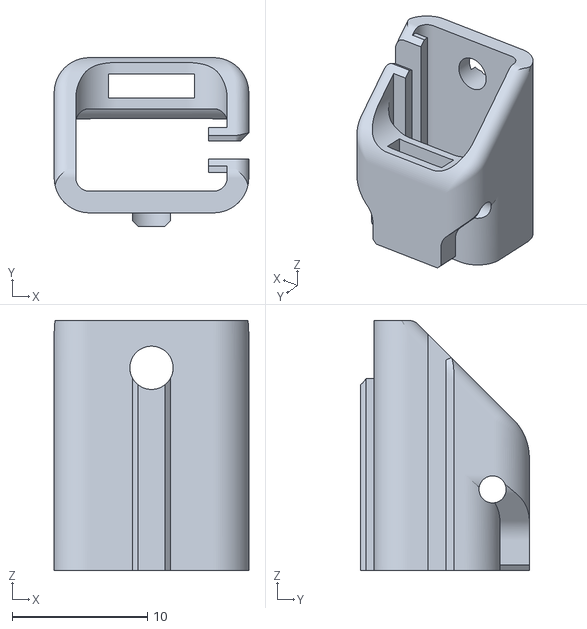
[picture p125: CAD file, 2020-11-01]
printer_mods/Iakabos/V0_beltchain/Stock_Beltchain0_Bottom.stl
14.4 x 12.5 x 18.5
