christophmuellerorg/VoronUsers/printer_mods/kirby/v0_sherpa_mini_direct_drive/STLs/v0_dd_hotend_left.stl

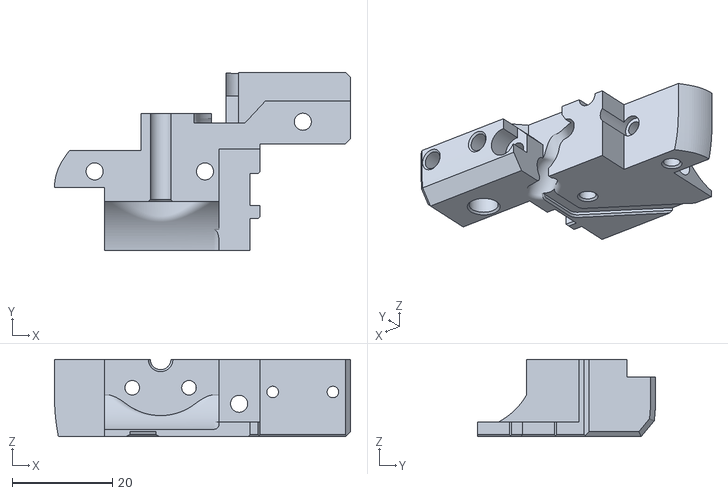
[picture p126: CAD file, 2020-11-01]
printer_mods/kirby/v0_sherpa_mini_direct_drive/STLs/v0_dd_hotend_left.stl
59.0 x 35.6 x 15.4
