christophmuellerorg/VoronUsers/printer_mods/Kruppes/Closed_Bottom/Common_STLs/Back_Lip.stl

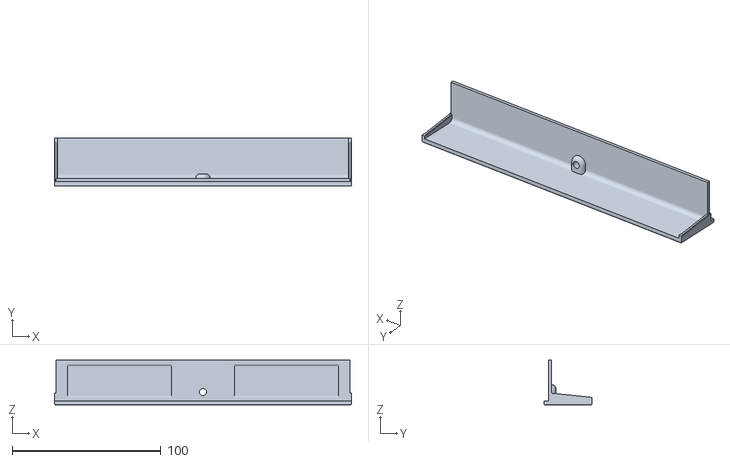
[picture p127: CAD file, 2020-11-01]
printer_mods/Kruppes/Closed_Bottom/Common_STLs/Back_Lip.stl
200.0 x 32.2 x 30.0
