christophmuellerorg/VoronUsers/printer_mods/Kruppes/Closed_Bottom/Fancy_Panel/[a]_Foot_Front_x2.stl

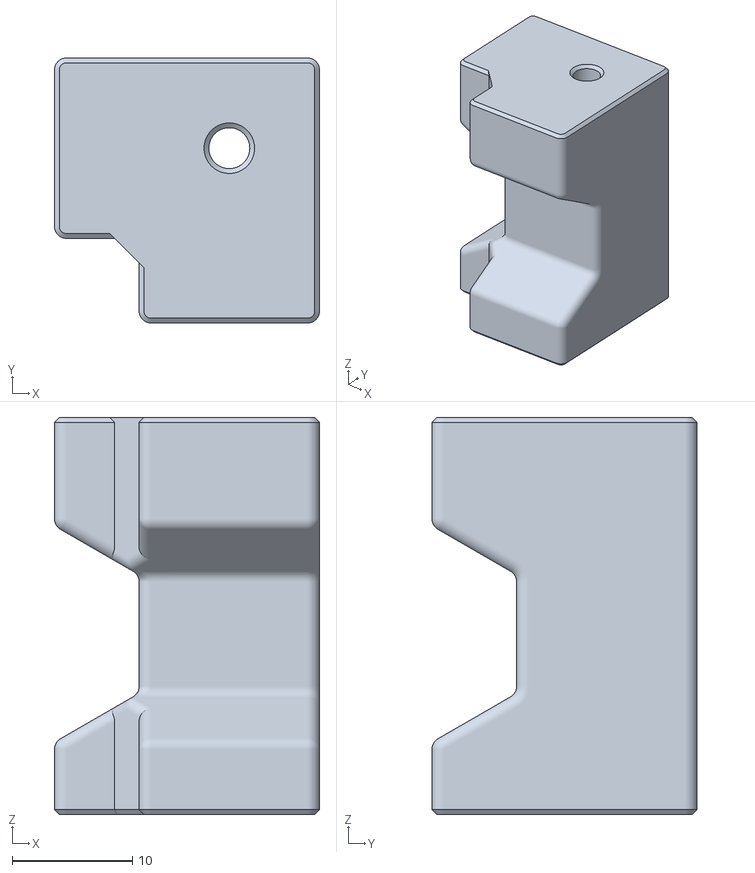
[picture p128: CAD file, 2020-11-01]
printer_mods/Kruppes/Closed_Bottom/Fancy_Panel/[a]_Foot_Front_x2.stl
22.0 x 22.0 x 33.0
