christophmuellerorg/VoronUsers/printer_mods/Kruppes/Closed_Bottom/Simple_Panel/[a]_Footback_L_x1.stl

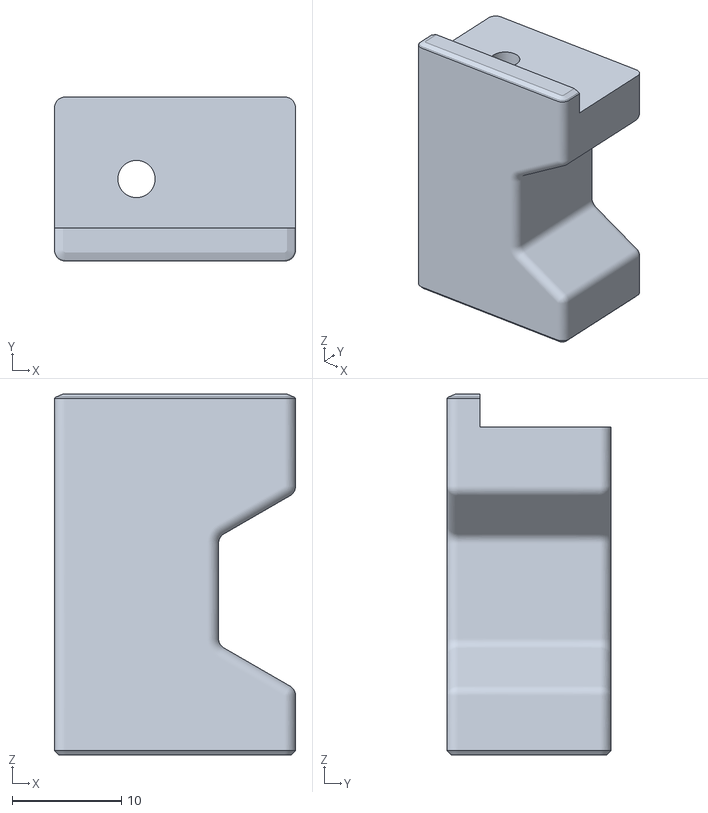
[picture p129: CAD file, 2020-11-01]
printer_mods/Kruppes/Closed_Bottom/Simple_Panel/[a]_Footback_L_x1.stl
22.0 x 15.0 x 33.0
