christophmuellerorg/VoronUsers/printer_mods/littleferris/V0_Skirt_Inlet/skirt_Inlet.stl

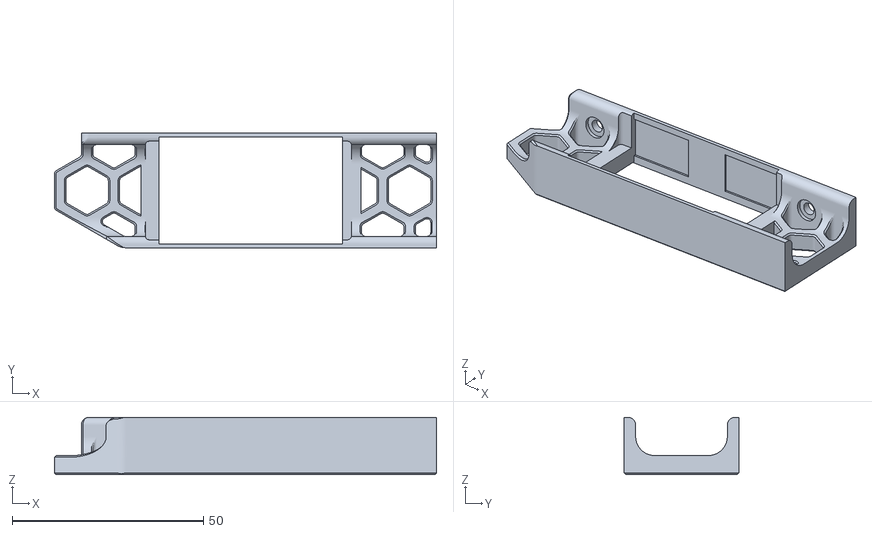
[picture p130: CAD file, 2020-11-01]
printer_mods/littleferris/V0_Skirt_Inlet/skirt_Inlet.stl
100.0 x 30.0 x 15.0
