christophmuellerorg/VoronUsers/printer_mods/MarcPot/Skirt_Mods/350/keystone_skirt_b_350.stl

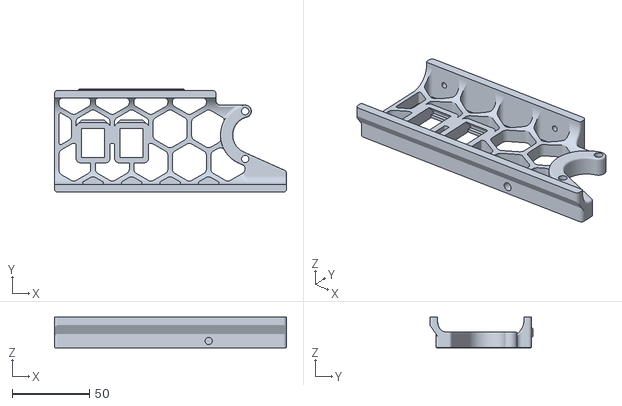
[picture p131: CAD file, 2020-11-01]
printer_mods/MarcPot/Skirt_Mods/350/keystone_skirt_b_350.stl
150.5 x 67.0 x 20.0
