christophmuellerorg/VoronUsers/printer_mods/MarcPot/UHP_PSU_Bracket_Clip/uhp_200_psu_bracket_double_rail_heatset_insert_x2.stl

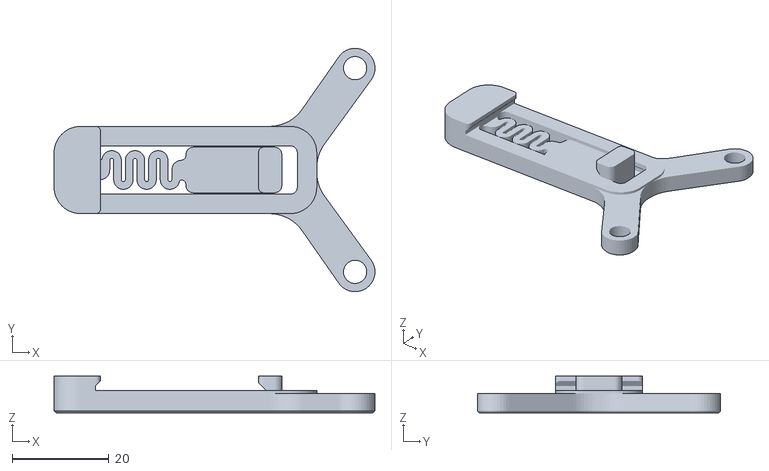
[picture p132: CAD file, 2020-11-01]
printer_mods/MarcPot/UHP_PSU_Bracket_Clip/uhp_200_psu_bracket_double_rail_heatset_insert_x2.stl
66.2 x 50.2 x 7.60
