christophmuellerorg/VoronUsers/printer_mods/mjoaris/10x11_Cable_Chain_Endcaps/CAD/10x11-chain-endcap1_nosupport.STEP

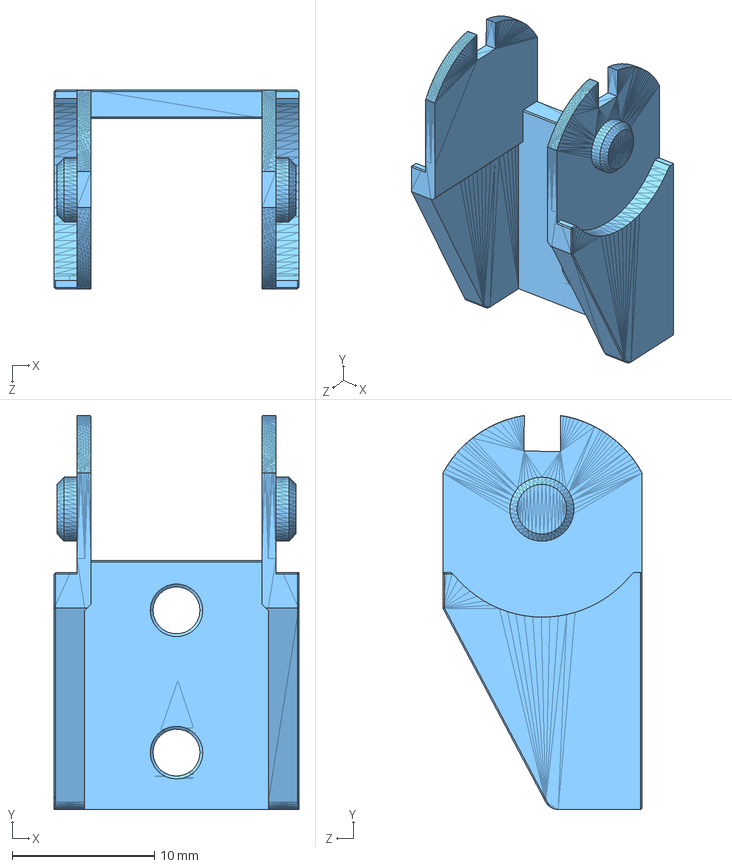
[picture p133: CAD file, 2020-11-01]
printer_mods/mjoaris/10x11_Cable_Chain_Endcaps/CAD/10x11-chain-endcap1_nosupport.STEP
17.2 x 27.7 x 14.0 mm
