christophmuellerorg/VoronUsers/printer_mods/Nomsplease/V0_Mods/pi_zero_camera_mount/camera_mount.step

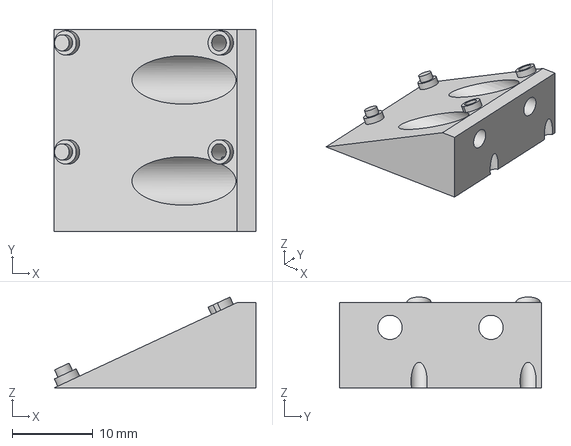
[picture p134: CAD file, 2020-11-01]
printer_mods/Nomsplease/V0_Mods/pi_zero_camera_mount/camera_mount.step
25.0 x 25.0 x 11.3 mm
