christophmuellerorg/VoronUsers/printer_mods/randell/Door_Hinges/drill_guide_handle_b.stl

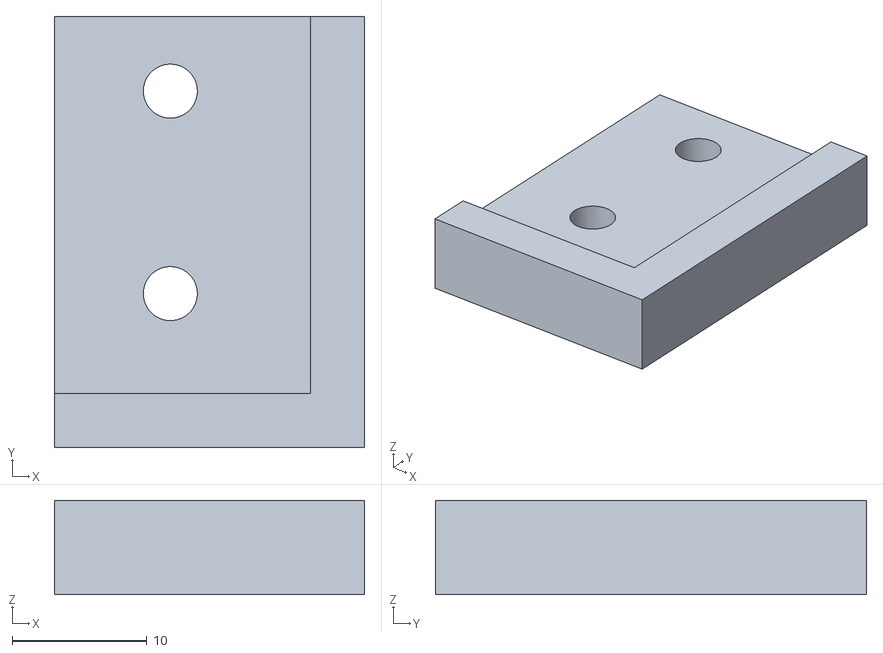
[picture p135: CAD file, 2020-11-01]
printer_mods/randell/Door_Hinges/drill_guide_handle_b.stl
23.0 x 31.9 x 7.00
