christophmuellerorg/VoronUsers/printer_mods/Slidr/PanzerChain2.4/stl/x_anchor_direct_drive_x1.stl

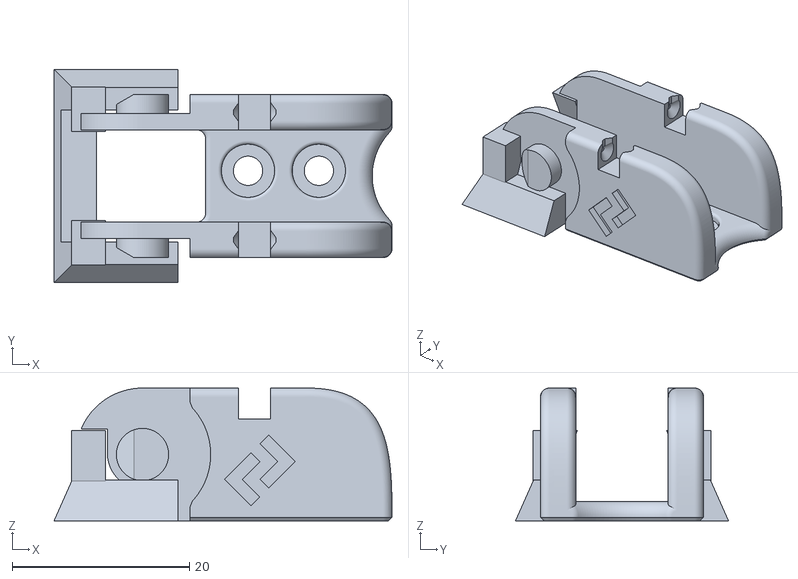
[picture p136: CAD file, 2020-11-01]
printer_mods/Slidr/PanzerChain2.4/stl/x_anchor_direct_drive_x1.stl
38.2 x 24.1 x 15.0
