christophmuellerorg/VoronUsers/printer_mods/Spaghetti-Bolognese/LCD_case_mod/Mini12864_Case_Rear.stl

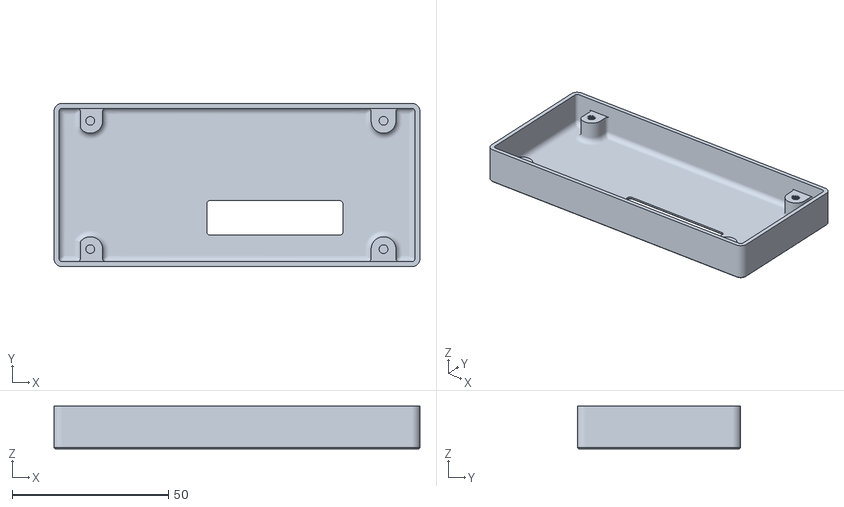
[picture p137: CAD file, 2020-11-01]
printer_mods/Spaghetti-Bolognese/LCD_case_mod/Mini12864_Case_Rear.stl
117.0 x 52.2 x 13.6
