christophmuellerorg/VoronUsers/printer_mods/StvPtrsn/320mm_Build/CAD/front_rear_skirt_ab_320_x2.step

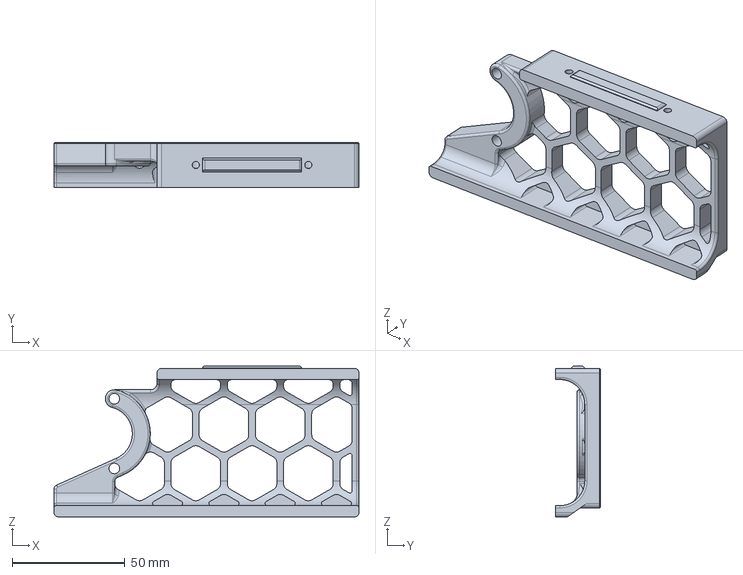
[picture p138: CAD file, 2020-11-01]
printer_mods/StvPtrsn/320mm_Build/CAD/front_rear_skirt_ab_320_x2.step
135.5 x 20.0 x 67.0 mm
