christophmuellerorg/VoronUsers/printer_mods/StvPtrsn/Keystone_Jack_Filtered_Mains_Panel/STL/rear_skirt_fmks_a_250.stl

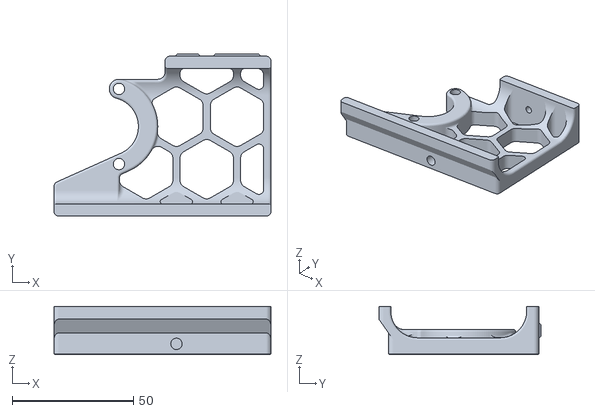
[picture p139: CAD file, 2020-11-01]
printer_mods/StvPtrsn/Keystone_Jack_Filtered_Mains_Panel/STL/rear_skirt_fmks_a_250.stl
89.5 x 67.0 x 20.0
