christophmuellerorg/VoronUsers/(list of files, cad)

Other CAD files:
printer_mods/madros/V0_skirt_OLED/stl/v0_skirt_Front_mod.STL
printer_mods/StvPtrsn/320mm_Build/STL/side_skirt_b_320_x2.stl
printer_mods/tayto-chip/skirt_switch_mod/250/front_rear_skirt_b_250.stl
printer_mods/tayto-chip/skirt_switch_mod/300/front_rear_skirt_b_300.stl
printer_mods/xbst_/V2.4_Skirt_Buttons/250/250_mirror.stl
printer_mods/eddie/V1.8_12mm_Z_Mod/STLs/z_bearing_block_a_12mm_x2.stl
printer_mods/edwardyeeks/V2.4_z_drive_motor_tensioner_mod/STLs/Skirts/250/250_front_rear_skirt_a_x2mod.stl
printer_mods/edwardyeeks/V2.4_z_drive_motor_tensioner_mod/STLs/Skirts/300/300_front_rear_skirt_a_x2mod.stl
printer_mods/edwardyeeks/V2.4_z_drive_motor_tensioner_mod/STLs/Skirts/350/350_front_rear_skirt_b_x2mod.stl
printer_mods/edwardyeeks/V2.4_z_drive_motor_tensioner_mod/STLs/z_motor_mount_b_mod_x2.stl
printer_mods/littleferris/V0_Skirt_Inlet/step/v0_foot_skirt_left.step
printer_mods/MarcPot/Skirt_Mods/250/keystone_skirt_a_250.stl
printer_mods/MarcPot/Skirt_Mods/300/keystone_skirt_b_300.stl
printer_mods/mosher/m3_door_hinges/Door Mount left x2.stl
printer_mods/Nomsplease/60mm_Shaft_Jig/60mm_Shaft_Jig_v2.step
printer_mods/Nomsplease/V0_Mods/panel_mounts/rear_bottom_right_bracket_with_stop.step
printer_mods/Spaghetti-Bolognese/Z_drive_motor_mount/Z_Motor_Mount_A.stl
printer_mods/StvPtrsn/320mm_Build/STL/front_rear_skirt_a_320_x2.stl
legacy_printers/printer_mods/Badnoob/Serial_Plate/voronserial_300.stl
legacy_printers/printer_mods/Danowar/AltZChain/Z_Anchor_Standoff.stl
legacy_printers/printer_mods/FHeilmann/VORON2_5mm_Parts/y_cable_bridge_5mm.stl
legacy_printers/printer_mods/Nashuar/7.0-WaveShare_Screen/ScreenBack_C.stl
legacy_printers/printer_mods/Nashuar/7.0-WaveShare_Screen/ScreenBack_H.stl
legacy_printers/printer_mods/Nashuar/7.0-WaveShare_Screen/ScreenFront_C.stl
legacy_printers/printer_mods/Nashuar/7.0-WaveShare_Screen/ScreenFront_H.stl
legacy_printers/printer_mods/Nashuar/7.0-WaveShare_Screen/ScreenMid_H.stl
legacy_printers/printer_mods/Nashuar/7.0-WaveShare_Screen/_Button_5x_H.stl
legacy_printers/printer_mods/Nashuar/7.0-WaveShare_Screen/swing_arm_long_2x.stl
legacy_printers/printer_mods/Nashuar/7.0-WaveShare_Screen/swing_arm_short_a.stl
legacy_printers/printer_mods/Nashuar/7.0-WaveShare_Screen/swing_arm_short_b.stl
legacy_printers/printer_mods/Nashuar/LEDBERG_LED_Mount/LEDBERG Mount.stl
legacy_printers/printer_mods/PhilLeMint/Dual_LED_Light_Mount/LED_DUAL_MOUNT.STL
legacy_printers/printer_mods/XIle/Afterburner_Umbilical.STL
legacy_printers/printer_mods/hackdoggo/v2/bmgobius/STL/BMGobius_Idler_A.STL
legacy_printers/printer_mods/nemgrea/5mm coroplast hardware/5mm_frame_spacer.STL
legacy_printers/printer_mods/nemgrea/5mm coroplast hardware/5mm_rear_coroplast_clip_x4.STL
legacy_printers/printer_mods/randommen96/Led_strip_mount_DIODER/DIODER_led_strip_mount.STL
legacy_printers/printer_mods/warriorofwire/openbuilds_drag_chain_2.1/a_corner_wire_guide.stl
legacy_printers/printer_mods/warriorofwire/openbuilds_drag_chain_2.1/x_carriage_frame_right_remodeled.stl
printer_mods/BlueBear/Deck_Panel_Backpack/Deck_Panel_Backpack.f3d
printer_mods/BlueBear/Deck_Panel_Backpack/Deck_Panel_Backpack.stl
printer_mods/DrGhetto/GhettoPanels/foot_filament_guide.stl
printer_mods/DrGhetto/GhettoPanels/panel_hinge_top.stl
printer_mods/DrGhetto/GhettoPanels/panel_left.stl
printer_mods/DrGhetto/GhettoPanels/panel_rear.stl
printer_mods/DrGhetto/GhettoPanels/panel_right.stl
printer_mods/DrGhetto/GhettoPanels/panel_right_iec.stl
printer_mods/Ellis/15x15_Drag_Chain_End/CAD/15x15_Drag_Chain_End.f3d
printer_mods/Ellis/Badge_Retractor_Mount/CAD/Retractor Mount Slanted.f3d
printer_mods/Ellis/Badge_Retractor_Mount/CAD/Retractor Mount Straight.f3d
printer_mods/Ellis/Badge_Retractor_Mount/STL/RetractorMount15deg.stl
printer_mods/Ellis/Badge_Retractor_Mount/STL/RetractorMount35deg.stl
printer_mods/Ellis/Short_Z_Joints/STL/Z Bearing Block Top.stl
printer_mods/FreeformFez/FilteredPower/Parametric Filtered Power v1.8.f3d
printer_mods/Iakabos/V0_beltchain/Mod_Beltchain0_Anchor_Open.stl
printer_mods/Iakabos/V0_beltchain/Mod_Beltchain0_Link_Slotted.stl
printer_mods/Iakabos/V0_beltchain/Stock_Beltchain0_Adapter.stl
printer_mods/Iakabos/V0_beltchain/Stock_Beltchain0_Link.stl
printer_mods/Iakabos/V0_beltchain/Stock_Beltchain0_Top.stl
printer_mods/Kruppes/Closed_Bottom/Fancy_Panel/Bottompanel_fancy.dxf
printer_mods/Kruppes/Closed_Bottom/Simple_Panel/[a]_Footback_x1.stl
printer_mods/Kruppes/Closed_Bottom/Simple_Panel/[a]_Footfront_x2.stl
printer_mods/MarcPot/Skirt_Mods/250/hour_counter_skirt_a_250.stl
printer_mods/MarcPot/Skirt_Mods/250/keystone_skirt_b_250.stl
printer_mods/MarcPot/Skirt_Mods/300/hour_counter_skirt_b_300.stl
printer_mods/MarcPot/Skirt_Mods/300/keystone_skirt_a_300.stl
printer_mods/MarcPot/Skirt_Mods/350/hour_counter_skirt_a_350.stl
printer_mods/MarcPot/Skirt_Mods/350/keystone_skirt_a_350.stl
printer_mods/MarcPot/UHP_PSU_Bracket_Clip/CAD/UHP_PSU_Bracket_Double_Rail_Heatset_Insert.f3d
printer_mods/MarcPot/UHP_PSU_Bracket_Clip/CAD/UHP_PSU_Bracket_Double_Rail_Hexnut.f3d
printer_mods/MarcPot/UHP_PSU_Bracket_Clip/CAD/UHP_PSU_Bracket_Heatset_Insert.f3d
printer_mods/MarcPot/UHP_PSU_Bracket_Clip/CAD/UHP_PSU_Bracket_Hexnut.f3d
printer_mods/MarcPot/UHP_PSU_Bracket_Clip/uhp_200_psu_bracket_double_rail_hexnut_x2.stl
printer_mods/MarcPot/UHP_PSU_Bracket_Clip/uhp_200_psu_bracket_heatset_insert.stl
printer_mods/Nomsplease/V0_Mods/duet_wifi_mount/duet_wifi_mount.stl
printer_mods/Nomsplease/V0_Mods/led_mounts/10mm_strip_mount_full.stl
printer_mods/Nomsplease/V0_Mods/led_mounts/10mm_strip_mount_full_with_channel.stl
printer_mods/Nomsplease/V0_Mods/led_mounts/12mm_strip_mini_mount.step
printer_mods/Nomsplease/V0_Mods/led_mounts/12mm_strip_mini_mount.stl
printer_mods/Nomsplease/V0_Mods/panel_mounts/rear_bottom_left_bracket_with_stop.stl
printer_mods/Nomsplease/V0_Mods/panel_mounts/rear_bottom_right_bracket_with_stop.stl
printer_mods/Nomsplease/V0_Mods/pi_zero_camera_mount/camera_mount.stl
printer_mods/Nomsplease/V0_Mods/pi_zero_camera_mount/pi_zero_mount.stl
printer_mods/Nomsplease/V0_Mods/pocket_watch_rear_relocation/pocket_watch_rear_mount.stl
printer_mods/Slidr/PanzerChain2.4/stl/x_anchor_mount_direct_drive2_no_cover_x1.stl
printer_mods/Slidr/PanzerChain2.4/stl/xy_anchor_bridge_x1.stl
printer_mods/Slidr/PanzerChain2.4/stl/xy_anchor_extrusion_x2.stl
printer_mods/Slidr/PanzerChain2.4/stl/xy_bridge_x1.stl
printer_mods/Slidr/PanzerChain2.4/stl/xyz_clip.stl
printer_mods/Slidr/PanzerChain2.4/stl/z_anchor_frame_x1.stl
printer_mods/Slidr/PanzerChain2.4/stl/z_anchor_gantry_x1.stl
printer_mods/Slidr/PanzerChain2.4/stl/z_link.stl
printer_mods/Spaghetti-Bolognese/LCD_case_mod/Mini12864_Case_Assembly.f3d
printer_mods/Spaghetti-Bolognese/Z_drive_motor_mount/Z_Motor_Mount _B.f3d
printer_mods/Spaghetti-Bolognese/Z_drive_motor_mount/Z_Motor_Mount_A.f3d
printer_mods/StvPtrsn/320mm_Build/CAD/side_skirt_ab_320_x2.f3d
printer_mods/StvPtrsn/320mm_Build/STL/front_rear_skirt_b_320_x2.stl
printer_mods/StvPtrsn/320mm_Build/STL/side_skirt_a_320_x2.stl
printer_mods/StvPtrsn/Keystone_Jack_Filtered_Mains_Panel/CAD/plug_panel_filtered_mains_keystone.f3d
printer_mods/StvPtrsn/Keystone_Jack_Filtered_Mains_Panel/CAD/rear_skirt_filtered_mains_keystone.f3d
printer_mods/StvPtrsn/Keystone_Jack_Filtered_Mains_Panel/STL/Plug_Panel_Filtered_mains_keystone.stl
printer_mods/StvPtrsn/Keystone_Jack_Filtered_Mains_Panel/STL/[a]_keystone_blank_insert.stl
printer_mods/StvPtrsn/Keystone_Jack_Filtered_Mains_Panel/STL/rear_skirt_fmks_a_300.stl
printer_mods/StvPtrsn/Keystone_Jack_Filtered_Mains_Panel/STL/rear_skirt_fmks_a_320.stl
printer_mods/StvPtrsn/Keystone_Jack_Filtered_Mains_Panel/STL/rear_skirt_fmks_a_350.stl
printer_mods/StvPtrsn/Keystone_Jack_Filtered_Mains_Panel/STL/rear_skirt_fmks_b_250.stl
printer_mods/StvPtrsn/Keystone_Jack_Filtered_Mains_Panel/STL/rear_skirt_fmks_b_300.stl
printer_mods/StvPtrsn/Keystone_Jack_Filtered_Mains_Panel/STL/rear_skirt_fmks_b_350.stl
printer_mods/StvPtrsn/Side_Fan_Support_No_Tape/CAD/[a]_60mm_fan_emptygrill.step
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
