christophmuellerorg/VoronUsers/printer_mods/tayto-chip/skirt_switch_mod/README.md

<h1>V2.4 Front and Side skirt with switch mod</h1>

<h3>**Follow the manual for instructions on installation and wiring.** </h3><br/><br/>

NOTE: I am by no means a CAD professional. I have only tested the 300mm mods. Feel free to contact me on the Voron discord (tayto-chip) if you would like the step files. <br/><br/>

All screw and heat-set insert holes are unchanged. <br/><br/>

Switch used is from the V2.4 sourcing guide: [ZF Rocker Switch](https://www.digikey.com/en/products/detail/zf-electronics/WRG32F2FBBNN/446050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)

<h3>Images</h3>

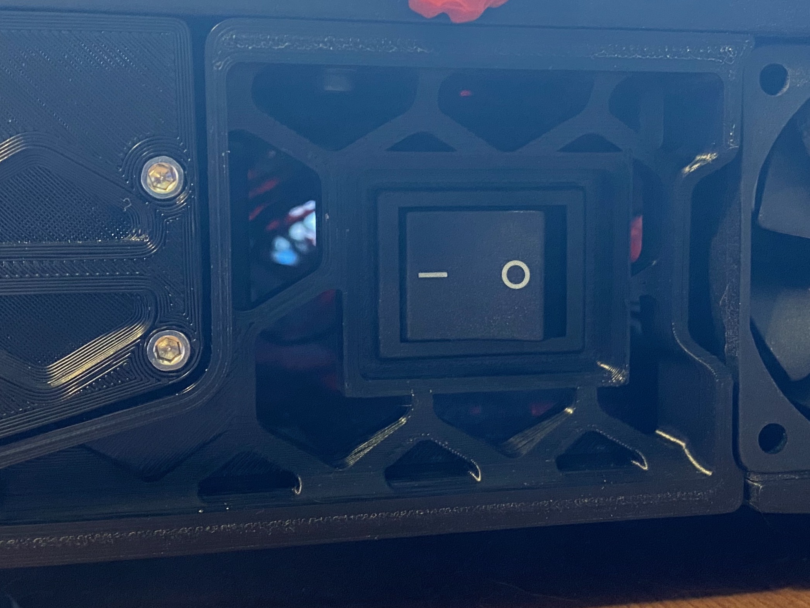
[picture p140: printer_mods/tayto-chip/skirt_switch_mod/images/IMG_1224.jpeg]
Skirt Switch
 <br/>
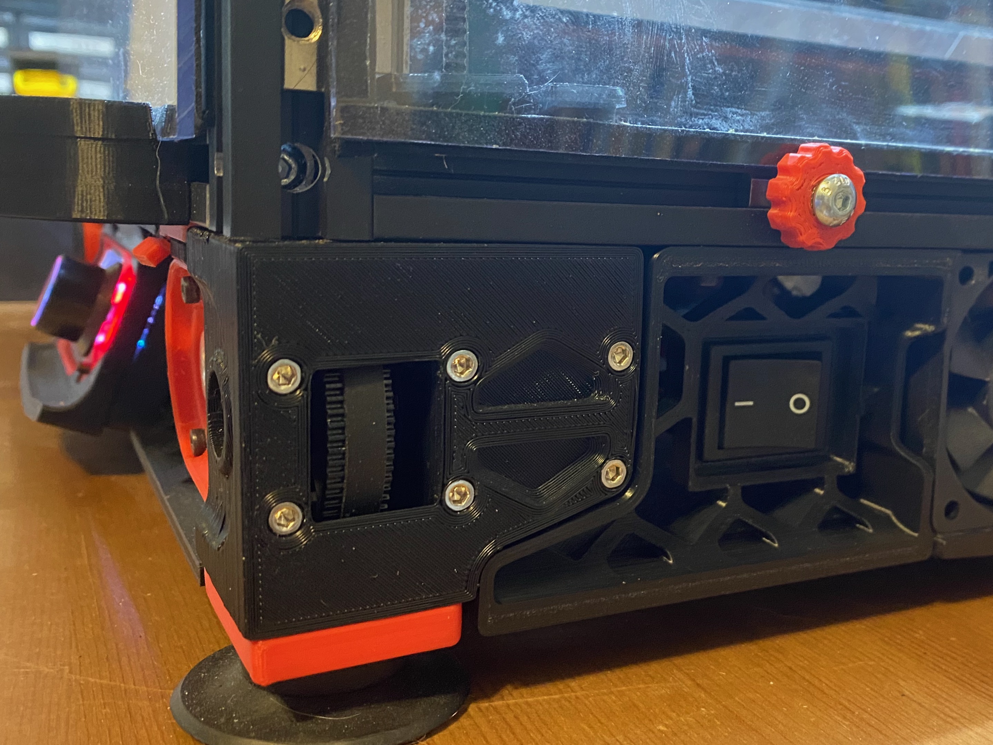
[picture p141: printer_mods/tayto-chip/skirt_switch_mod/images/IMG_1222.jpeg]
Skirt Switch
