christophmuellerorg/VoronUsers/printer_mods/d3nny/mains_plug_panel_for_RND_165-00057/README.md

This is a modified plug panel designed to be used with the RND 165-00057 mains filter with integrated switch sold by [Reichelt](https://www.reichelt.de/entstoerfilter-6-a-c14-snap-in-rnd-165-00057-p253031.html?&trstct=pos_0&nbc=1), [Distrelec](https://www.distrelec.ch/de/geraetestecker-mit-filter-6a-250vac-rnd-components-rnd-165-00057/p/30101820) or [ELFA](https://www.elfa.se/en/power-inlet-with-filter-6a-250vac-rnd-components-rnd-165-00057/p/30101820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)
For Version 2.4.
