christophmuellerorg/VoronUsers/printer_mods/DorjeDorf/Duet_3_6HC_Din_Bracket/readme.md

Please use the generic PCB DIN Clip and mount these on top. 

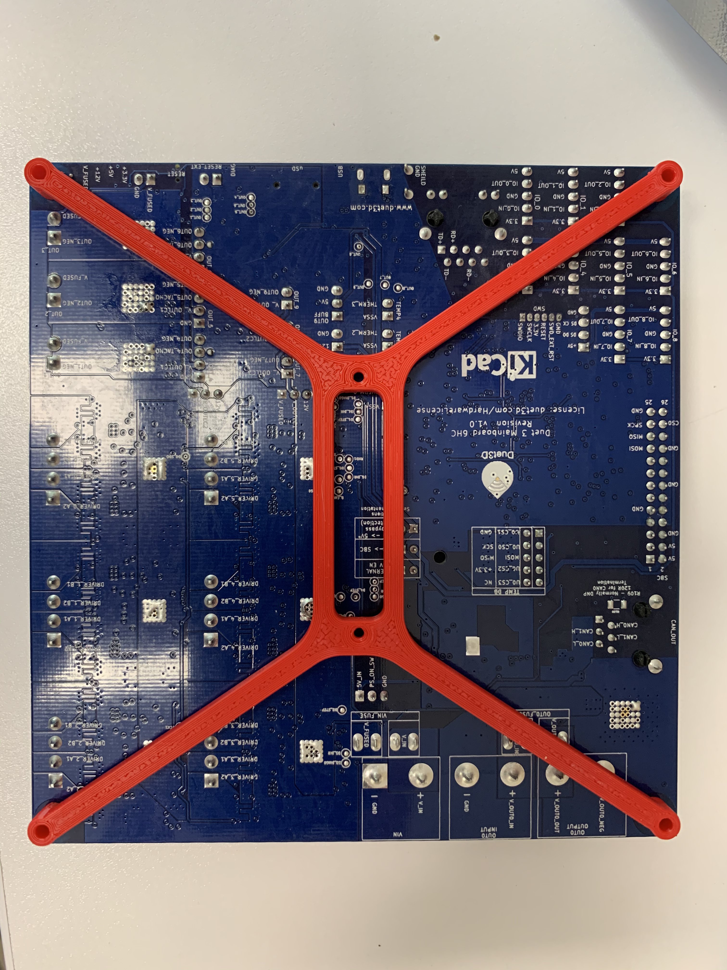
[picture p151: printer_mods/DorjeDorf/Duet_3_6HC_Din_Bracket/Example print (courtesy of medicusdkfz).jpg]
Example print, courtesy of medicusdkfz)

Image coutersy of medicusdkfz
