christophmuellerorg/VoronUsers/printer_mods/Ellis/15x15_Drag_Chain_End/README.md

<B>15x15 Drag Chain End</B>

End pieces for 15x15 drag chains. Designed around Cloudray China chains, but will likely work with other chain brands too.

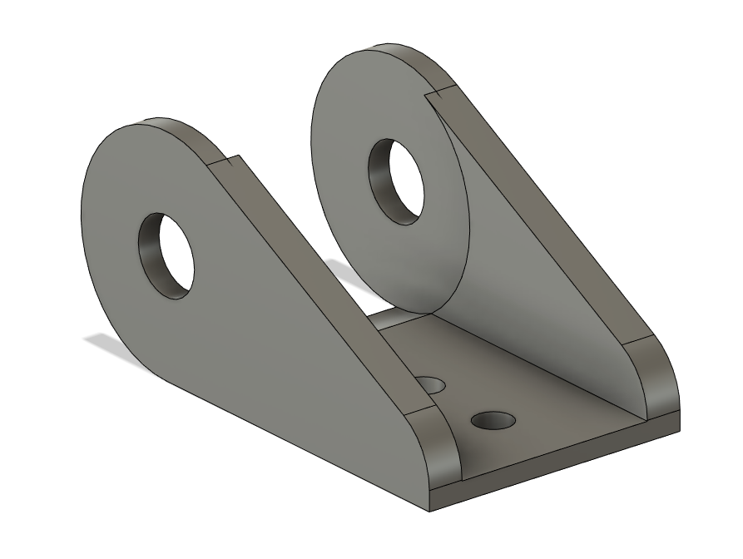
[picture p160: printer_mods/Ellis/15x15_Drag_Chain_End/Images/Image.png]
