christophmuellerorg/VoronUsers/printer_mods/Ellis/Short_Z_Joints/README.md

<B>Shorter Z joints for Voron 2.4</B>

This mod reduces the size of the Z joint stack by 12.5mm.

The intent is to increase gantry stability by reducing the leverage on the Z ball joints while throwing the toolhead around.

This is only tested with microswitch XY endstops. There is no hall effect magnet slot, though you may be able to affix one to the upper right screw head.

To use this mod, you will need:
- 4x M5x30 SHCS/BHCS
- 4x M5x20 BHCS
- 4x M3x20 SHCS
- 4x M5 nylon lock nuts <I>(optional*)</I>

<I>* You can use standard M5 nuts as per the original config, however I prefer nylock nuts here.</I>

<B>Side by Side</B>
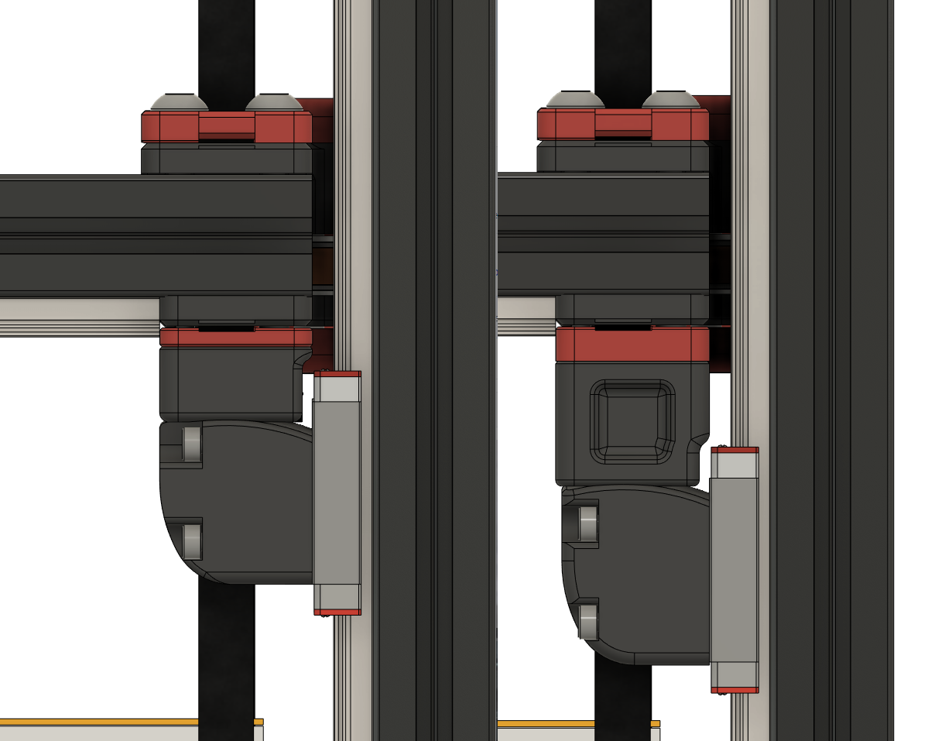
[picture p161: printer_mods/Ellis/Short_Z_Joints/Images/Side-By-Side.png]
Side by Side


<B>Cross Section</B>
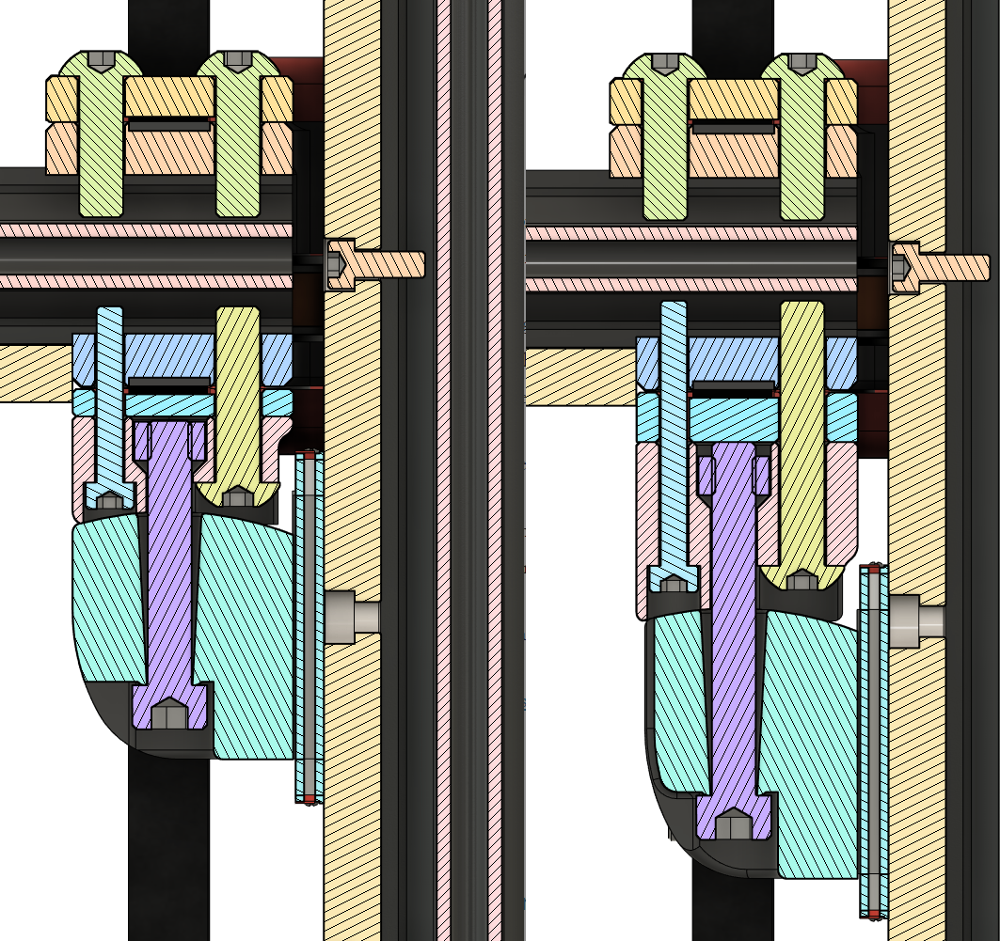
[picture p162: printer_mods/Ellis/Short_Z_Joints/Images/Side-By-Side-Cross-Section.png]
Cross Section
