christophmuellerorg/VoronUsers/printer_mods/hartk1213/Voron0_C14Inlet/Readme.md

# C14 Fused inlet for the V0 with a cover on the back to cover the contacts

This is a mount for a c14 fused inlet found here on amazon 
https://smile.amazon.com/Antrader-Module-Socket-Switch-IEC320/dp/B07CTC5JVV

this uses 2 M3x40 screws to assemble and 2 M3x12 screws to attach to the frame
 
##### Pictures
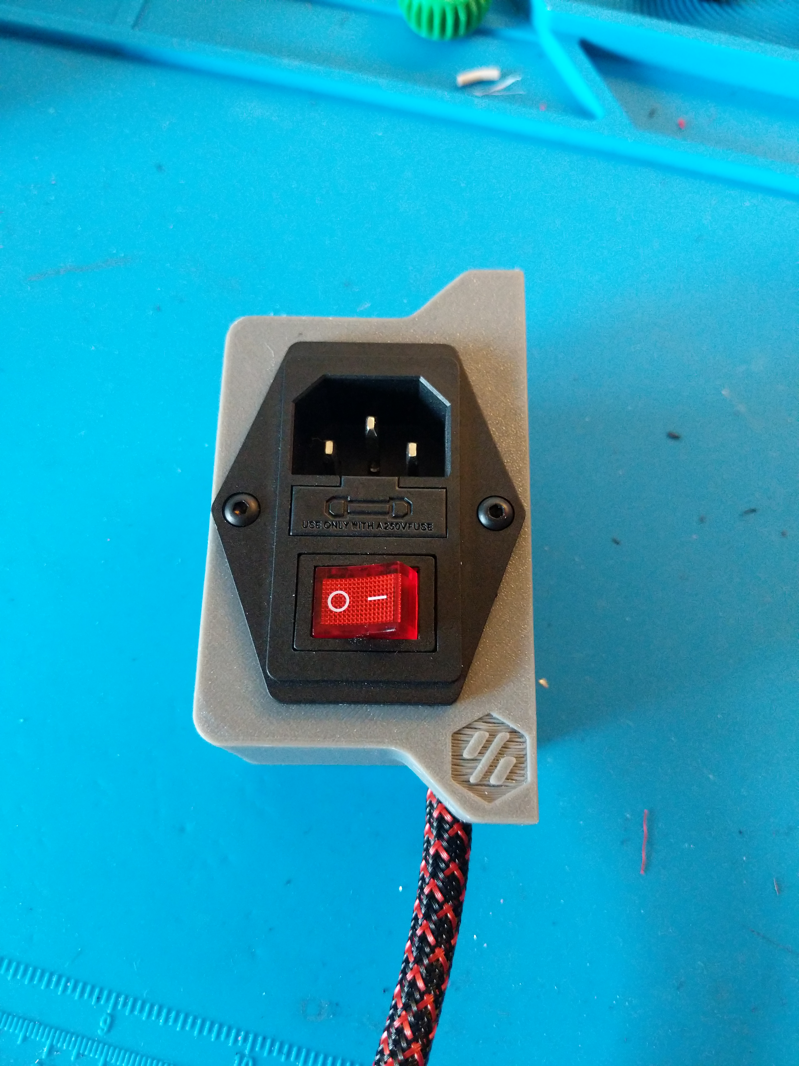
[picture p166: printer_mods/hartk1213/Voron0_C14Inlet/Images/1.jpg]

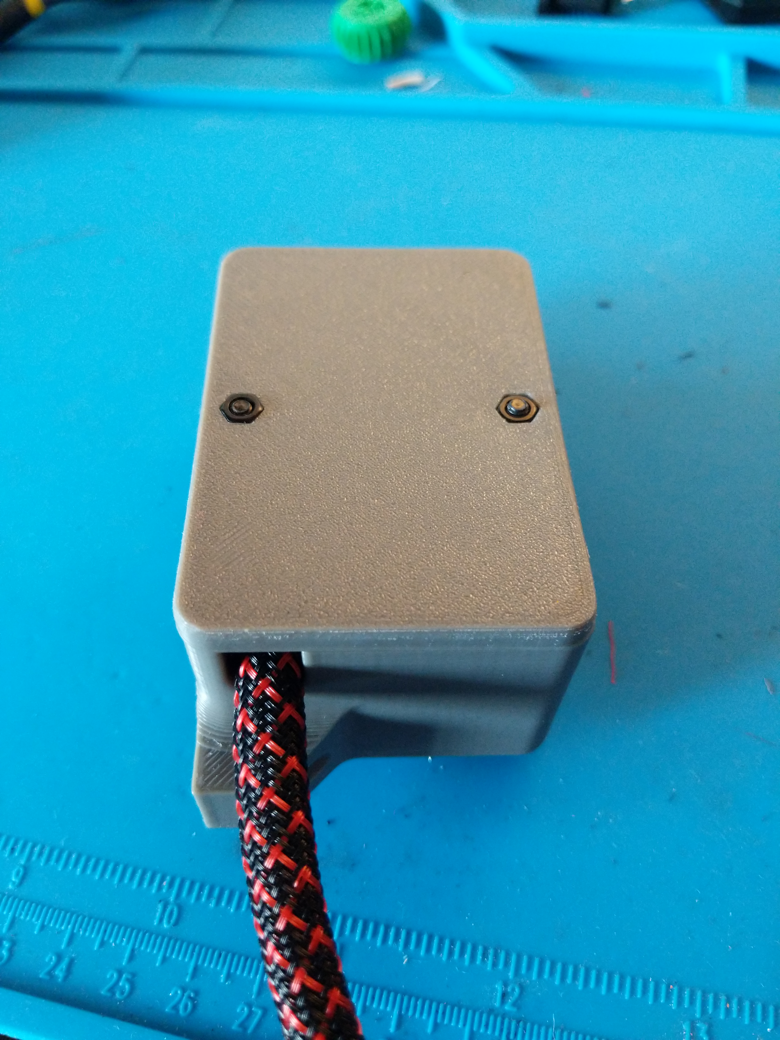
[picture p167: printer_mods/hartk1213/Voron0_C14Inlet/Images/2.jpg]

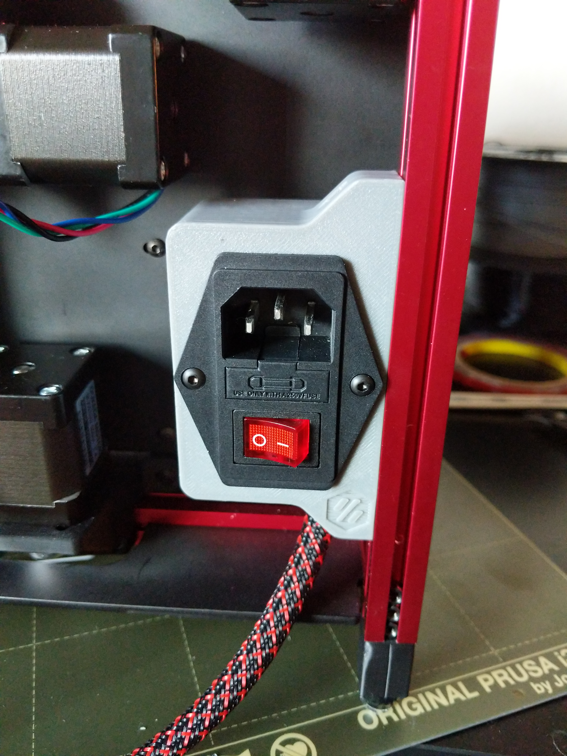
[picture p168: printer_mods/hartk1213/Voron0_C14Inlet/Images/3.jpg]
