christophmuellerorg/VoronUsers/printer_mods/hartk1213/Voron0_Hinged_Top_Hat/Readme.md

# Hinged Hat for the V0

This is my new design for a fold away hinged top hat for the V0, i have included the step file for all the parts i designed, as well as added a BOM for everything you need to get in order to build this, 

assembling is pretty straight forward i have added the steps i took when assembling it in picture form [here](Images/Assembly) 

# Step 1
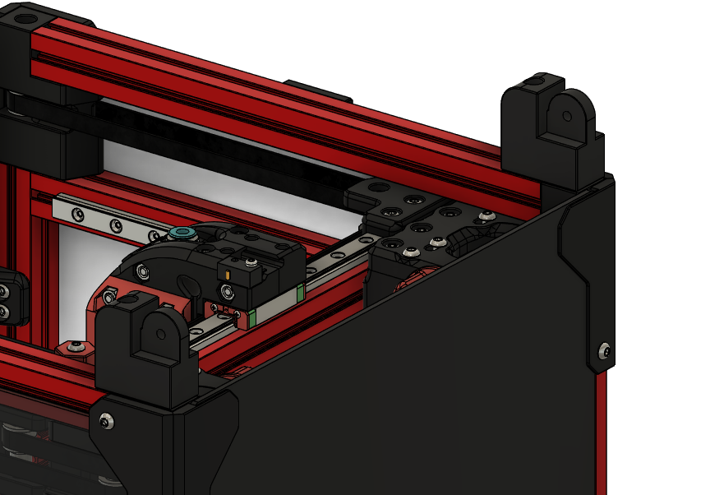
[picture p171: printer_mods/hartk1213/Voron0_Hinged_Top_Hat/Images/Assembly/step1.png]
bottom hinge parts
 was attach the bottom hinge pieces to the top of the V0 first with the little pegs on the bottom hinges going into the holes on the A and B drive parts that attach to the top 1515 extrusion 

# Step 2
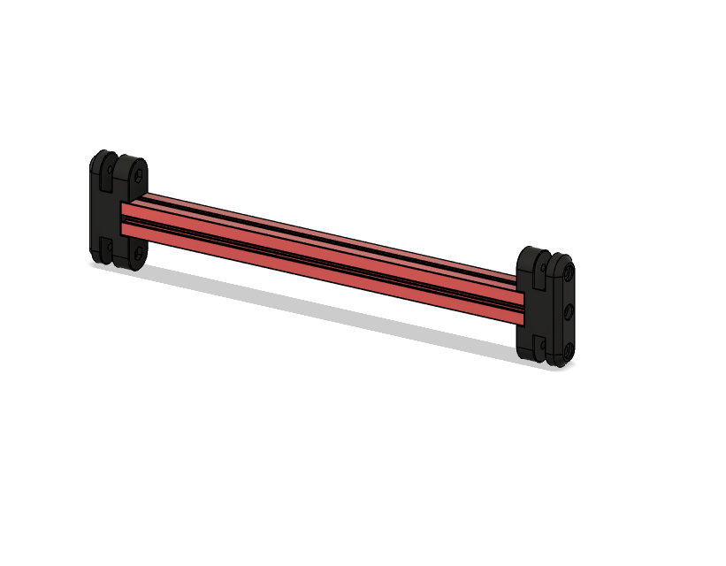
[picture p172: printer_mods/hartk1213/Voron0_Hinged_Top_Hat/Images/Assembly/step2.png]
build the middle hinge assembly
 
this uses m3x16 screws to attach the 200mm extrsusion to the printed parts

# Step 3
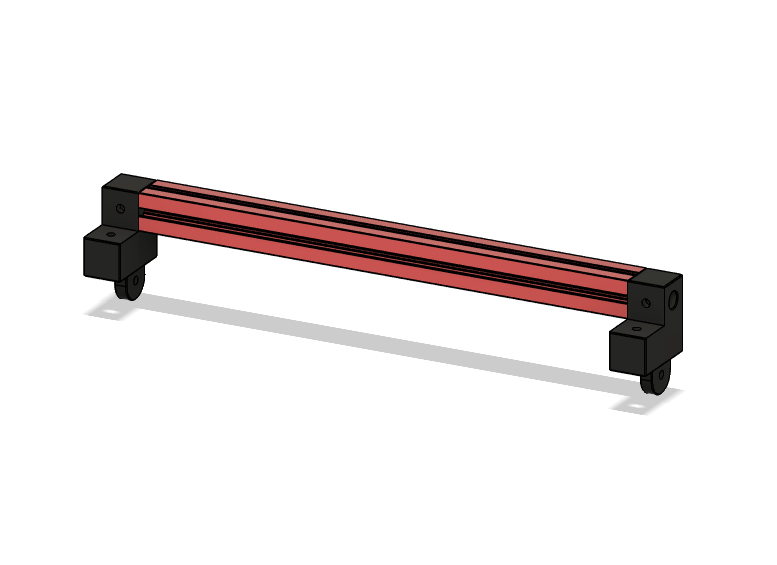
[picture p173: printer_mods/hartk1213/Voron0_Hinged_Top_Hat/Images/Assembly/step3.png]
build the top hinge rear frame
 
next is the rear frame for the top hinge 

# Step 4
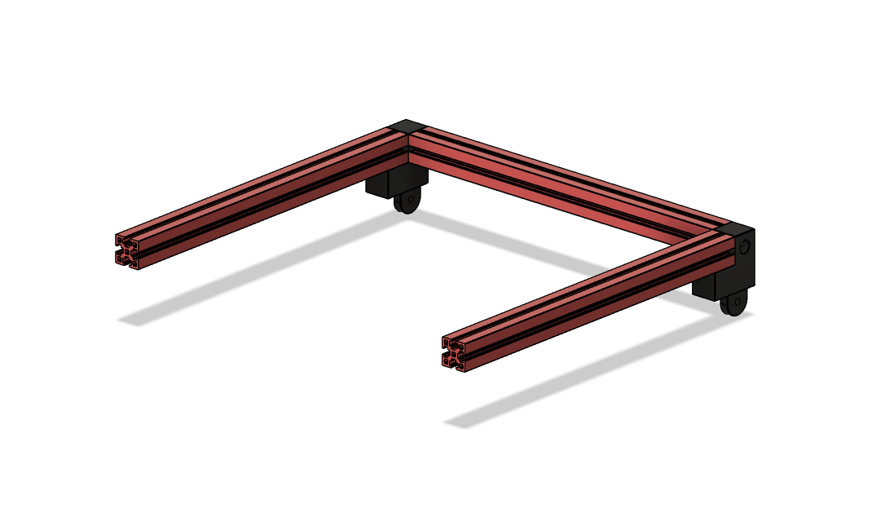
[picture p174: printer_mods/hartk1213/Voron0_Hinged_Top_Hat/Images/Assembly/step4.png]
 
these are 200mm extrions 

# Step 5
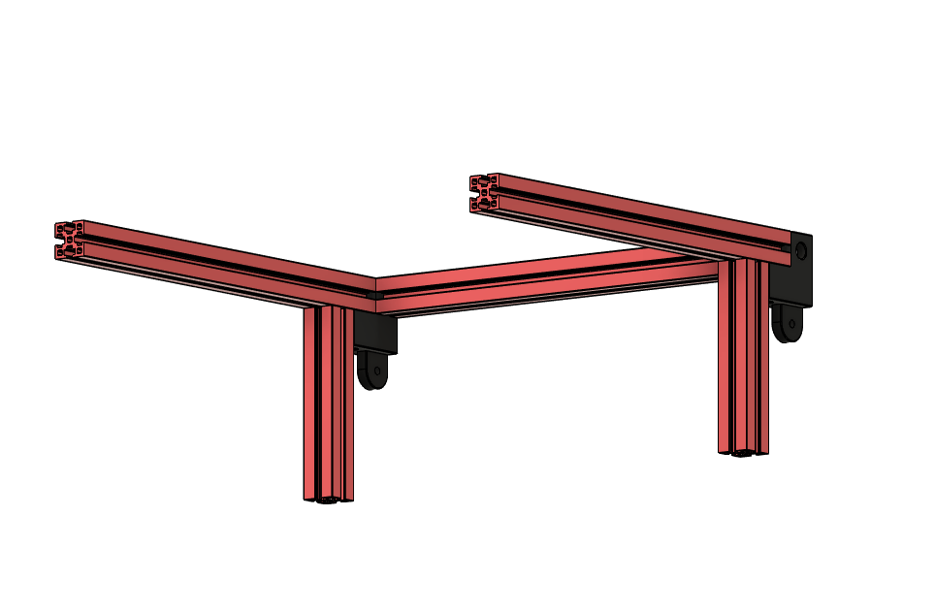
[picture p175: printer_mods/hartk1213/Voron0_Hinged_Top_Hat/Images/Assembly/step5.png]
 
next attach the 2 80mm extrusions up against the top hinge piece

# Step 6 
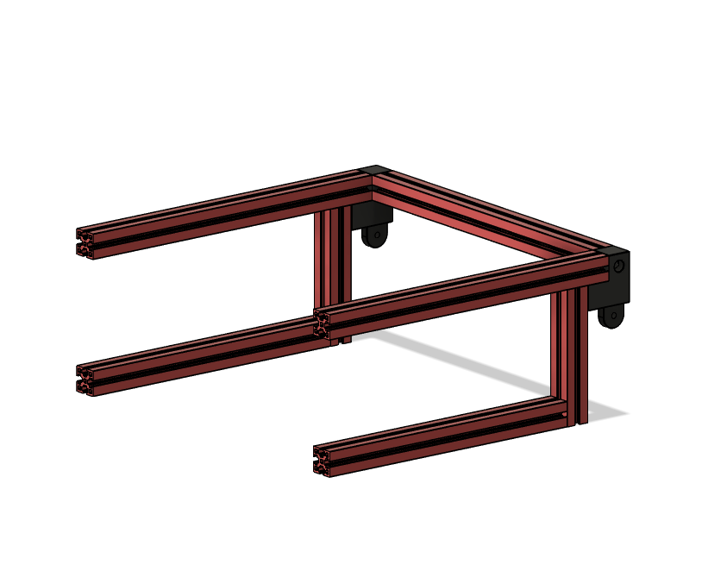
[picture p176: printer_mods/hartk1213/Voron0_Hinged_Top_Hat/Images/Assembly/step6.png]
 
these are the 170mm extrusions that go up against the 80mm extruisons

# Step 7
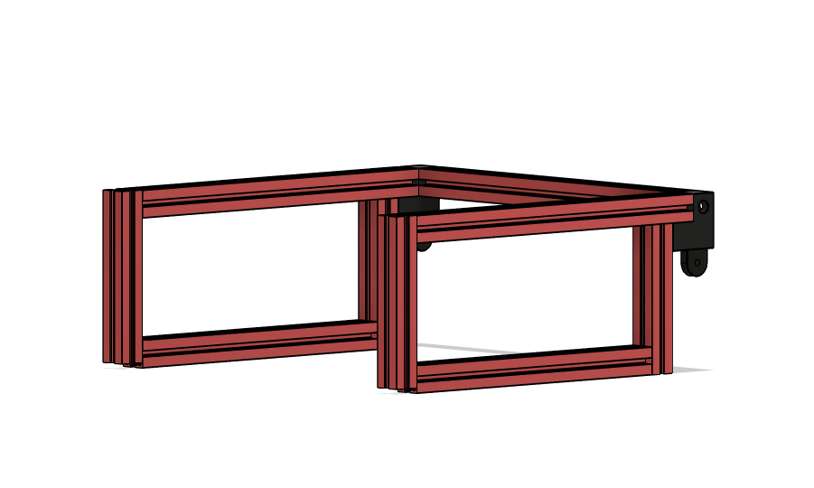
[picture p177: printer_mods/hartk1213/Voron0_Hinged_Top_Hat/Images/Assembly/step7.png]
 
now add the 92mm extrusions to the front of the frame, now these are 92mm long but the gap between the top and bottom extrusion is 95mm, you want the top of the extrusion to be flush and leave a little gap in the bottom of them which is for the alignment pins

# Step 8
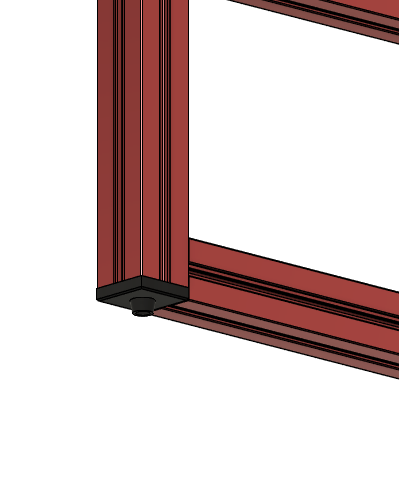
[picture p178: printer_mods/hartk1213/Voron0_Hinged_Top_Hat/Images/Assembly/step8.png]
  these are the alignment pins 
 
# Step 9 
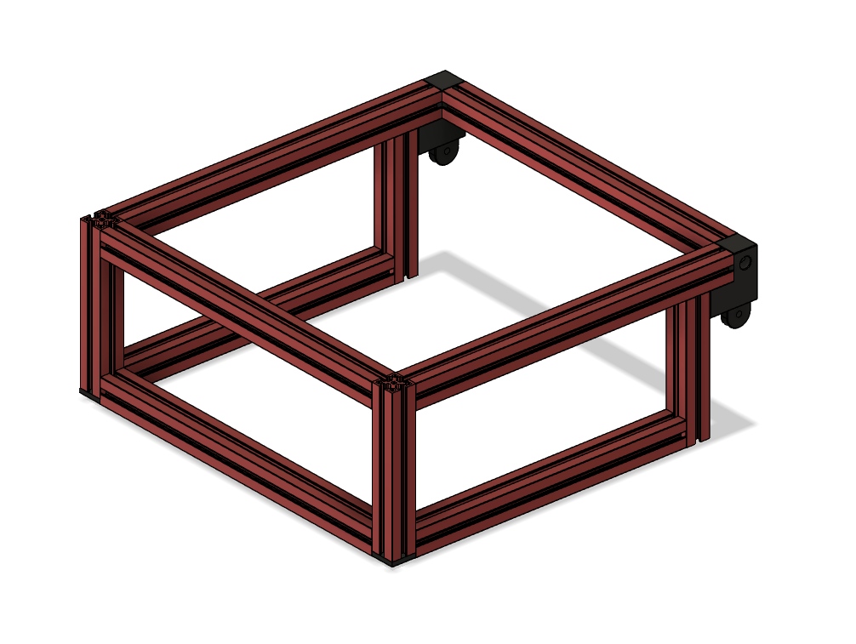
[picture p179: printer_mods/hartk1213/Voron0_Hinged_Top_Hat/Images/Assembly/step9.png]
 attach the front top and bottom extrusion
 
 # Step 10
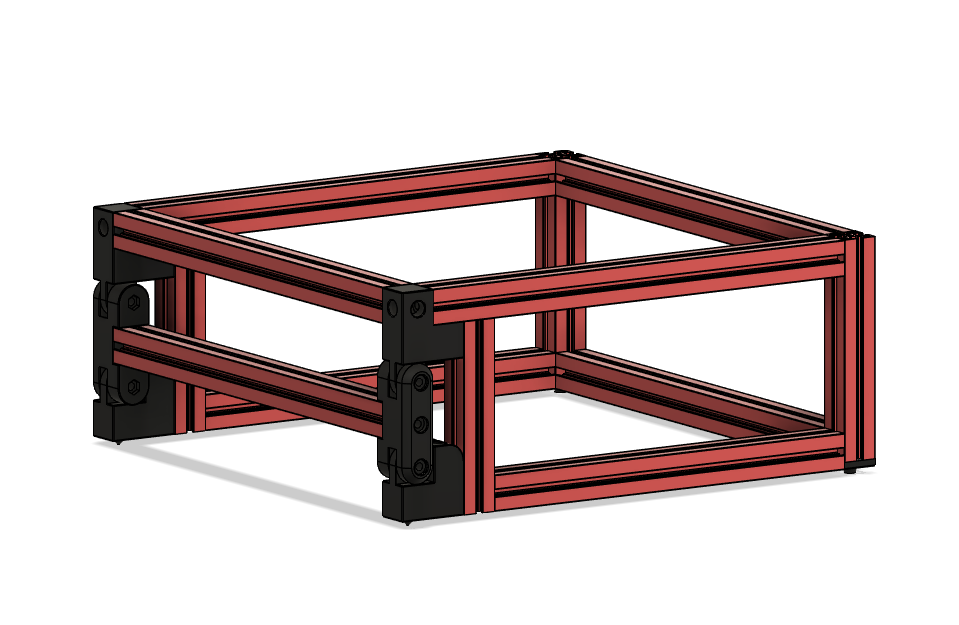
[picture p180: printer_mods/hartk1213/Voron0_Hinged_Top_Hat/Images/Assembly/step10.png]
   next step is to attach the bottom hinge and top hinge together using the middle hinge assembly you made in step 2
  
  # final step
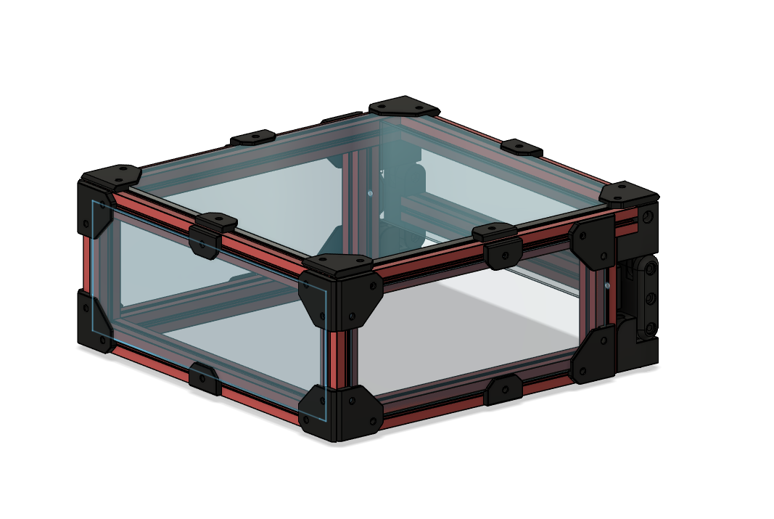
[picture p181: printer_mods/hartk1213/Voron0_Hinged_Top_Hat/Images/Assembly/FinalAssembly.png]
   
  Add the panels to the top hat 

bottom hinge uses m3x12 to attach to the frame using an m3 nut that needs to be slid into the top extrusion
top hing which also uses an m3x12 and m3 nut in 1 of the 3 holes to attach it the other 2 are m3x8
the middle hinge (middle screw) is an m3x16
the middle hinge (2 outer screws are m3x20)
other than those the rest are going to be m3x8

i hope the pictures help with assembly they are named in the correct order to assemble it 

when it comes to drilling the holes in the extrusions to screw them together, there is a [drilling guide stl](STL/TopHat_hole_Drilling_Guide_x1.stl) in the stl folder and it has 3 holes, the one closest to the end is for the 92mm extrusions on the bottom of them, the same end that the alignment pin stl gets screws on. 
the middle hole in the driling guide is just a standard 7.5mm from the edge to make normal blind joints you did with the v0 and the highest hole is to attach the 80mm extrusion to the 170mm extrusion (you drill the hole in 170mm extrusion)

i found it easier to assemble it from the back of the top hat forward. if you open the step file you can see how it assembles. i have tested this quite a bit and so far its been working great! please feel free to make any modifications to it as you see fit

this is my biggest project ive ever taken on in fusion 360 and it was a lot of fun learning the ins and outs of it

i hope you enjoy it 

-hartk1213 V0.108

##### Pictures
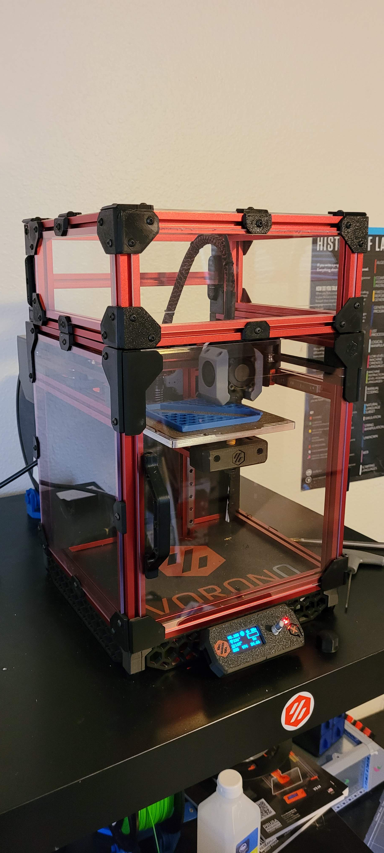
[picture p182: printer_mods/hartk1213/Voron0_Hinged_Top_Hat/Images/1.jpg]
v0_TopHat_1

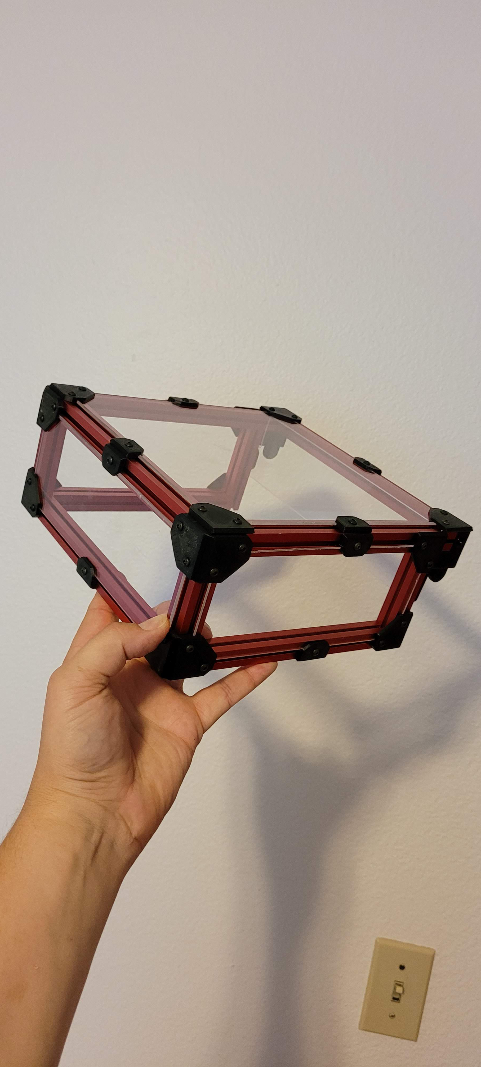
[picture p183: printer_mods/hartk1213/Voron0_Hinged_Top_Hat/Images/2.jpg]
v0_TopHat_2

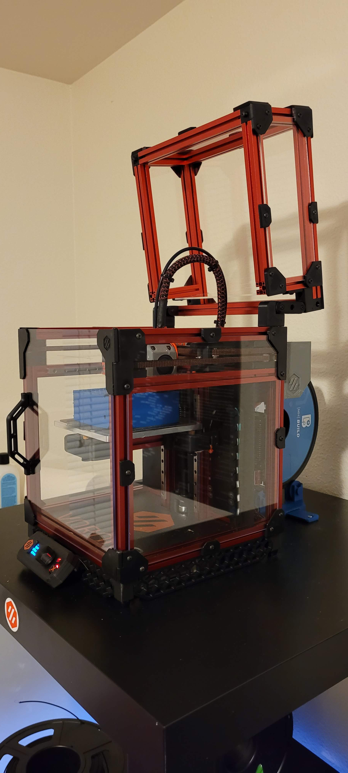
[picture p184: printer_mods/hartk1213/Voron0_Hinged_Top_Hat/Images/3.jpg]
v0_TopHat_3

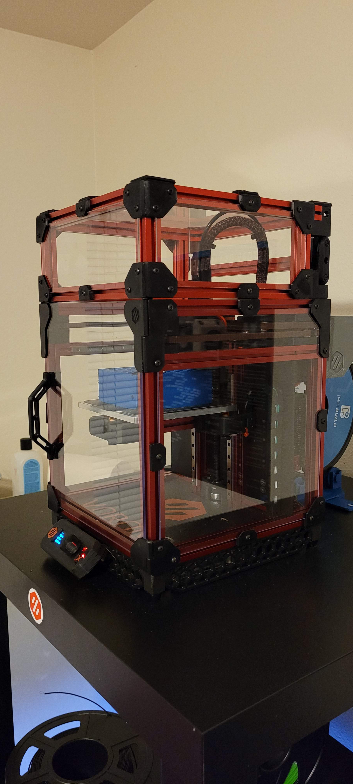
[picture p185: printer_mods/hartk1213/Voron0_Hinged_Top_Hat/Images/4.jpg]
v0_TopHat_4
