christophmuellerorg/VoronUsers/printer_mods/hijax_pl/ender_compatible_controller_mount/README.md

# README

### Overview

This is a mount for Creality Ender compatible controllers together with 40x40x10 fan to cool stepper drivers.
Selection of compatible boards includes:
- Creality v1.1.5 (TMC2208)
- TH3D EZboard (TMC2208)
- SKR mini E3 v1.2 (TMC2209)
and similar

### Print parameters

as per Voron specifications:

- Layer height: 0.2
- Infill: 50% or more
- Infill type: Grid
- Perimeters: 4 or more
- Top/Bottom solid layers: 5 or more
- Filament: ABS/ABS+

### BOM
- 404010 fan 12 or 24V one (check controller board supply voltage)
- 4x M3 thermal thread inserts
- 4x M3 8mm screws
- 2x M5 BHCS 8mm + T-Nuts
