christophmuellerorg/VoronUsers/printer_mods/madros/V0_skirt_OLED/Readme.md

--------------------------------------------------------------------------------
V0 | 0.96" OLED
--------------------------------------------------------------------------------
<p align="center">
  V0 skirt
</p>

Use an 0.96" OLED for displaying:
- hotend temperature
- heater temperature
- fan
- flow
- time (ellapsed|remaining)
- coordinates x|y|z

--------------------------------------------------------------------------------
Wiring
--------------------------------------------------------------------------------
used OLED-display:
[0,96"OLED](https://www.aliexpress.com/item/32695790661.html?spm=a2g0s.9042311.0.0.27424c4dXvvuBS)

The display has to be qualified for 5V

<p align="center">
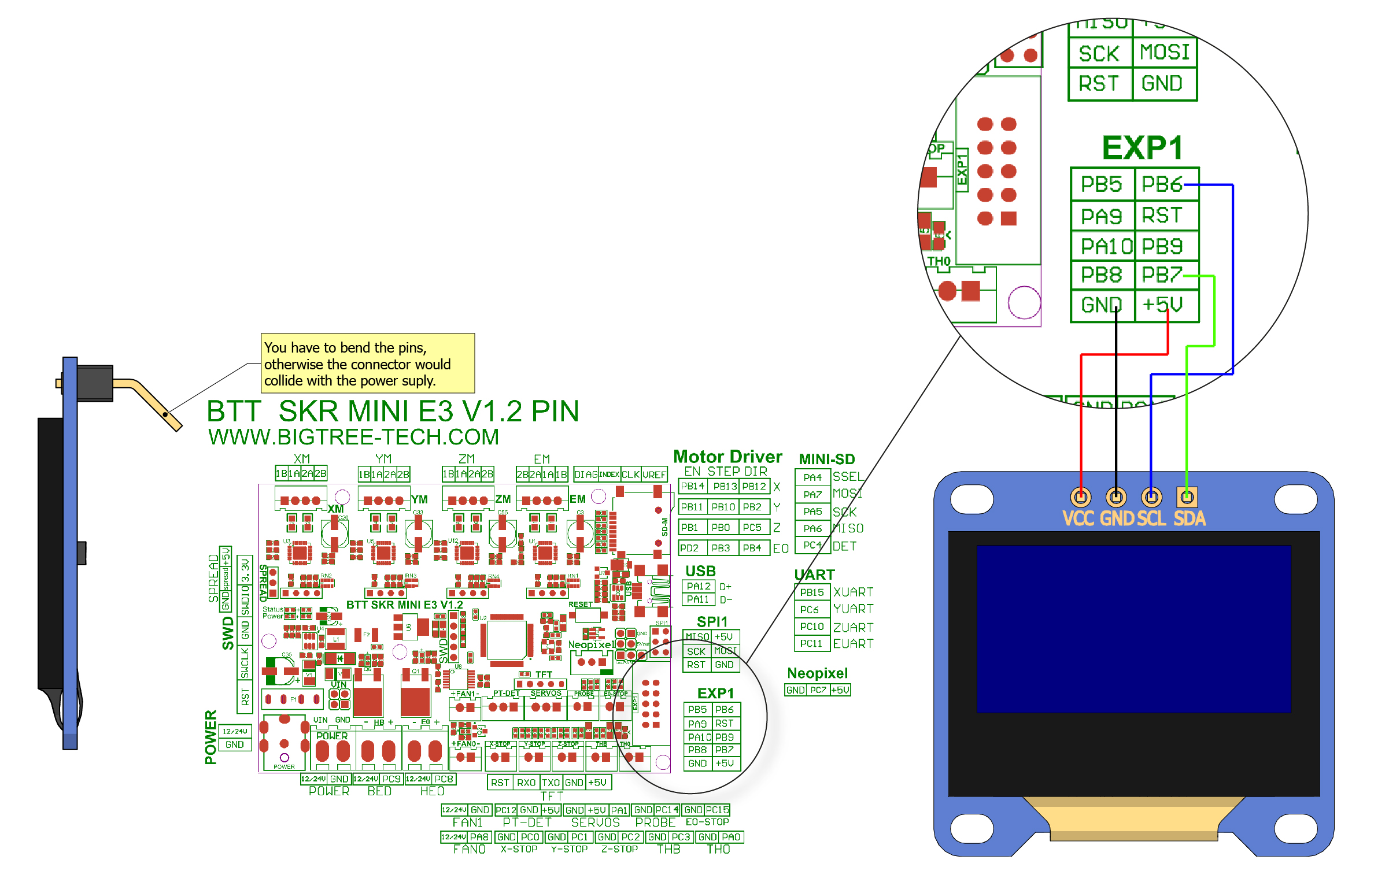
[picture p195: printer_mods/madros/V0_skirt_OLED/img/OLED.jpg]
explode plan
  
</p>

--------------------------------------------------------------------------------
Firmware
--------------------------------------------------------------------------------
For SKR mini E3 v1.2 insert in your Klipper config:
```
[display]
lcd_type: ssd1306
#If your display is not working uncomment the line below, it will define the SKR as i2c controller of the screen
#i2c_mcu = mcu
```
