christophmuellerorg/VoronUsers/printer_mods/mosher/m3_door_hinges/README.md

Door hinges mod for v2 which use m3 schrews as shafts instead of print-in-place solution

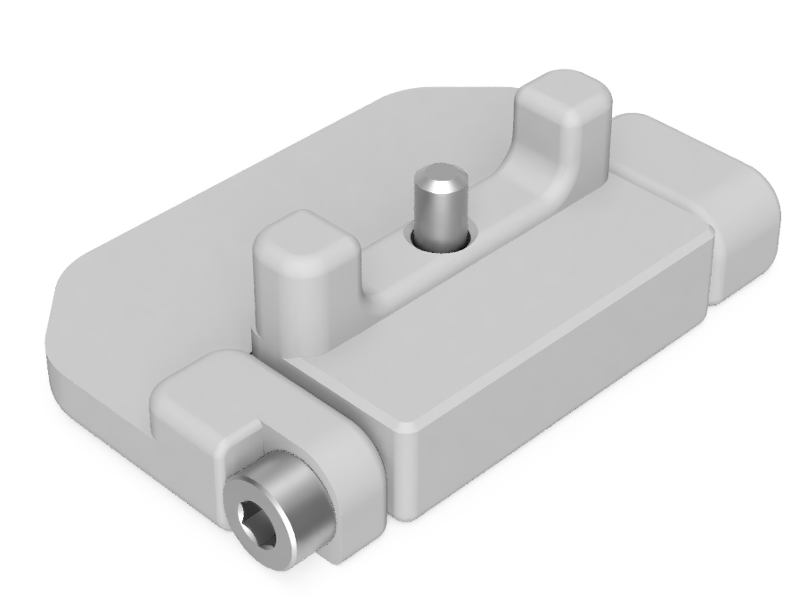
[picture p208: printer_mods/mosher/m3_door_hinges/Door Hinges mod with M3 35mm.png]
Image of Hinges
