christophmuellerorg/VoronUsers/printer_mods/natewalck/v1.8_Jigs/README.md

# Jigs for assembling V1.8
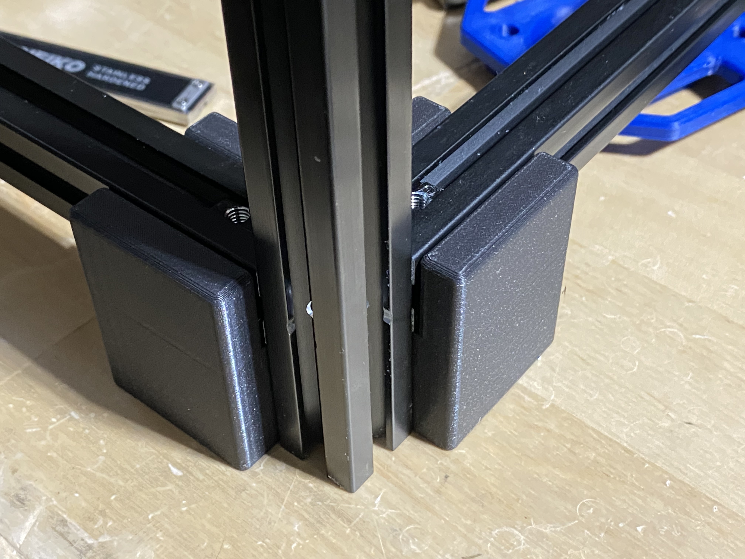
[picture p209: printer_mods/natewalck/v1.8_Jigs/images/lower_extrusion_jig.jpeg]
Lower Extrusion Jig


## Overview
These jigs are for aligning extrusions when building V1.8. This allows you to precisely align the extrusions with a minimal amount of work.

## Printing instructions
Pretty much anything works. A good starting point is 2 perimeters and 10-15% infill.

## Usage
Loosely assemble the extrustion blind joint and then place the entire blind joint onto the jig. While on an extremely flat surface, press down firmly on both horizontal extrusions and tighten the blind screws.
