christophmuellerorg/VoronUsers/printer_mods/randell/Microswitch_Endstop/README.md

# Voron 2.4 XY Microswitch Endstop for PCB
POD for use with the Microswitch endstop pcb board for X and Y axes.

Check https://github.com/VoronDesign/Voron-Hardware for the microswitch pcb.

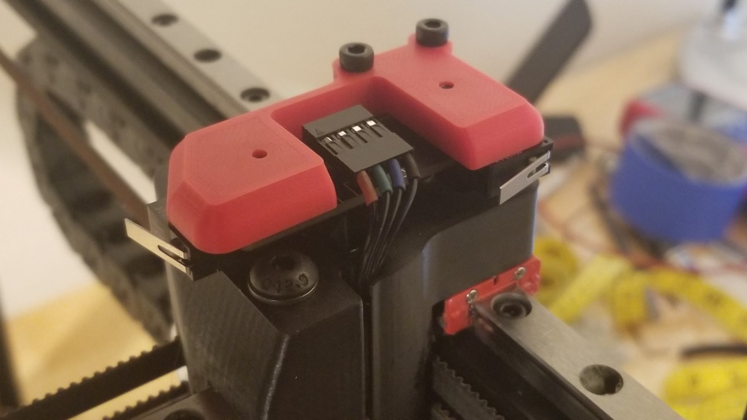
[picture p221: printer_mods/randell/Microswitch_Endstop/Images/picture2.jpg]
Installed

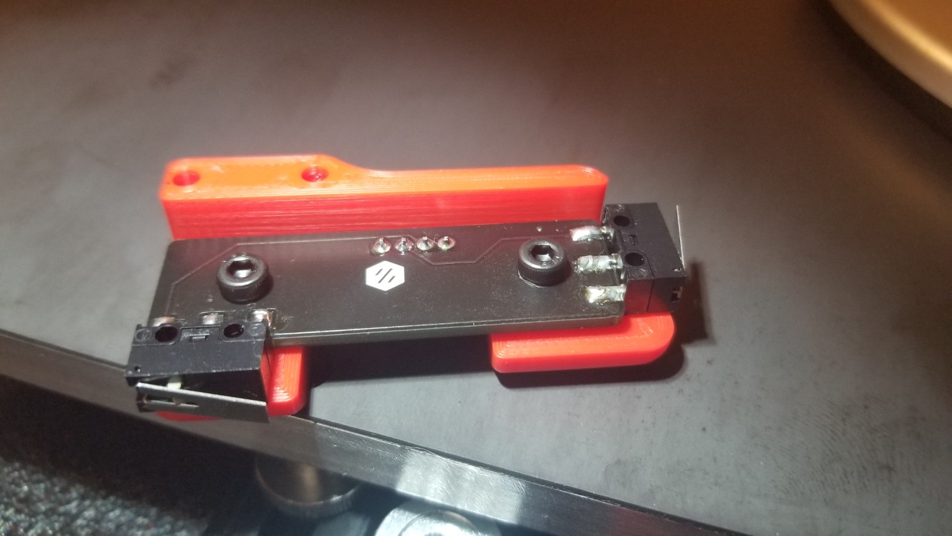
[picture p222: printer_mods/randell/Microswitch_Endstop/Images/picture1.jpg]
Mounted 1 Mounted 2

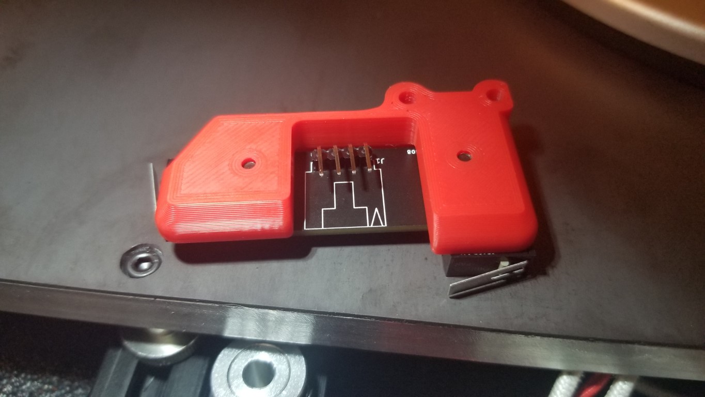
[picture p223: printer_mods/randell/Microswitch_Endstop/Images/picture3.jpg]
Mounted 2 Mounted 3
