christophmuellerorg/VoronUsers/printer_mods/tameike/DIN_Rail_2020_holder/Readme.md

Purpose:
attaching DIN RAIL with 25mm inner width to 2020 rails

Why:
You can avoid attaching DIN rails to the bed and easily move/adjust them - specially on smaller ones.

What else:
From Voron with love!
