christophmuellerorg/VoronUsers/printer_mods/xbst_/ADXL345_V0_Mount/README.md

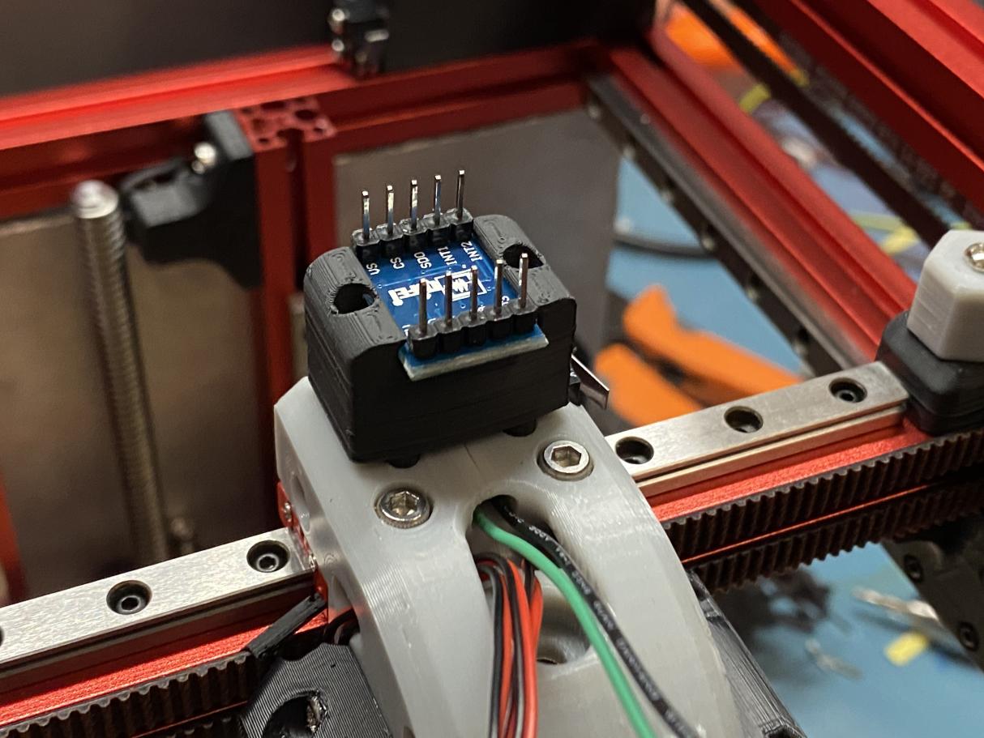
[picture p251: printer_mods/xbst_/ADXL345_V0_Mount/example.jpg]


This works for this type of ADXL345 modules: https://s.click.aliexpress.com/e/_dUndeBj

Fits snugly into the 3 M2 screw holes for the X carriage. Module just slides in from the side. Attach the 2 pieces with M2 self tappers.
