christophmuellerorg/VoronUsers/printer_mods/xbst_/Duct_Mount/README.md

# Rear Duct Mount w/ Umbilical Support

This is to mount a 100mm/4" duct in the back for ventilation. This also supports umbilical cable, and has 3 orientations for the bowden adapter, to make the routing look cleaner. If you want to plug the other 2 holes, you can use [these](https://s.click.aliexpress.com/e/_dUdajiC).
