christophmuellerorg/VoronUsers/printer_mods/xbst_/Flat_Skirts/README.md

# Flat V2.4 Skirts
This is to mount a flat bottom panel without cutouts. Includes rear filtered inlet and side middle skirts. No front skirt as that is on a hinge anyway. Inlet skirt uses M3 inserts.
