christophmuellerorg/VoronUsers/printer_mods/xbst_/Hat_LED_Mount/README.md

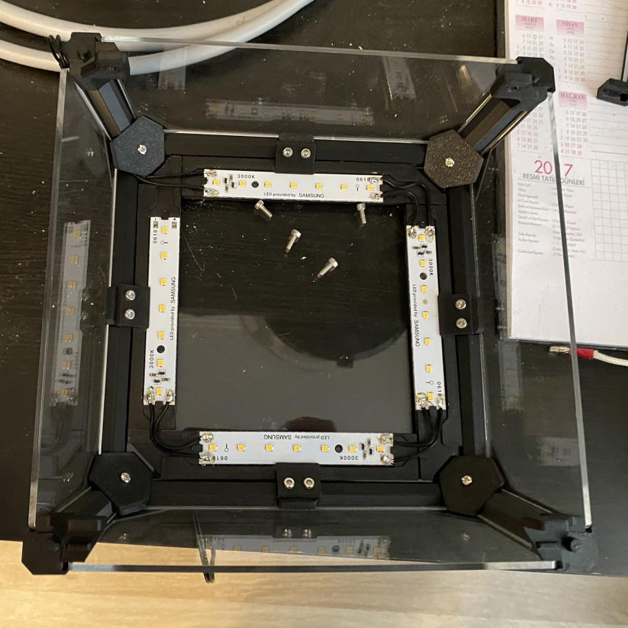
[picture p254: printer_mods/xbst_/Hat_LED_Mount/example.jpg]


This mounts to the top hat. You need to print 4x of them. Fits on a v0 bed with creative angles.

LED Module Example (TR only, try to find similar): https://www.iled.com/urun/3000k-2835-smd-samsung-led-bar-ic-mekan-35-led-24v-50cm
