christophmuellerorg/VoronUsers/printer_mods/xbst_/HOYMK_SSR_Mount/README.md

# HOYMK SSR Mount
This is to mount a [Chinese HOYMK SSR](https://s.click.aliexpress.com/e/_dZXu2E8) to a Voron 0. Please don't use this on a larger build! This is a Chinese product, it may not handle power needs of larger builds even if they claim that it does.
