christophmuellerorg/VoronUsers/printer_mods/xbst_/Relay_DIN_Mount/README.md

This is for mounting a Raspberry Pi 4 Relay Module to the DIN rails. You will also need the "pcb_din_clip_x3.stl" file included in the STL files for V2.4 (and V1.8, name may be different)
