christophmuellerorg/VoronUsers/printer_mods/xbst_/V2.4_Fanless_Middle_Skirt/README.md

A replacement middle skirt that doesn't protrude below the bottom plate, and has no fan mounts.
