christophmuellerorg/VoronUsers/printer_mods/Nomsplease/V0_Mods/led_mounts/README.md

Simple LED mounts to run along the top of the V0 frame.

12mm mounts are sized for a 12mm wide LED strip. This was used for a small strip of RGBW LEDs.
10mm mounts are sized for neo pixels strands. One has a channel so that the data pin can be routed to the other side.

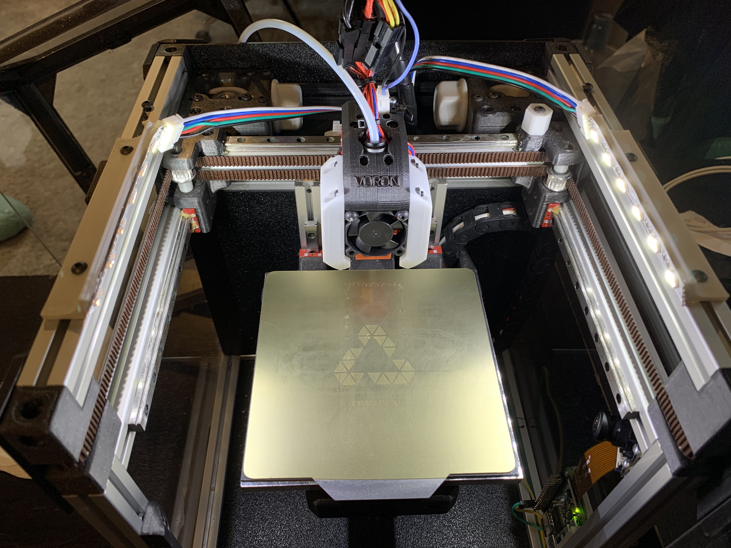
[picture p260: printer_mods/Nomsplease/V0_Mods/led_mounts/Images/lighting.jpg]
