christophmuellerorg/VoronUsers/printer_mods/Nomsplease/V0_Mods/pi_zero_camera_mount/README.md

A mount to stuff a pi cam into the corner of the V0 frame Pi zero can be mounted below the camera with the Pi Zero mount.
