christophmuellerorg/VoronUsers/printer_mods/Nomsplease/V0_Mods/pocket_watch_rear_relocation/README.md

New mount to relocate pocketwatch to the rear of the printer. this is mainly used to make room for a duet wifi on the back of the printer.

Note: You will need to find a new route for the Bowden tube, such a hole in the rear top hat panel.
