christophmuellerorg/VoronUsers/legacy_printers/printer_mods/README.md

# Legacy Mods

Printer mods for legacy Voron 3D printers
Remember to update this README when uploading new mod!

## Table structure

Update the following table with the information about your mod:
- Your name
- A link to your sub-folder
- A short description of your mod
- The printer compatibility. Use `:heavy_check_mark:` for :heavy_check_mark:,`:x:` for :x: and `:grey_question:` for :grey_question:

like so:
`
| Creator | [Mod title](link) | Description | :x: | :x: | :x: |`

---

| Creator | Mod title | Description | V1.6 | V2.1 | V2.2 |
| --- | --- | --- | --- | --- | --- |
| 3D_Black | [Fan Covers](./3D_Black) | Different fan covers for 40mm fans | :heavy_check_mark: | :heavy_check_mark: | :heavy_check_mark: |
| agsolino | [RunOut Filament Holder](./agsolino/RunOutFilamentHolder) | Holder for TriangleLab Runout sensor | :grey_question: | :grey_question: | :heavy_check_mark: |
| | [RS-25-5 Rotated](./agsolino/RS25-5-Rotated) | RS-25-5 PSU mount rotated 90 Degrees | :grey_question: | :grey_question: | :heavy_check_mark: |
|Andreq | [Mobius Shaft Jig](./andreq/voron2)|Tool used for grinding flats on a shaft at specific places |:heavy_check_mark: |:heavy_check_mark: |:heavy_check_mark: |
|Armstr0ng |[Led extrusions mount](./Armstr0ng) | A mount for aluminium LED extrusions with hidden fasteners  | :grey_question:|:heavy_check_mark: | :heavy_check_mark:|
| ArmyAg08|[Logitech Camera Mounts](./ArmyAg08/Logitech_C270_Mounts) |Different Logitech camera mounts, attached to the extrusions. Fits C270 and C310 |:heavy_check_mark: |:heavy_check_mark: |:heavy_check_mark: |
| | [Corner Panel Clip](./ArmyAg08/Panels)|Corner panel clip that fit 3mm or 1/8" panels with foam tape | :x:|:heavy_check_mark: | :heavy_check_mark:|
| Badnoob  |[Serial Plate](./Badnoob/Serial_Plate) |Modified skirt piece to display your serial number|:x:|:x:|:heavy_check_mark:|
| bryansj | [Rotated Pi Mount with Heatsink](./bryansj/RPi_Frame_with_Heatsink_90deg) | Raspberry Pi with Heatsink Frame for minimal channel width | :heavy_check_mark: | :heavy_check_mark: | :heavy_check_mark: |
| | [Keystone Jack Universal Skirt Insert](./bryansj/Keystone_Jack_Universal_Skirt_Insert) | Keystone Jack Insert to fit into any hexagonal hole in the skirt | :heavy_check_mark: | :heavy_check_mark: | :heavy_check_mark: |
| | [Befenybay Chain Anchors](./bryansj/Befenybay_Chain_Anchors) | Befenybay 10x11 Drag Chain Top Anchor and 2020 Extrusion Mount | :x: | :heavy_check_mark: | :heavy_check_mark: |
| blamm | [Blind Joint Drilling Jigs](./blamm/jigs) | Jigs to drill your blind joints in the right spot | :heavy_check_mark: | :heavy_check_mark: | :heavy_check_mark: |
| | [HEPA Filter Housing](./blamm/hepa_filter) | HEPA Filter Housing for cheap Roomba filters | :heavy_check_mark: | :heavy_check_mark: | :heavy_check_mark: |
| | [Relay module bracket](./blamm/relay_bracket) | Relay module (4 channel) mount | :heavy_check_mark: | :heavy_check_mark: | :heavy_check_mark: |
| cadriel | [Triangle Lab Filament Sensor Mount](./cadriel/triangle_lab_filament_sensor_mount) | Triange Lab filament sensor mounts | :grey_question: | :grey_question: | :heavy_check_mark: |
| Cerulean | [Respooler](./Cerulean/Respooler) | Respool tangled spools or bad koils | :heavy_check_mark: | :heavy_check_mark: | :heavy_check_mark: |
| chilicoke | [Low Profile Exhaust Duct](./chilicoke/Low_profile_exhaust_duct_adapter) | Quick-release exhaust duct adapter that requires minumal rear spacing  | :grey_question: | :heavy_check_mark: | :heavy_check_mark: |
| christophmuellerorg | [Duet Maestro mount for Voron 2.2](./christophmuellerorg/duet_maestro_frame_mount_skirt) |Duet Maestro mount for V2.2 | :x: | :grey_question: | :heavy_check_mark: |
|  | [FYSETC Panel Due 5i](./christophmuellerorg/fysetc_panel_due_5_integrated_voron2.2_display_holder) |Standard LCD compatible holder for the FYSETC integrated panel due | :x: | :grey_question: | :heavy_check_mark: |
|  | [Mains plug panel for the RND_165-00057](./christophmuellerorg/mains_plug_panel_for_RND_165-00057) | Mains plug panel for the RND_165-00057 Filter/Switch combination| :x: | :grey_question: | :heavy_check_mark: |
|Danowar |[Dual Mobius Mount](./Danowar/Dual_Mobuis_Mount) | Mounts two Mobius Extruders to the back of the printer| :heavy_check_mark:| :heavy_check_mark:|:heavy_check_mark: |
| |[F6 Board Mount](./Danowar/F6_Board_Mount) | Mounts for FYSETCS F6 controller boards|:heavy_check_mark: | :heavy_check_mark:| :heavy_check_mark:|
| |[Humidity Sensor Bracket](./Danowar/Humidity_Sensor_Bracket) |Mount for Humidity/Temperature sensor |:heavy_check_mark: |:heavy_check_mark: | :heavy_check_mark:|
| |[Load Cell Spool Holder](./Danowar/Load_Cell_Spool_Holder)| Spool holder with built in weight scale|:x: |:heavy_check_mark: |:heavy_check_mark: |
| |[TL 2-to-1 Mosquito Toolhead Adapter](./Danowar/TL_2-to-1_Mosquito_Toolhead_Adapter)| Mounts the Triangle Labs 2-to-1 adapter directly to the mosquito toolhead|:heavy_check_mark: |:heavy_check_mark: |:heavy_check_mark: |
| |[Tablet mount](./Danowar/Tablet_Mount)|Detachable mount for tablet using magnets |:heavy_check_mark:  |:heavy_check_mark:  | :heavy_check_mark: |
| |[V2.2 Wrench](./Danowar/V2.2_Wrench)|3 sided wrench for 2.2 bearing caps and panel clips |:x:  |:x:  | :heavy_check_mark: |
| |[Alternative Z Chain](./Danowar/AltZChain)|Alternative mounting for Z-Axis zipchain|:x:  |:heavy_check_mark:  | :heavy_check_mark: |
| daveidmx| [30mm Fan Adapter](./daveidmx/VORON2)|30mm Fan Adapter | :grey_question:| :grey_question:|:grey_question: |
|Dunar |[Panel Rest](./Dunar/Panel_Rest) | External panel holder | :heavy_check_mark: |:heavy_check_mark:  |:heavy_check_mark:  |
|etherwalker |[Pi Zero Camera Mount](./etherwalker/Pi_Zero_Camera_Mount) | Pi Zero Camera Mount| :grey_question:| :grey_question:|:grey_question: |
|exquyre |[Anet 12864 Display](./exquyre/Anet_12864_display) | Case for Anet 12864 LCD display|:heavy_check_mark: | :heavy_check_mark:|:heavy_check_mark: |
| |[LED Bar Mount](./exquyre/LED_bar_mount) |Mount for 12V LED bars to the top extrusions |:grey_question: | :heavy_check_mark:|:heavy_check_mark: |
| |[Cable Cover Insert](./exquyre/cable_cover) |Room for 3-4 20AWG wires | :grey_question:| :grey_question:|:grey_question: |
| |[Einsy + RAMPS Combo](./exquyre/einsy+ramps) |Mounting bracket for 1 Einsy and 1 RAMPs |:heavy_check_mark: | :heavy_check_mark:|:heavy_check_mark: |
|FHeilmann |[Voron 2.1 5mm Parts](./FHeilmann/VORON2.1_5mm_parts) |Parts modified for extrusions with 5mm gap. |:x: |:heavy_check_mark: | :x:|
| Fulg| [PanelDue5 LCD Mount](./Fulg/VORON2/PanelDue5)|Mount for the PanelDue5 LCD display |:heavy_check_mark: | :heavy_check_mark:|:heavy_check_mark: |
|GSL12 |[WAGO 221 Mounts](./GSL12/wago_221_mount) | Wago 221 mounts for the electronics bay |:heavy_check_mark: |:heavy_check_mark: | :heavy_check_mark:|
|Gamsche | [Keystone Skirt Panel](./Gamsche/skirt_keystone)| 25mm skirt panel with integrated keystone jack.  Use with 50mm smaller adjacent skirts for proper fit. |:grey_question: |:grey_question: |:heavy_check_mark:|
|Glowtape | [MKS GenL 1.0 Mounting Bracket](./Glowtape)| MKS GenL 1.0 Mounting Bracket|:heavy_check_mark: |:heavy_check_mark: |:heavy_check_mark:|
|GustavTheMighty | [4.3 PanelDue Case](./GustavtheMighty/4.3-Paneldue_Case)|Case/mount for the 4.3 PanelDue LCD Display  |:heavy_check_mark:  | :heavy_check_mark: |:heavy_check_mark:  |
|Iakabos| [Mini12864 Display Mount](./Iakabos/Mini12864_display_mount)|Case and mounting arms for a Fysetc Mini12864 display |:grey_question: |:heavy_check_mark: |:heavy_check_mark: |
| Hackdoggo| [BMGobius](./hackdoggo/v2/bmgobius)|Modification to MZBot's Mobius Extruder to use dual drive Bondtech drivegears |:heavy_check_mark:  | :heavy_check_mark: | :heavy_check_mark: |
|hiemmer | [Tool Holders](./hiemmer/Tool_Holders)| Tool holder for calipers, screwdriver etc| :grey_question:| :grey_question:|:grey_question: |
|JaredC01 | [Mini 12864 Voron Knob](./JaredC01/Mini_12864_Voron_Knob) | Upgraded knob for Fystec Mini 12864 RGB LED Display | :heavy_check_mark: | :heavy_check_mark: | :heavy_check_mark: |
| | [Keystone Power Panel](./JaredC01/Keystone_Power_Panel)| Power Panel with 1 or 2 Keystone Jacks | :x: | :heavy_check_mark: | :heavy_check_mark: |
| | [Mosfet Mounts](./JaredC01/Mosfet_Mounts)| Mosfet Mount for 4 or 6 Mosfets | :heavy_check_mark: | :heavy_check_mark: | :heavy_check_mark: |
| Jasperkm | [5mm panel mounting](./Jasperkm/5mm_panel_mounting)| Edited panel clips for 4mm panel + 1mm foam tape| :x: | :heavy_check_mark: | :heavy_check_mark: |
| | [Brush holder](./Jasperkm/Brush_holder)| Brush holder next to printbed | :x: | :heavy_check_mark: | :heavy_check_mark: |
| | [Cable management](./Jasperkm/Cable_management)| Cable trunking and 2020 slot cover | :x: | :heavy_check_mark: | :heavy_check_mark: |
| | [Exhaust fan guard](./Jasperkm/Exhaust_fan_guard)| VORON styled fan guard for exhaust fan 120mm | :x: | :heavy_check_mark: | :heavy_check_mark: |
| | [Fire alarm mount](./Jasperkm/Fire_alarm_mount)| Mount for a small fire alarm on the back of the printer | :heavy_check_mark: | :heavy_check_mark: | :heavy_check_mark: |
| | [LED strip holder](./Jasperkm/LED_strip_holder)| Mount for led strips at an angle at the top of the printer | :heavy_check_mark: | :heavy_check_mark: | :heavy_check_mark: |
| | [Panel key wrench](./Jasperkm/Panel_key_wrench)| Wrench for panel keys for ease of turning | :x: | :heavy_check_mark: | :heavy_check_mark: |
| | [Simple tool holder](./Jasperkm/Simple_tool_holder)| Holder for 3 small tools using magnets | :heavy_check_mark: | :heavy_check_mark: | :heavy_check_mark: |
| | [Skirt mods](./Jasperkm/Skirt_mods)| Some mods the skirts for fans and a clock | :x: | :heavy_check_mark: | :heavy_check_mark: |
|Jass_on |[Tempered glass clips/handle](./Jass_on/Voron_2.1.1_Tempered_Glass) |Panel clips and handles for using tempered glass side panels | :x: | :heavy_check_mark: | :grey_question:|
| | [Rear panel clips](./Jass_on) | Rear Panel Clips| :x: | :heavy_check_mark: | :grey_question:|
| | [SKR 1.3 Cooling bracket](./Jass_on)|SKR 1.3 mount with built in 40mm fan mount |:heavy_check_mark:  | :heavy_check_mark: | :heavy_check_mark: |
|JeJeff |[2020 Extrusion slot cover](./JeJeff/VORON2.1/2020_5mm_Slot_Cover) |Slot covers for extrusions with 5mm slot width |:heavy_check_mark:  | :heavy_check_mark: | :heavy_check_mark: |
| |[Cable Tie Mount](./JeJeff/VORON2.1/Cable_Tie_Mount) |Cable tie mounts for 4mm cable ties |:heavy_check_mark:  | :heavy_check_mark: | :heavy_check_mark: |
| |[Main Plug Panel](./JeJeff/VORON2.1/Mains_Plug_Panel_with_RJ45_Panel_Mount) |Main Plug Panel modified to hold a RJ45 ethernet socket |:heavy_check_mark:  | :heavy_check_mark: | :heavy_check_mark: |
|Jink |[Coroplast mount](./Jink/VORON_2.1/Coroplast_Mount) |Mount / Bracket supporting the coroplast sheets | :x: | :heavy_check_mark: | :grey_question: |
| | [Filament runout sensor mount](./Jink/VORON_2.1/Filament_Runout_Sensor_Mount)|Filament runout sensor mount |:x:  | :heavy_check_mark: | :grey_question: |
| |[Left handed RAMPS mount](./Jink/VORON_2.1/Left_Handed_Ramps_Mount) | Mirrored RAMPS bracket|:heavy_check_mark:  | :heavy_check_mark: | :heavy_check_mark: |
| | [Spool holder with scale](./Jink/VORON_2.1/Spool_Holder_With_Scale)|Spool holder with scale | :x: | :heavy_check_mark: | :grey_question: |
| |[WAGO Mount](./Jink/VORON_2.1/WAGO_Mount) |Mount for 3x WAGO connectors |:heavy_check_mark: | :heavy_check_mark:| :heavy_check_mark:|
| JustinVoelker|[Mains Plug Panel with RJ45](./JustinVoelker/VORON2) | Mains plug panel with ethernet cutout|:heavy_check_mark: |:heavy_check_mark: |:heavy_check_mark: |
| K1JWG|[PanelDue 7i Custom Logo](./K1JWG/PanelDue7iLogo) |Custom Voron 2 logo for use as a PanelDue 7i startup splash screen |:heavy_check_mark: | :heavy_check_mark:|:heavy_check_mark: |
|Koios |[Front Panel Locks](./Koios/6mm_Glass) |Front panel locks for 6mm tempered glass panels | :x: | :heavy_check_mark: | :grey_question:|
| |[Logitech C920 Mount](./Koios) |Mount for C920 secured to the top front extrusion |:grey_question: |:heavy_check_mark: | :heavy_check_mark:|
| |[LED Mounts](./Koios) |Different mounts for LED light bars |:grey_question: |:heavy_check_mark: | :heavy_check_mark:|
|manfre |[Openbuild chain ends](./manfre/cable_chains) |Cable chain ends to use off the shelf chains with Voron parts |:x: |:heavy_check_mark: |:heavy_check_mark: |
|masgar |[VoltAmpMeter panel insert](./masgar/VoltAmpMeter_Panel_Insert) | Mounting panel for VoltAmpMeter | :heavy_check_mark: |:x: |:x: |
| |[BTT SKR Mini v1.1 mounting frame](./masgar/BTT_SKR_Mini_v1.1_mounting_frame) | Mounting frame for BigTreeTech SKR Mini v1.1 | :heavy_check_mark: |:heavy_check_mark: |:heavy_check_mark: |
| |[2-in-1 hotend housing](./masgar/2-in-1_hotend_housing) | Front/Rear toolhead housing for XCR3D/BTT/BIQU 2-in-1 hotend | :heavy_check_mark: |:heavy_check_mark: |:heavy_check_mark: |
|meteyou |[Gcode Buttons](./meteyou/gcode_buttons) |Buttons in the skirt to execute gcode |:grey_question: |:heavy_check_mark: |:heavy_check_mark: |
|mildw4ve |[Beltchain Remake](./mildw4ve/Beltchain_Remake) |Beltchain Remake for Voron 2.2| :x: | :x: | :heavy_check_mark:|
| |[IR Probe Mount](./mildw4ve/IR_Probe_Mount_V2.2) |DUET IR Probe Mount| :x: | :x: | :heavy_check_mark:|
|Nashuar |[IKEA LEDBERG Spot Mount](./Nashuar/LEDBERG_LED_Mount) |LED Spot mount for IKEA LEDBERG |:grey_question: |:heavy_check_mark: |:heavy_check_mark: |
| |[WaveShare 7" Screen Mount](./Nashuar/7.0-WaveShare_Screen) |Display Case for 7" Waveshare LCD |:grey_question: |:grey_question: |:heavy_check_mark: |
|nemgrea |[Magnetic Split Front Door](./nemgrea/magnetic_split_front_door) |Hinges, handles and magnet mounts for creating a split front door panel |:x: |:heavy_check_mark: |:grey_question: |
|OrkusMG | [Waveshare 5 Inch LCD Cover](./OrkusMG/Waveshare5inchHDMILCDscreenCover)|Display Cover for the Waveshare 5 inch HDMI LCD screen |:heavy_check_mark: |:heavy_check_mark: | :heavy_check_mark:|
|PhilLeMint | [c920 Mount](./PhilLeMint/c920_Mount/) | c920 Camera Mount | :grey_question: | :heavy_check_mark: | :heavy_check_mark: |
| |[Panel Mounting](./PhilLeMint/Panel_Mounting/) | Panel Clips for 3/32" Foam Tape |:grey_question: | :heavy_check_mark: |:heavy_check_mark: |
| |[Dual LED Light Mount](./PhilLeMint/Dual_LED_Light_Mount/) | Mounts for Dual LED Bar |:grey_question: | :heavy_check_mark: |:heavy_check_mark: |
| |[Velocity Stack](./PhilLeMint/Velocity_Stack/) | Velocity Stack Fan Cover |:grey_question: | :heavy_check_mark: |:heavy_check_mark: |
| |[Indicator Mount](./PhilLeMint/Indicator_Mount/) | Mount for Indicator |:grey_question: | :heavy_check_mark: |:heavy_check_mark: |
|pnokel |[Cable Zipper](./pnokel) |Small mount to secure wires with zip ties |:heavy_check_mark: | :heavy_check_mark:|:heavy_check_mark: |
| |[Coroplast holders](./pnokel) | Different coroplast holders for added support |:x:| :heavy_check_mark:|:grey_question: |
| |[Toothed Idler](./pnokel) |14.5mm toothed idler | :x: | :x: |:x:|
| przybybr|[V2.1 Omron Mount](./przybybr/V2_1OmronMount/) | Mount for Omron probe in V2.1 | :grey_question:|:heavy_check_mark: | :x:|
| Railgunner|[Dual Direct Drive X Carriage](./Railgunner/10mmBMGx2) |Dual direct drive using 2x Bondtech BMG | :grey_question:|:grey_question: |:grey_question: |
|Randommen96 | [LCD bracket extended](./randommen96/LCD_bracket_extended/) | LCD bracket extended for 6mm panels | :grey_question: | :grey_question: | :heavy_check_mark: |
| |[Led strip mount DIODER](./randommen96/Led_strip_mount_DIODER/) | Led strip mount for Ikea Dioder |:grey_question: | :grey_question: |:heavy_check_mark: |
| |[PSU bracket](./randommen96/PSU_bracket/) | PSU AIO bracket for 5v, 12v and 24v |:grey_question: | :grey_question: |:heavy_check_mark: |
| |[Raspi cam mount](./randommen96/Raspi_cam_mount/) | Cam mount for alie raspi cams |:grey_question: | :grey_question: |:heavy_check_mark: |
| schlank|[Turbocharger](./schlank/turbocharger) | Alternative fumes extraction solution | :x:|:heavy_check_mark: |:heavy_check_mark: |
| |[Minima](./schlank/minima) | Minimalistic Fysetc Mini12864 display mount | :x:|:grey_question:|:heavy_check_mark: |
| Seamen|[RAMPS Extender Holder](./Seamen/RAMPS-Extender_holder) |Mount for RAMPS board with the stepper extender |:heavy_check_mark: | :heavy_check_mark:|:heavy_check_mark: |
|Slidr | [Panzer Chain](./Slidr/PanzerChain) | Alternative energie chain  | :grey_question: |:grey_question: |:heavy_check_mark: |
|Sparreau | [5V Power Supply Mount](./Sparreau)|5V Power Supply Mount |:heavy_check_mark: | :heavy_check_mark:|:heavy_check_mark: |
| |[FSR Circuit Mount](./Sparreau) |Bracket for mounting the FSR PCB. |:x: |:heavy_check_mark: |:x: |
| | [Z Rail Stop](./Sparreau)|Z Rail Stop | :x: |:heavy_check_mark:| :heavy_check_mark:|
| | [Bed Extrusion Spacer](./Sparreau)|Bed Extrusion Spacer |:x: |:heavy_check_mark:| :heavy_check_mark:|
| |[Dial Indicator Fan Mount](./Sparreau) | Dial Indicator Fan Mount| :grey_question:| :grey_question:|:grey_question: |
| |[Mains Plug Panel Parametric](./Sparreau) |Scalable mains plug panel with small modifications |:heavy_check_mark:|:heavy_check_mark:|:heavy_check_mark:|
| |[Z Idler Frame Extra Tab](./Sparreau) |An extra tab added to the Z idler to prevent sagging / rotation | :x:|:heavy_check_mark: |:x: |
| sporadic | [10x15 Chain Z Mounts](./sporadic/10x15_Chain_Z_Mounts) | End Z mounts for 10x15 Befenybay Drag Chain | :grey_question: | :heavy_check_mark: | :grey_question: |
| | [30A Relay Mount](./sporadic/30A_Relay_Mount) | Mount for a 30A relay module available on Amazon | :grey_question: | :heavy_check_mark: | :heavy_check_mark: |
| | [Dual RS-25 Mount](./sporadic/Dual_RS-25_Mount) | Dual mount for side by side RS-25 supplies | :grey_question: | :heavy_check_mark: | :heavy_check_mark: |
| | [Dual SKR 1.3 Mounts](./sporadic/Dual_SKR_1.3_Mount) | Dual mounts for side by side SKR 1.3 controllers with fan and fanless options  | :grey_question: | :heavy_check_mark: | :heavy_check_mark: |
| | [Wago 221-415 Mount](./sporadic/Wago_221_Mounts) | Mount for a single Wago 221-415  | :grey_question: | :heavy_check_mark: | :heavy_check_mark: |
|Stephan |[M12 Probeholder](./Stephan/M12_probeholder) | Drop in replacement of the stock probe to a M12|:grey_question: |:heavy_check_mark: | :grey_question:|
| |[BlTouch Mount](./Stephan/bltouch_mount) | Drop in replacement of the stock probe to a BLTouch|:grey_question: |:heavy_check_mark: | :grey_question:|
|steve450 |[Corner Brackets](./steve450/Voron2.1) | Corner brackets preventing rotation of the extrusions, and stiffening the joints.  Also covers the Z-belt hole for improved aesthetics| :grey_question:| :heavy_check_mark:|:grey_question: |
| synfinatic|[Duet Fan Mount](./synfinatic/Duet-Fan-Mount) |Duet/Duex fan mount with air vents directly above the steppers to increase airflow |:heavy_check_mark: | :heavy_check_mark:|:heavy_check_mark: |
| |[E-Stop Switch](./synfinatic/E-Stop-Switch) |Mount for emergency button attached to the top of the printer |:x: | :heavy_check_mark:|:grey_question: |
| | [Filament DryBox](./synfinatic/Filament-DryBox)|Mount for filament drybox attached to the side of the printer |:x: | :heavy_check_mark:|:grey_question: |
| |[LED Mount](./synfinatic/LED-Mount) |Mount for LED lightbars |:grey_question: |:heavy_check_mark: |:heavy_check_mark: |
| | [PS Extra Bracket](./synfinatic/PS-Extra-Bracket)|Extra bracket to keep the power supply in place |:grey_question: |:grey_question: |:grey_question: |
| |[RJ45 Mount](./synfinatic/RJ45-Mount) |Mount for an ethernet coupler to extend / move the ethernet plug somewhere more convenient |:grey_question: |:grey_question: |:grey_question: |
|Trippinonaduck |[Switch Holder](./Trippinonaduck/SwitchHolder) | Holder for Anit-Vandal Switches mounted in skirt holes  | :x:|:heavy_check_mark: | :heavy_check_mark:|
| |[LRS-75-5](./Trippinonaduck/LRS_75_5) | Mount for LRS-75-5 Power Supply  | :heavy_check_mark:|:heavy_check_mark: | :heavy_check_mark:|
|warriorofwire | [Openbuilds Drag Chain 2.1](./warriorofwire/openbuilds_drag_chain_2.1)|Off-the-shelf, cheap, snap opening drag chain for gantry wiring and protecting wires down to the deck |:x: | :heavy_check_mark: | :x: |
| | [Openbuilds Drag Chain 2.2](./warriorofwire/openbuilds_drag_chain_2.2)|Off-the-shelf, cheap, snap opening drag chain for gantry wiring and protecting wires down to the deck |:x: | :x: | :heavy_check_mark: |
| | [Direct Drive BMG-m mount](./warriorofwire/bmg_direct_drive)| Open toolhead mounting plans for Bondtech BMG-m and Mosquito direct drive combo|:grey_question: |:heavy_check_mark:|:heavy_check_mark: |
| wile.e.coyote| [Coroplast Support](./wile.e.coyote)|Support for the coroplast to prevent sagging | :x: |:heavy_check_mark: |:grey_question: |
| |[Dual Buck Bracket](./wile.e.coyote) |Mounting bracket for 2 buck converters | :heavy_check_mark: |:heavy_check_mark: |:heavy_check_mark: |
| |[Nozzle Scrubber Mount](./wile.e.coyote) | Mount for brass brush. Used for cleaning nozzle before printing |:x: | :heavy_check_mark: |:heavy_check_mark: |
| | [Wago Mounts](./wile.e.coyote)  | Different mounts for Wago connectors | :heavy_check_mark: |:heavy_check_mark: |:heavy_check_mark: |
| Xile | [AfterBurner Umbilical](./XIle) | Supports a umbilical setup, on AB, taking the strain off connectors | :grey_question: | :grey_question: | :heavy_check_mark: |

---
