christophmuellerorg/VoronUsers/legacy_printers/printer_mods/masgar/README.md

### Dirtree

- voltamp_box_panel_insert: contains model for volt/amp meter to insert into front skirt
- BTT_SKR_Mini_v1.1_mounting_frame: contains model for BTT SKR Mini v1.1 mounting frame
- 2-in-1_hotend_housing: contains model of housing for 2-in-1 hotend
