christophmuellerorg/VoronUsers/legacy_printers/printer_mods/XIle/ReadMe.txt

This is used to support an umbilical setup for the Afterburner toolhead.

Bolts onto the back of the stepper using 2x M3x20 bolts. 

I utilized McMaster Continuous-Flex cable

https://www.mcmaster.com/catalog/126/911   - 8082K15
