christophmuellerorg/VoronUsers/legacy_printers/printer_mods/Nashuar/7.0-WaveShare_Screen/Readme.md

# WaveShare  7" Screen Case

This is a case for the 7" HDMI LCD (H) Screen: https://www.waveshare.com/wiki/7inch_HDMI_LCD_(H)
For mounting this screen the stock V2.2 LCD base mounts are needed: https://github.com/VoronDesign/Voron-2/tree/Voron2.2/STLs/VORON2.2/LCD_Module 

- Print-Settings:
Default Voron2 parts print settings,
no supports needed

---

~Dario made a mod of this case to fit waveshare 7" type/model C rev2.2 and alowed me to share it. I don't have this screen to test the prints, so I cannot ensure that the STLs fit. 
I renamed his files with the postfix \_c and renamed my parts for the model H screen with _h.

The case for model H has four printed parts (Back, Mid, Front and Button), the case for model C has two printed parts (Back and Front). The modded swing arms should fit both models.
