christophmuellerorg/VoronUsers/printer_mods/eddie/V1.8_12mm_Z_Mod/Images/Top_View.png

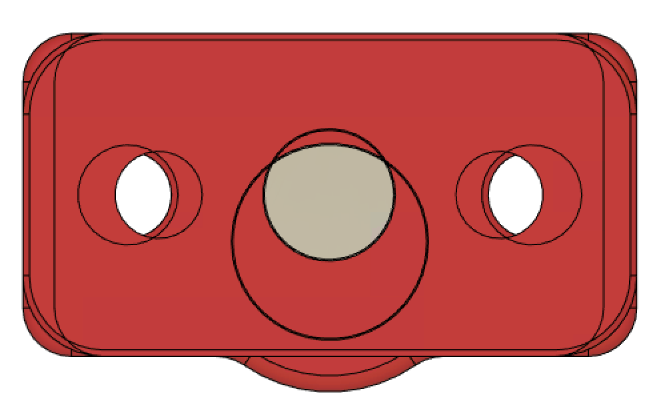
printer_mods/eddie/V1.8_12mm_Z_Mod/Images/Top_View.png
