christophmuellerorg/VoronUsers/printer_mods/hijax_pl/din_rail_mount/din_rail_mount_angle_panel.png

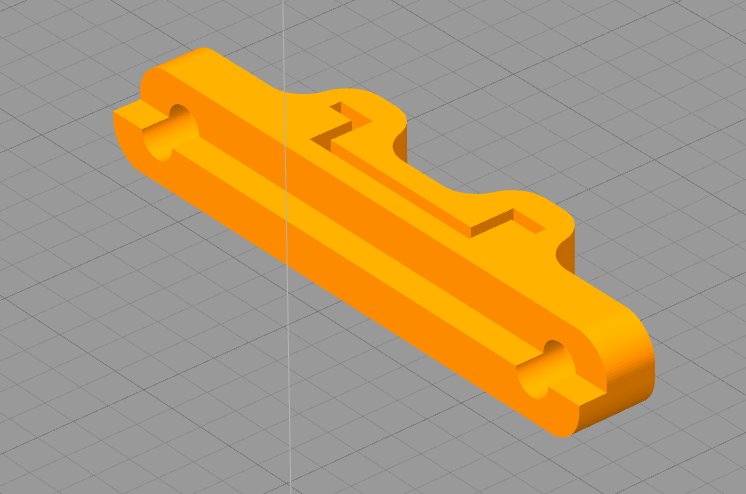
printer_mods/hijax_pl/din_rail_mount/din_rail_mount_angle_panel.png
