christophmuellerorg/VoronUsers/printer_mods/jasonc/Z_Idler_Shoulder_Bolt/cross_section.png

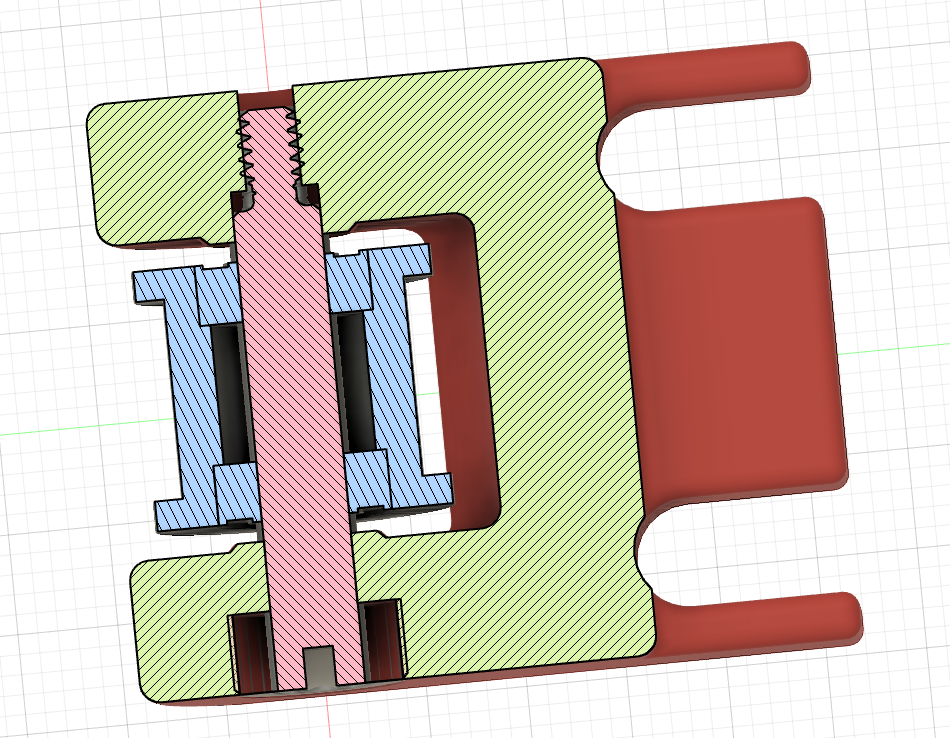
printer_mods/jasonc/Z_Idler_Shoulder_Bolt/cross_section.png
