christophmuellerorg/VoronUsers/printer_mods/jasonc/Z_Idler_Shoulder_Bolt/shoulder_bolts_and_prints.jpeg

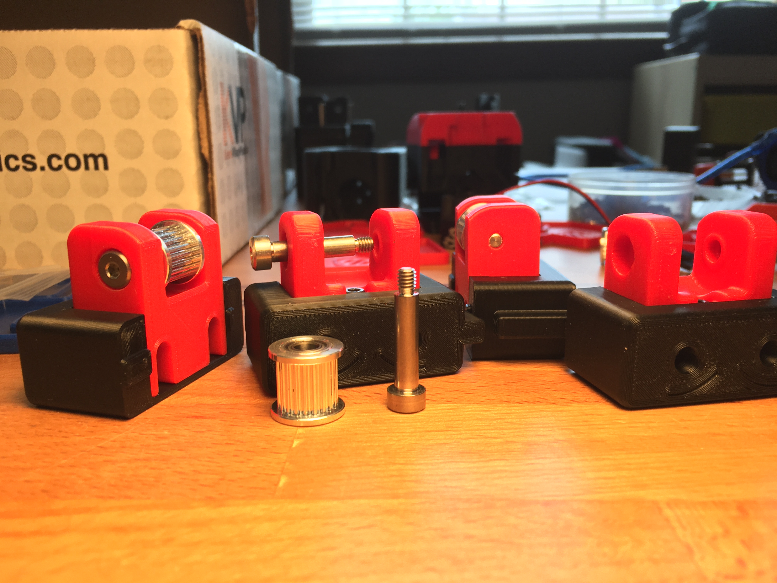
printer_mods/jasonc/Z_Idler_Shoulder_Bolt/shoulder_bolts_and_prints.jpeg
