christophmuellerorg/VoronUsers/printer_mods/Kruppes/Closed_Bottom/Fancy_Panel/fancy_dimensions.png

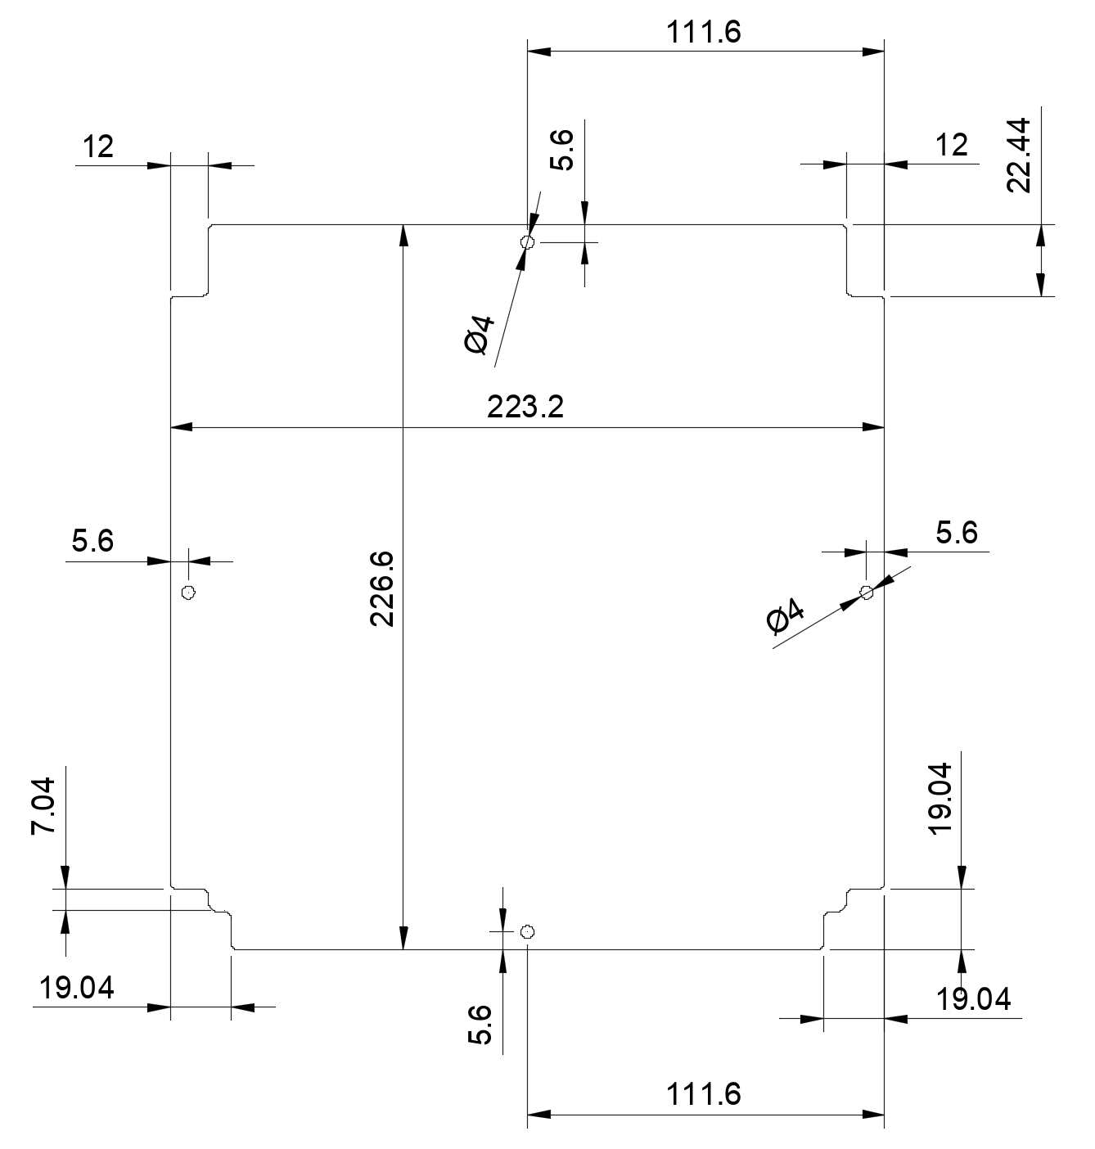
printer_mods/Kruppes/Closed_Bottom/Fancy_Panel/fancy_dimensions.png
