christophmuellerorg/VoronUsers/printer_mods/Kruppes/Closed_Bottom/Simple_Panel/simple_dimensions.png

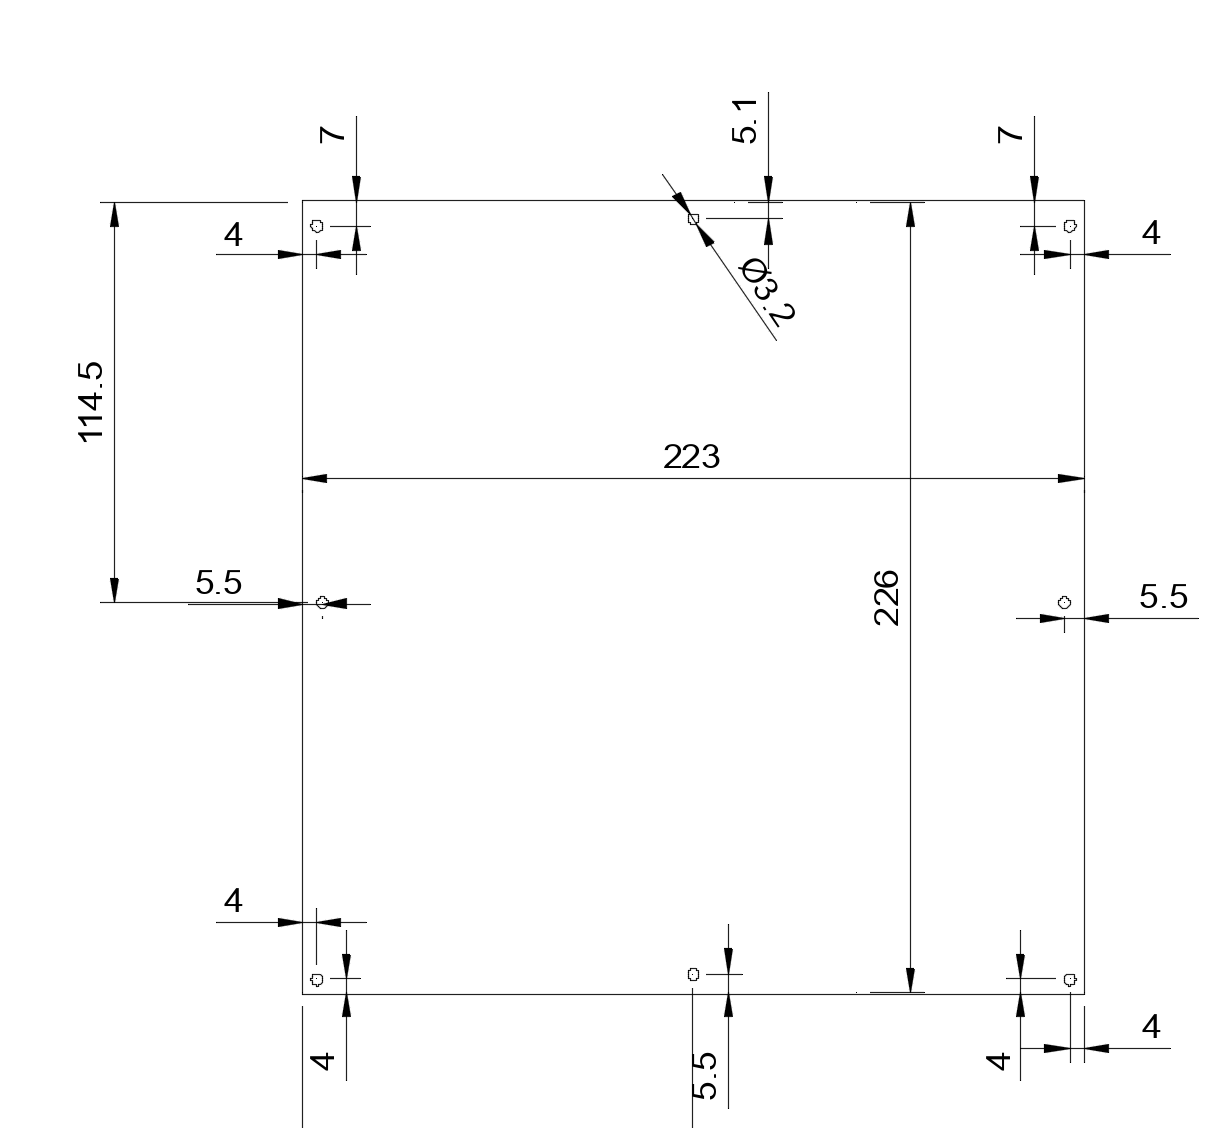
printer_mods/Kruppes/Closed_Bottom/Simple_Panel/simple_dimensions.png
