christophmuellerorg/VoronUsers/printer_mods/littleferris/V0_Skirt_Inlet/img/V0_inlet2.jpg

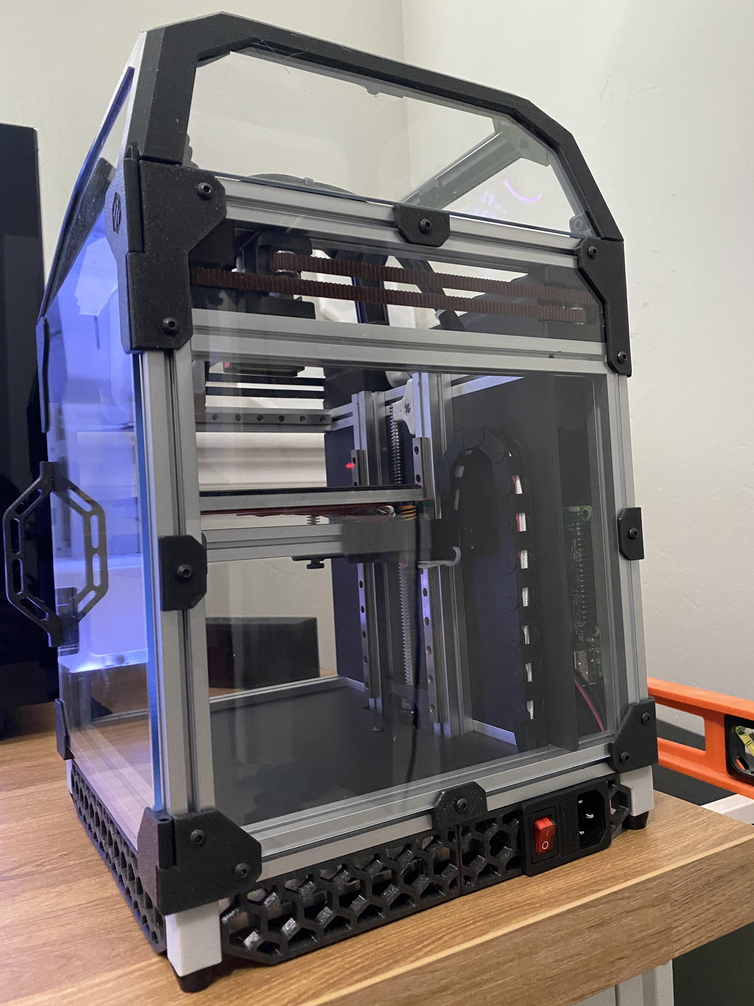
printer_mods/littleferris/V0_Skirt_Inlet/img/V0_inlet2.jpg
