christophmuellerorg/VoronUsers/printer_mods/MarcPot/UHP_PSU_Bracket_Clip/Images/insert.JPEG

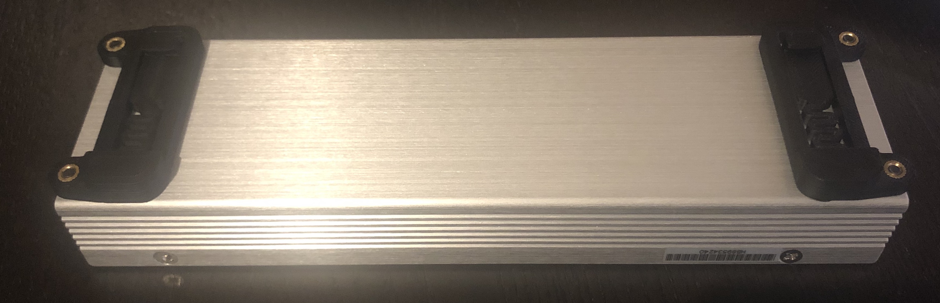
printer_mods/MarcPot/UHP_PSU_Bracket_Clip/Images/insert.JPEG
