christophmuellerorg/VoronUsers/printer_mods/mjoaris/10x11_Cable_Chain_Endcaps/Images/10x11-chain-endcap2_nosupport.PNG

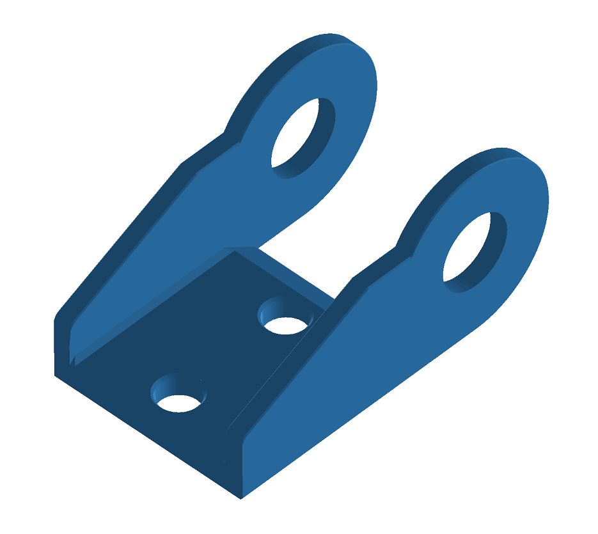
printer_mods/mjoaris/10x11_Cable_Chain_Endcaps/Images/10x11-chain-endcap2_nosupport.PNG
