christophmuellerorg/VoronUsers/printer_mods/Nomsplease/V0_Mods/duet_wifi_mount/Images/back_compartment.jpg

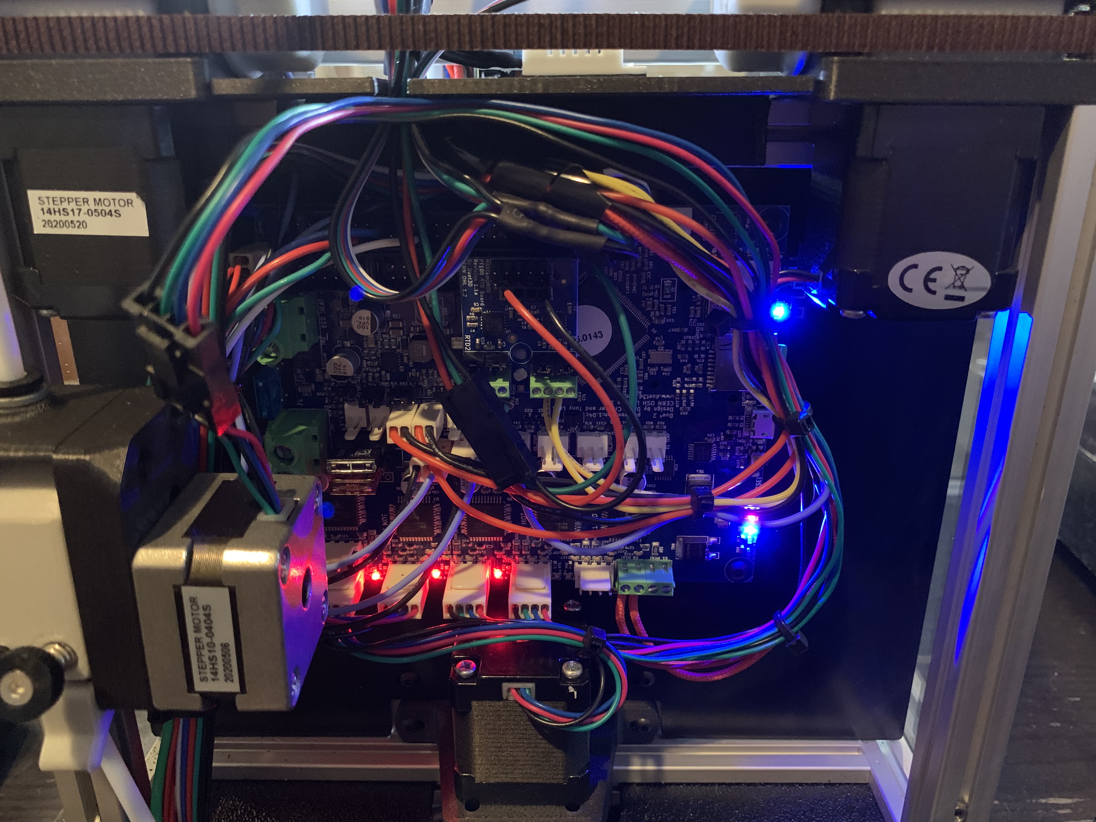
printer_mods/Nomsplease/V0_Mods/duet_wifi_mount/Images/back_compartment.jpg
