christophmuellerorg/VoronUsers/printer_mods/Nomsplease/V0_Mods/duet_wifi_mount/Images/closed_back.jpg

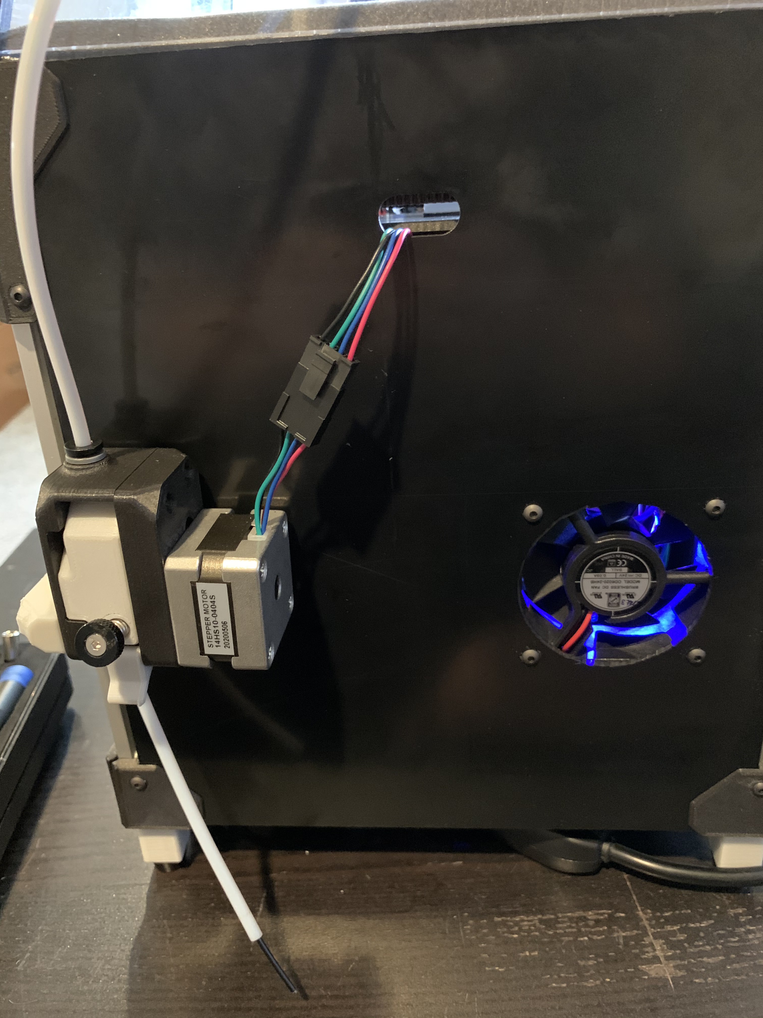
printer_mods/Nomsplease/V0_Mods/duet_wifi_mount/Images/closed_back.jpg
