christophmuellerorg/VoronUsers/printer_mods/randell/Door_Hinges/Images/image_5.png

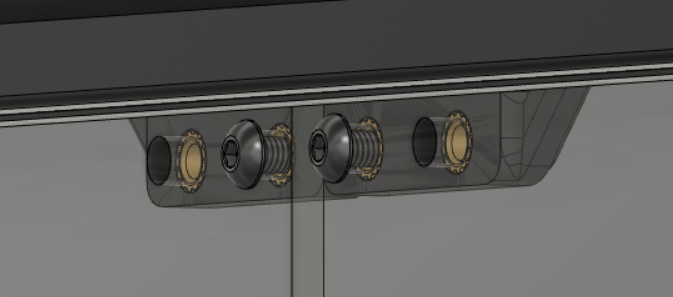
printer_mods/randell/Door_Hinges/Images/image_5.png
