christophmuellerorg/VoronUsers/(commit log)

2020-11-19 Beta testing: STL files for my V0 mods
    [cover.stl, cover_skirt_front.step, flippy_2mm_panel.stl, flippy_3mm_panel.stl, flippy_no_panel.stl, flippy_spool_holder.stl, skirt.stl, split_bottom.stl]
2020-11-19 Beta testing: extended feet added
    [extended_feet.stl]
